heyitsarthur/COEN490/490_0/Parts/Symbols/Datasheets/TP4056-Mini-USB-1.png

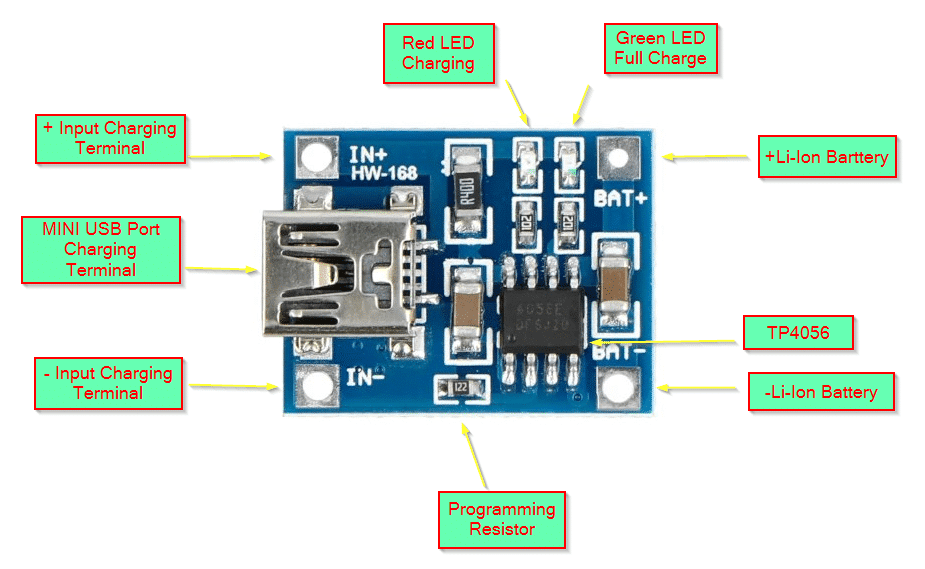
490_0/Parts/Symbols/Datasheets/TP4056-Mini-USB-1.png
