heyitsarthur/COEN490/PCB Footprint Errors.jpg

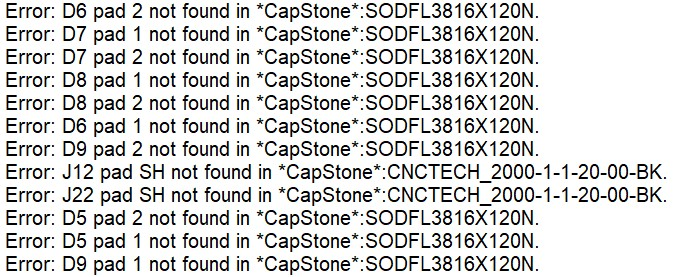
PCB Footprint Errors.jpg
