heyitsarthur/COEN490/PCB Overview Progress.jpg

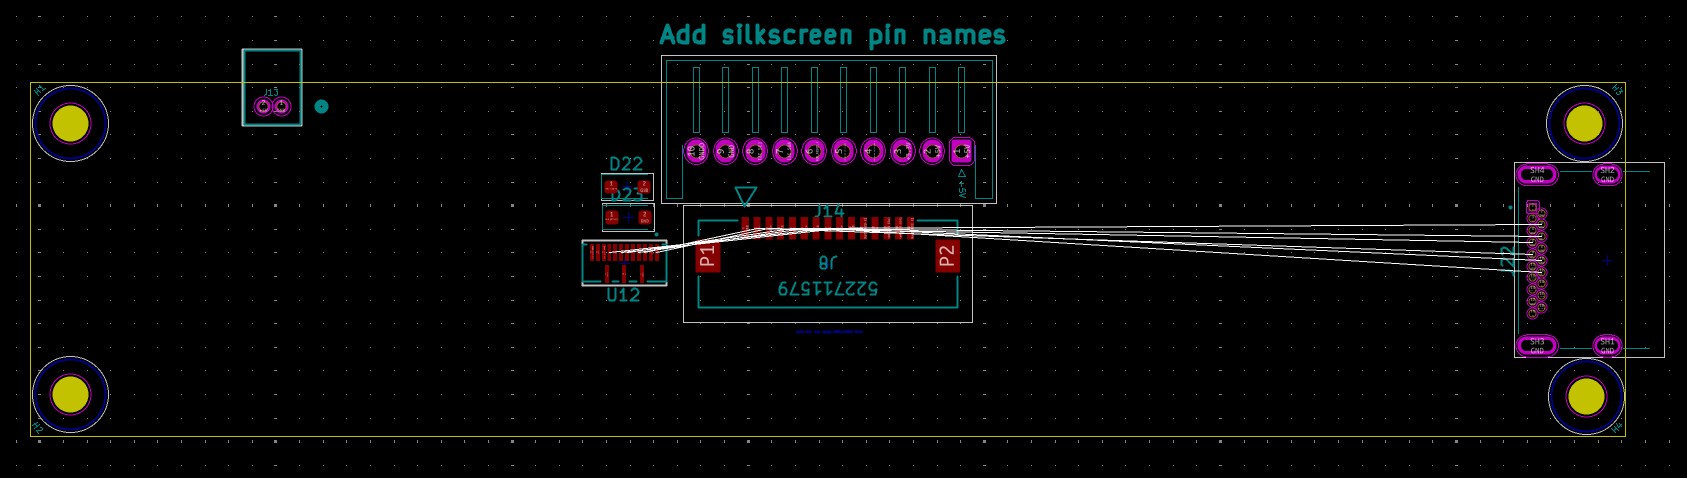
PCB Overview Progress.jpg
