heyitsarthur/COEN490/Schematic_BOM_BlockDiagram/490-24_Bill_of_Materials - External Components.xls

Company: | Concordia University, Department of Electrical and Computer Engineering
Project: | Object Recognition and Haptic Guidance Headband for Blind Users #24
Design ref.: | External Components
Prepared by: | Arthur Mosnier, Ferhaan Hawas, Frankies Vat, Anass Taoussi, Gabriel Lemieux, Ardalan Jamshidi
Rev.# | 3 | Date: | March 3, 2026
Approved by:
Item # | Design Refererence # | Description | Value | QTY | Unit | Manufacturer | Manufacturer Part# | Package | Type | Supplier | Supplier P/N | Price | Ext.price | Link
1 | LS1 | SPEAKER 8OHM 1W TOP PORT 90DB | SP-3605 | 1 | pcs | Soberton Inc. | SP-3605 | Tray |  | DigiKey | 433-1150-ND | 3.16 | 3.16 | https://www.digikey.ca/en/products/detail/soberton-inc/SP-3605/6562949
2 | MOD1 | RASPBERRY PI COMPUTE MOD 4; RAM:8GB; eMMC:16GB; WiFi enabled | CM4108016 | 1 | pcs | Raspberry Pi | SC0677 |  |  | DigiKey | 2648-SC0677-ND | 130 | 130 | https://www.digikey.ca/en/products/detail/raspberry-pi/SC0677/13530927
3 | BT1 | 7.4V 3000mAh 15C 2S JST-2P Plug Li-ion Battery with USB Charging Cable for RC Car, Truck, Ship & Drone | 7.4V 3000mAh 15C 2S | 1 | pcs | AMZZN | 732367471666 |  | 2S1P | Amazon | B0D4M26GF6 | 16.79 | 16.79 | https://www.amazon.ca/AMZZN-3000mAh-Battery-Charging-Engineering/dp/B0D4M26GF6?s=electronics
4 | IO1 | Raspberry Pi Compute Module 4 Carrier Board Interface Raspberry Pi Compute Module 4 Platform Evaluation Expansion Board | SC0326 | 1 | pcs | Raspberry Pi | SC0326 |  | IO BOARD | DigiKey | 2648-SC0326-ND | 35 | 35 | https://www.amazon.ca/AMZZN-3000mAh-Battery-Charging-Engineering/dp/B0D4M26GF6?s=electronics
5 | W1-3 | Black 22 AWG Jumper Lead Socket to Socket Tin 12.0" (304.8mm) | 12.0" (304.8mm) | 3 | pcs | JST Sales America Inc. | ASXHSXH22K305 | Bulk | JUMPER SXH-001T-P0.6 X2 12" | DigiKey | 455-3241-ND | 0.81 | 2.43 | https://www.digikey.ca/en/products/detail/jst-sales-america-inc/ASXHSXH22K305/6684932
6 | JP1, JP2 | CONN JUMPER SHORTING .100" GOLD | QPC02SXGN-RC | 2 | pcs | Sullins Connector Solutions | QPC02SXGN-RC | Bulk | 2 (1 x 2) Position Shunt Connector Black Open Top 0.100" (2.54mm) Gold | DigiKey | S9337-ND | 0.1 | 0.2 | https://www.digikey.ca/en/products/detail/sullins-connector-solutions/QPC02SXGN-RC/2618262
7 | J1,J2 | 3 Rectangular Connectors - Housings Receptacle Natural 0.098" (2.50mm) | XHP-3 | 2 | pcs | JST Sales America Inc. | XHP-3 | Bulk | CONN RCPT HSG 3POS 2.50MM | DigiKey | 455-2219-ND | 0.1 | 0.2 | https://www.digikey.ca/en/products/detail/jst-sales-america-inc/xhp-3/1651017
8
9
10
11
12
 |  |  |  |  |  |  |  |  |  |  |  | Total: | 187.7800
 |  |  |  |  | This is optional information. You don't have to include it.
 |  |  |  | Board summary
 |  |  |  | Total # of components to install |  | 0 |  | Total BOM items to install |  |  | 0
 |  |  |  |  | SMD | 0 |  |  |  | SMD | 0
 |  |  |  |  | thru-hole | 0 |  |  |  | Throu-hole | 0
