heyitsarthur/COEN490/Schematic_BOM_BlockDiagram/490-24_Bill_of_Materials - PCB1.xls

Company: | Concordia University, Department of Electrical and Computer Engineering
Project: | Object Recognition and Haptic Guidance Headband for Blind Users #24
Design ref.: | PCB 1 - CHEST
Prepared by: | Arthur Mosnier, Ferhaan Hawas, Frankies Vat, Anass Taoussi, Gabriel Lemieux, Ardalan Jamshidi
Rev.# | 5 | Date: | March 22, 2026
Approved by:
Item # | Design Refererence # | Description | Value | QTY | Unit | Manufacturer | Manufacturer Part# | Package | Type | Supplier | Supplier P/N | Price | Ext.price | Link
1 | U18 | TVS DIODE 5.5VWM 15SON | TPD8S009DSMR | 1 | pcs | Texas Instruments | TPD8S009DSMR | 15-SMD, No Lead | SMD | DigiKey | 296-23829-1-ND | 1.8200 | 1.8200 | https://www.digikey.ca/en/products/detail/texas-instruments/TPD8S009DSMR/1907466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
2 | D24 | TVS DIODE 3.3VWM 8.8VC SOD123FL | GSMF3.3A | 1 | pcs | Good-Ark Semiconductor | GSMF3.3A | SOD-123FL | SMD | DigiKey | 4786-GSMF3.3ACT-ND | 0.2200 | 0.2200 | https://www.digikey.ca/en/products/detail/good-ark-semiconductor/GSMF3-3A/24613089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
4 | J20 | TERM BLK 2POS SIDE ENT 3.5MM PCB | YO0201500000G | 1 | pcs | Amphenol Anytek | YO0201500000G | Bulk | Through Hole | DigiKey | 609-4725-ND | 0.6400 | 0.6400 | https://www.digikey.ca/en/products/detail/amphenol-anytek/YO0201500000G/4242160?gclsrc=aw.ds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
5 | SW2,SW3,SW4,SW5,SW6,SW7,SW8 | Tactile Switch SPST-NO Top Actuated Through Hole | TL1105LF160Q | 7 | pcs | E-Switch | TL1105LF160Q |  | Through Hole, Right Angle | DigiKey | EG2505-ND | 0.3300 | 2.3100 | https://www.digikey.ca/en/products/detail/e-switch/tl1105lf160q/378971
6 | SW1 | Switch, dual pole double throw, separate symbols | TL2230EEF140 | 1 | pcs | E-Switch | TL2230EEF140 | Bulk | Through Hole | DigiKey | EG6031-ND | 0.8500 | 0.8500 | https://www.digikey.ca/en/products/detail/e-switch/TL2230EEF140/4029358
7 | R27 | RES SMD 27.4K OHM 0.1% 1/4W 0805 | 27.4k | 1 | pcs | Panasonic Electronic Components | ERJ-PB6B2742V | 0805 | SMD | DigiKey | P20756CT-ND | 0.2100 | 0.2100 | https://www.digikey.ca/en/products/detail/panasonic-electronic-components/ERJ-PB6B2742V/6213539
8 | R29 | RES SMD 15K OHM 1% 1/8W 0805 | 15k | 1 | pcs | YAGEO | AC0805FR-0715KL | 0805 | SMD | DigiKey | YAG3695CT-ND | 0.1000 | 0.1000 | https://www.digikey.ca/en/products/detail/yageo/AC0805FR-0715KL/5896576
9 | R8 | RES 76.8K OHM 1% 1/8W 0805 | 76.8k | 1 | pcs | YAGEO | RC0805FR-0776K8L | 0805 | SMD | DigiKey | 311-76.8KCRCT-ND | 0.1000 | 0.1000 | https://www.digikey.ca/en/products/detail/yageo/RC0805FR-0776K8L/728137
10 | R37,R44 | RES 470 OHM 1% 1/8W 0805 | 470 | 2 | pcs | YAGEO | RC0805FR-07470RL | 0805 | SMD | DigiKey | RC0805FR-07470RL | 0.1000 | 0.2000 | https://www.digikey.ca/en/products/detail/yageo/RC0805FR-07470RL/727976
11 | R25 | RES 30K OHM 1% 1/8W 0805 | 30k | 1 | pcs | YAGEO | RC0805FR-1330KL | 0805 | SMD | DigiKey | 13-RC0805FR-1330KLCT-ND | 0.1000 | 0.1000 | https://www.digikey.ca/en/products/detail/yageo/RC0805FR-1330KL/17020068
12 | R24 | RES 30.1K OHM 1% 1/8W 0805 | 30.1k | 1 | pcs | YAGEO | RC0805FR-0730K1L | 0805 | SMD | DigiKey | 311-30.1KCRCT-ND | 0.1000 | 0.1000 | https://www.digikey.ca/en/products/detail/yageo/RC0805FR-0730K1L/727845
13 | R9 | RES 24.3K OHM 1% 1/8W 0805 | 24.3k | 1 | pcs | YAGEO | RC0805FR-0724K3L | 0805 | SMD | DigiKey | 311-24.3KCRCT-ND | 0.1000 | 0.1000 | https://www.digikey.ca/en/products/detail/yageo/RC0805FR-0724K3L/727758
14 | R22 | RES 220K OHM 1% 1/8W 0805 | 220k | 1 | pcs | YAGEO | RC0805FR-07220KL | 0805 | SMD | DigiKey | 311-220KCRCT-ND | 0.1000 | 0.1000 | https://www.digikey.ca/en/products/detail/yageo/RC0805FR-07220KL/727742
15 | R2,R36 | RES 215K OHM 1% 1/8W 0805 | 215k | 2 | pcs | YAGEO | RC0805FR-07215KL | 0805 | SMD | DigiKey | 311-215KCRCT-ND | 0.1000 | 0.2000 | https://www.digikey.ca/en/products/detail/yageo/RC0805FR-07215KL/727734
16 | R35 | RES 120K OHM 1% 1/8W 0805 | 120k | 1 | pcs | YAGEO | RC0805FR-07120KL | 0805 | SMD | DigiKey | 311-120KCRCT-ND | 0.1000 | 0.1000 | https://www.digikey.ca/en/products/detail/yageo/RC0805FR-07120KL/727576
17 | R10,R26,R32 | RES 10K OHM 1% 1/8W 0805 | 10k | 3 | pcs | YAGEO | RC0805FR-0710KL | 0805 | SMD | DigiKey | 311-10.0KCRCT-ND | 0.1400 | 0.4200 | https://www.digikey.ca/en/products/detail/yageo/RC0805FR-0710KL/727535
18 | R1,R23 | RES 100K OHM 1% 1/8W 0805 | 100k | 2 | pcs | YAGEO | RC0805FR-07100KL | 0805 | SMD | DigiKey | 311-100KCRCT-ND | 0.1000 | 0.2000 | https://www.digikey.ca/en/products/detail/yageo/RC0805FR-07100KL/727544
19 | R28,R30,R31,R33,R34 | RES 1.5K OHM 1% 1/8W 0805 | 1.5k | 5 | pcs | YAGEO | RC0805FR-071K5L | 0805 | SMD | DigiKey | 311-1.50KCRCT-ND | 0.1000 | 0.5000 | https://www.digikey.ca/en/products/detail/yageo/RC0805FR-071K5L/727496
20 | Q6 | P-Channel 50 V 130mA (Ta) 225mW (Ta) Surface Mount SOT-23-3 (TO-236) | BSS84 | 1 | pcs | onsemi | BSS84 | SOT-23-3 (TO-236) | SMD | DigiKey | BSS84CT-ND | 0.3400 | 0.3400 | https://www.digikey.ca/en/products/detail/onsemi/bss84/244213
23 | D15 | LED YELLOW CLEAR SMD | LTST-C170YKT | 1 | pcs | Lite-On Inc. | LTST-C170YKT | SMD | 0805 (2012 Metric) | DigiKey | 160-1175-1-ND | 0.1500 | 0.1500 | https://www.digikey.ca/en/products/detail/lite-on-inc/LTST-C170YKT/269222
24 | D17 | LED RED CLEAR SMD | LTST-C170KRKT | 1 | pcs | Lite-On Inc. | LTST-C170KRKT | SMD | 0805 (2012 Metric) | DigiKey | 160-1415-1-ND | 0.1600 | 0.1600 | https://www.digikey.ca/en/products/detail/liteon/LTST-C170KRKT/386779
25 | D11,D12,D13,D14,D16 | LED GREEN CLEAR SMD | LTST-C170GKT | 5 | pcs | Lite-On Inc. | LTST-C170GKT | SMD | 0805 (2012 Metric) | DigiKey | 160-1179-1-ND | 0.1000 | 0.5000 | https://www.digikey.ca/en/products/detail/liteon/LTST-C170GKT/269226
26 | U5 | IC USB SWITCH DUAL 1X2 10UQFN | TS3USB221AQRSERQ1 | 1 | pcs | Texas Instruments | TS3USB221AQRSERQ1 | 10-UFQFN | SMD | DigiKey | 296-27719-1-ND | 0.9000 | 0.9000 | https://www.digikey.ca/en/products/detail/texas-instruments/TS3USB221AQRSERQ1/2356129
27 | U7 | IC REG BUCK ADJ 6A SOT563 | TPS566247DRLR | 1 | pcs | Texas Instruments | TPS566247DRLR | SOT-563 | SMD | DigiKey | 296-TPS566247DRLRCT-ND | 0.7700 | 0.7700 | https://www.digikey.ca/en/products/detail/texas-instruments/TPS566247DRLR/16553859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
28 | U8 | IC BATT CHG LI-ION 2CELL 26QFN | MP2639AGR-Z | 1 | pcs | Monolithic Power Systems Inc. | MP2639AGR-Z | 26-PowerVFQFN | SMD | DigiKey | 1589-1618-1-ND | 3.4900 | 3.4900 | https://www.digikey.ca/en/products/detail/monolithic-power-systems-inc/MP2639AGR-Z/7690044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
29 | J12,J14 | HDMI Receptacle Connector 19 Position Through Hole, Right Angle | 2000-1-1-20-00-BK | 2 | pcs | CNC Tech | 2000-1-1-20-00-BK | Tray | Through Hole, Right Angle | DigiKey | 1175-1700-ND | 1.9900 | 3.9800 | https://www.digikey.ca/en/products/detail/cnc-tech/2000-1-1-20-00-BK/4867009
30 | L1,L2 | FIXED IND 2.2UH 9A 15.5 MOHM SMD | 2.2u | 2 | pcs | Bourns Inc. | SRP6540-2R2M | Nonstandard | SMD | DigiKey | SRP6540-2R2MCT-ND | 1.1100 | 2.2200 | https://www.digikey.ca/en/products/detail/bourns-inc/srp6540-2r2m/3986093
31 | D10 | DIODE SCHOTTKY 30V 3A SMB | B330B-13-F | 1 | pcs | Diodes Incorporated | B330B-13-F | DO-214AA, SMB | SMD | DigiKey | B330B-FDICT-ND | 0.4400 | 0.4400 | https://www.digikey.ca/en/products/detail/diodes-incorporated/b330b-13-f/724947
32 | J7 | CONN RCPT USB2.0 MICRO B SMD R/A | 629105150521 | 1 | pcs | WÃ¼rth Elektronik | 629105150521 |  | Surface Mount, Right Angle; Through Hole | DigiKey | 732-5960-1-ND | 2.2100 | 2.2100 | https://www.digikey.ca/en/products/detail/w%C3%BCrth-elektronik/629105150521/5047751
33 | J16,J17 | CONN RCPT 100POS SMD GOLD | DF40HC(3.0)-100DS-0.4V(58) | 2 | pcs | Hirose Electric Co Ltd | DF40HC(3.0)-100DS-0.4V(58) |  | SMD | DigiKey | H124602CT-ND | 2.7200 | 5.4400 | https://www.digikey.ca/en/products/detail/hirose-electric-co-ltd/DF40HC-3-0-100DS-0-4V-58/4282912
34 | J18 | CONN HEADER VERT 3POS 2.54MM | TS-103-G-A | 1 | pcs | Samtec Inc. | TS-103-G-A |  | Through Hole | DigiKey | SAM1111-03-ND | 1.2700 | 1.2700 | https://www.digikey.ca/en/products/detail/samtec-inc/TS-103-G-A/1105459
35 | J21 | CONN HEADER VERT 2POS 2.54MM | TS-102-G-A | 1 | pcs | Samtec Inc. | TS-102-G-A |  | Through Hole | DigiKey | SAM1111-02-ND | 0.9500 | 0.9500 | https://www.digikey.ca/en/products/detail/samtec-inc/ts-102-g-a/1105460
36 | J11,J15 | CONN HEADER R/A 3POS 2.5MM | S3B-XH-A | 2 | pcs | JST Sales America Inc. | S3B-XH-A | Bulk | Through Hole, Right Angle | DigiKey | 455-S3B-XH-A-ND | 0.1500 | 0.3000 | https://www.digikey.ca/en/products/detail/jst-sales-america-inc/S3B-XH-A/1651048
38 | U9,U10 | CMC 100MA 4LN SMD ESD | EMI8142MUTAG | 2 | pcs | onsemi | EMI8142MUTAG | 10-XFDFN | SMD | DigiKey | EMI8142MUTAGOSCT-ND | 0.9700 | 1.9400 | https://www.digikey.ca/en/products/detail/onsemi/EMI8142MUTAG/5257557
39 | C45,C47,C50 | CAP CER 4.7UF 10V X7R 0603 | 4.7u | 3 | pcs | Murata Electronics | GRM188Z71A475KE15D | 0603 (1608 Metric) | SMD, MLCC | DigiKey | 490-GRM188Z71A475KE15DCT-ND | 0.2200 | 0.6600 | https://www.digikey.ca/en/products/detail/murata-electronics/GRM188Z71A475KE15D/13904882
40 | C36 | CAP CER 33PF 50V C0G/NP0 0603 | 33pF | 1 | pcs | KEMET | 399-C0603C330J5GACTUCT-ND | 0603 | SMD, MLCC | DigiKey | 399-C0603C330J5GACTUCT-ND | 0.1200 | 0.1200 | https://www.digikey.ca/en/products/detail/kemet/c0603c330j5gactu/411057
41 | C44 | CAP CER 22UF 25V X7R 1210 | 22u | 1 | pcs | Taiyo Yuden | TMK325B7226KM-PR | 1210 (3225 Metric) | SMD, MLCC | DigiKey | 587-5480-1-ND | 0.5800 | 0.5800 | https://www.digikey.ca/en/products/detail/taiyo-yuden/TMK325B7226KM-PR/7067065
42 | C37,C38,C39,C40,C46 | CAP CER 22UF 16V X7R 1210 | 22u | 5 | pcs | Samsung Electro-Mechanics | CL32B226MOJNNNE | 1210 (3225 Metric) | SMD, MLCC | DigiKey | 1276-3395-1-ND | 0.4100 | 2.0500 | https://www.digikey.ca/en/products/detail/samsung-electro-mechanics/CL32B226MOJNNNE/3889053
43 | C48 | CAP CER 1UF 50V X7R 0603 | 1u | 1 | pcs | Taiyo Yuden | UMK107AB7105KA-T | 0603 | SMD, MLCC | DigiKey | 587-3247-1-ND | 0.0800 | 0.0800 | https://www.digikey.ca/en/products/detail/taiyo-yuden/UMK107AB7105KA-T/3660085
44 | C43 | CAP CER 1UF 25V X7R 1206 | 1u | 1 | pcs | Samsung Electro-Mechanics | CL31B105KAHNNNE | 1206 (3216 Metric) | SMD, MLCC | DigiKey | 1276-1097-1-ND | 0.1300 | 0.1300 | https://www.digikey.ca/en/products/detail/samsung-electro-mechanics/CL31B105KAHNNNE/3886755
45 | C32,C33,C34 | CAP CER 10UF 25V X7R 1206 | 10u | 3 | pcs | Samsung Electro-Mechanics | CL31B106KAHNNNE | 1206 (3216 Metric) | SMD, MLCC | DigiKey | 1276-1804-1-ND | 0.0800 | 0.2400 | https://www.digikey.ca/en/products/detail/samsung-electro-mechanics/CL31B106KAHNNNE/3887462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
46 | C2,C6 | CAP CER 10UF 16V X7R 0805 | 10u | 2 | pcs | Samsung Electro-Mechanics | CL21B106KOQNNNE | 0805 | SMD, MLCC | DigiKey | 1276-2872-1-ND | 0.2200 | 0.4400 | https://www.digikey.ca/en/products/detail/samsung-electro-mechanics/CL21B106KOQNNNE/3888530
47 | C5,C7,C25,C26,C27,C28,C29,C30,C35,C41,C42,C49,C55 | CAP CER 0.1UF 50V X7R 0603 | 100n | 13 | pcs | YAGEO | CC0603KRX7R9BB104 | 0603 (1608 Metric) | SMD, MLCC | DigiKey | 311-1344-1-ND | 0.0800 | 1.0400 | https://www.digikey.ca/en/products/detail/yageo/CC0603KRX7R9BB104/2103082
48 | U1 | Amplifier IC 1-Channel (Mono) Class D 16-TQFN (3x3) | MAX98357A | 1 | pcs | Analog Devices Inc./Maxim Integrated | MAX98357AETE+T | 16-WFQFN Exposed Pad | SMD | DigiKey | MAX98357AETE+TCT-ND | 3.1900 | 3.1900 | https://www.digikey.ca/en/products/detail/analog-devices-inc-maxim-integrated/MAX98357AETE-T/4936122
49 | U11,U13,U14,U19 | 15V Clamp 2.5A (8/20Âµs) Ipp Tvs Diode Surface Mount SOT-553 | SP3003-02XTG | 4 | pcs | Littelfuse Inc. | SP3003-02XTG | SOT-553 | SMD | DigiKey | F3302CT-ND | 0.7000 | 2.8000 | https://www.digikey.ca/en/products/detail/littelfuse-inc/SP3003-02XTG/2060912
 |  |  |  |  |  |  |  |  |  |  |  |  | 0.0000
 |  |  |  |  |  |  |  |  |  |  |  |  | 0.0000
 |  |  |  |  |  |  |  |  |  |  |  |  | 0.0000
 |  |  |  |  |  |  |  |  |  |  |  |  | 0.0000
 |  |  |  |  |  |  |  |  |  |  |  |  | 0.0000
 |  |  |  |  |  |  |  |  |  |  |  | Total: | 44.6600
 |  |  |  |  | This is optional information. You don't have to include it.
 |  |  |  | Board summary
 |  |  |  | Total # of components to install |  | 0 |  | Total BOM items to install |  |  | 0
 |  |  |  |  | SMD | 0 |  |  |  | SMD | 0
 |  |  |  |  | thru-hole | 0 |  |  |  | Throu-hole | 0
