heyitsarthur/COEN490/Schematic_BOM_BlockDiagram/490-24_Bill_of_Materials - PCB2.xls

Company: | Concordia University, Department of Electrical and Computer Engineering
Project: | Object Recognition and Haptic Guidance Headband for Blind Users #24
Design ref.: | PCB 2 - GLASSES
Prepared by: | Arthur Mosnier, Ferhaan Hawas, Frankies Vat, Anass Taoussi, Gabriel Lemieux, Ardalan Jamshidi
Rev.# | 5 | Date: | March 22, 2026
Approved by:
Item # | Design Refererence # | Description | Value | QTY | Unit | Manufacturer | Manufacturer Part# | Package | Type | Supplier | Supplier P/N | Price | Ext.price | Link
1 | U12 | TVS DIODE 5.5VWM 15SON | TPD8S009DSMR | 1 | pcs | Texas Instruments | TPD8S009DSMR | 15-SMD, No Lead | SMD | DigiKey | 296-23829-1-ND | 1.8200 | 1.8200 | https://www.digikey.ca/en/products/detail/texas-instruments/TPD8S009DSMR/1907466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
2 | D22,D23 | TVS DIODE 3.3VWM 8.8VC SOD123FL | GSMF3.3A | 2 | pcs | Good-Ark Semiconductor | GSMF3.3A | SOD-123FL | SMD | DigiKey | 4786-GSMF3.3ACT-ND | 0.2200 | 0.4400 | https://www.digikey.ca/en/products/detail/good-ark-semiconductor/GSMF3-3A/24613089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
4 | R11 | RES 330 OHM 1% 1/8W 0805 | 330 | 1 | pcs | YAGEO | RC0805FR-13330RL | 0805 | SMD | DigiKey | 13-RC0805FR-13330RLCT-ND | 0.1000 | 0.1000 | https://www.digikey.ca/en/products/detail/yageo/RC0805FR-13330RL/14286486
5 | R12,R13,R14,R18,R19 | RES 220 OHM 1% 1/8W 0805 | 220 | 5 | pcs | TE Connectivity Passive Product | CRGCQ0805F220R | 0805 | SMD | DigiKey | A129741CT-ND | 0.1000 | 0.5000 | https://www.digikey.ca/en/products/detail/te-connectivity-passive-product/CRGCQ0805F220R/8576343
6 | R4,R6 | RES 20K OHM 1% 1/4W 0805 | 20k | 2 | pcs | YAGEO | RC0805FR-7W20KL | 0805 | SMD | DigiKey | 13-RC0805FR-7W20KLCT-ND | 0.1100 | 0.2200 | https://www.digikey.ca/en/products/detail/yageo/RC0805FR-7W20KL/17021842
7 | R3,R5 | RES 1K OHM 1% 1/8W 0805 | 1k | 2 | pcs | YAGEO | RC0805FR-071KL | 0805 | SMD | DigiKey | 311-1.00KCRCT-ND | 0.1000 | 0.2000 | https://www.digikey.ca/en/products/detail/yageo/RC0805FR-071KL/727444
8 | R7 | RES 12K OHM 1% 1/8W 0805 | 12k | 1 | pcs | YAGEO | RC0805FR-0712KL | 0805 | SMD | DigiKey | 311-12.0KCRCT-ND | 0.1000 | 0.1000 | https://www.digikey.ca/en/products/detail/yageo/RC0805FR-0712KL/727568
9 | R42,R43,R45,R46 | RES 10K OHM 1% 1/8W 0805 | 10k | 4 | pcs | YAGEO | RC0805FR-0710KL | 0805 | SMD | DigiKey | 311-10.0KCRCT-ND | 0.1400 | 0.5600 | https://www.digikey.ca/en/products/detail/yageo/RC0805FR-0710KL/727535
10 | R15,R16,R17,R20,R21,R39,R40 | RES 100K OHM 1% 1/8W 0805 | 100k | 7 | pcs | YAGEO | RC0805FR-07100KL | 0805 | SMD | DigiKey | 311-100KCRCT-ND | 0.1000 | 0.7000 | https://www.digikey.ca/en/products/detail/yageo/RC0805FR-07100KL/727544
11 | R41 | RES 1.5K OHM 1% 1/8W 0805 | 1.5k | 1 | pcs | YAGEO | RC0805FR-071K5L | 0805 | SMD | DigiKey | 311-1.50KCRCT-ND | 0.1000 | 0.1000 | https://www.digikey.ca/en/products/detail/yageo/RC0805FR-071K5L/727496
12 | Q1,Q2,Q3,Q4,Q5 | MOSFET N-CH 30V 5.7A SOT23-3L | AO3400A | 5 | pcs | Alpha & Omega Semiconductor Inc. | AO3400A | SOT-23-3 | SMD | DigiKey | 785-1000-1-ND | 0.4600 | 2.3000 | https://www.digikey.ca/en/products/detail/alpha-omega-semiconductor-inc/ao3400a/1855772
13 | D18 | LED GREEN CLEAR SMD | LTST-C170GKT | 1 | pcs | Lite-On Inc. | LTST-C170GKT | SMD | 0805 (2012 Metric) | DigiKey | 160-1179-1-ND | 0.1000 | 0.1000 | https://www.digikey.ca/en/products/detail/liteon/LTST-C170GKT/269226
14 | D1,D2 | LED BLUE CLEAR SMD | LTST-C170TBKT | 2 | pcs | Lite-On Inc. | LTST-C170TBKT | SMD | 0805 (2012 Metric) | DigiKey | 160-1579-1-ND | 0.2200 | 0.4400 | https://www.digikey.ca/en/products/detail/lite-on-inc/ltst-c170tbkt/388527?_gl=1*13wf1ri*_up*MQ..*_gs*MQ..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
15 | U2,U3 | IC PWR SWITCH N-CHAN 1:1 SOT23-6 | TPS2553DBVR | 2 | pcs | Texas Instruments | TPS2553DBVR | SOT-23-6 | SMD | DigiKey | 296-32464-1-ND | 0.9700 | 1.9400 | https://www.digikey.ca/en/products/detail/texas-instruments/TPS2553DBVR/2047900
16 | U6 | IC LED DRVR LIN PWM 25MA 28TSSOP | PCA9685 | 1 | pcs | NXP USA Inc. | PCA9685PW,118 | 28-TSSOP (0.173", 4.40mm Width) | SMD | DigiKey | 568-11925-1-ND | 3.0400 | 3.0400 | https://www.digikey.ca/en/products/detail/nxp-usa-inc/PCA9685PW-118/2034325
17 | U4 | IC HUB CTLR 2PORT USB 2.0 HS 36S | USB2512B-I/M2 | 1 | pcs | Microchip Technology | USB2512B-I/M2 | 36-VFQFN Exposed Pad | SMD | DigiKey | USB2512B-I/M2-ND | 2.3800 | 2.3800 | https://www.digikey.ca/en/products/detail/microchip-technology/USB2512B-I-M2/5639464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
18 | J22 | HDMI Receptacle Connector 19 Position Through Hole, Right Angle | 2000-1-1-20-00-BK | 1 | pcs | CNC Tech | 2000-1-1-20-00-BK | Tray | Through Hole, Right Angle | DigiKey | 1175-1700-ND | 1.9900 | 1.9900 | https://www.digikey.ca/en/products/detail/cnc-tech/2000-1-1-20-00-BK/4867009
19 | D5,D6,D7,D8,D9 | DIODE STANDARD 75V 150MA SOD123F | 1N4148W | 5 | pcs | Diotec Semiconductor | 1N4148W | SOD-123F | SMD | DigiKey | 4878-1N4148WCT-ND | 0.1000 | 0.5000 | https://www.digikey.ca/en/products/detail/diotec-semiconductor/1n4148w/18833653
20 | Y1 | CRYSTAL 24MHZ 20PF SMD 3.2X2.5MM | 24M20P2/XT324-10/10 | 1 | pcs | YIC | 24M20P2/XT324-10/10 | 4-SMD, No Lead | SMD | DigiKey | 3155-24M20P2/XT324-10/10CT-ND | 0.1200 | 0.1200 | https://www.digikey.ca/en/products/detail/yic/24M20P2-XT324-10-10/13980850
22 | J23 | CONN HEADER R/A 3POS 2.5MM | S3B-XH-A | 1 | pcs | JST Sales America Inc. | S3B-XH-A | Bulk | Through Hole, Right Angle | DigiKey | 455-S3B-XH-A-ND | 0.1500 | 0.1500 | https://www.digikey.ca/en/products/detail/jst-sales-america-inc/S3B-XH-A/1651048
23 | J4,J5,J6,J9,J10 | CONN HEADER R/A 2POS 2.5MM | PAD | 5 | pcs | JST Sales America Inc. | S2B-XH-A | Bulk | Through Hole, Right Angle | DigiKey | 455-S2B-XH-A-ND | 0.1200 | 0.6000 | https://www.digikey.ca/en/products/detail/jst-sales-america-inc/S2B-XH-A/1651055
24 | J13 | CONN HEADER R/A 2POS 1.5MM | S2B-ZR | 1 | pcs | JST Sales America Inc. | S2B-ZR | Bulk | Through Hole, Right Angle | DigiKey | 455-1669-ND | 0.1100 | 0.1100 | https://www.digikey.ca/en/products/detail/jst-sales-america-inc/s2b-zr/926576
25 | J19 | CONN FFC FPC VERT 15POS 1MM SMD | SFW15S-2STE1LF | 1 | pcs | Amphenol ICC (FCI) | SFW15S-2STE1LF |  | SMD | DigiKey | 609-1148-1-ND | 0.5000 | 0.5000 | https://www.digikey.ca/en/products/detail/amphenol-cs-fci/SFW15S-2STE1LF/1001462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
26 | C8,C16 | CAP TANT 120UF 10% 20V 2824 | 120u | 2 | pcs | Vishay Sprague | 594D127X9020R2T | 2824 (7260 Metric) | SMD | DigiKey | 718-594D127X9020R2TCT-ND | 6.9700 | 13.9400 | https://www.digikey.ca/en/products/detail/vishay-sprague/594D127X9020R2T/1577743
27 | C17,C18 | CAP CER 33PF 50V C0G/NP0 0603 | 33pF | 2 | pcs | KEMET | 399-C0603C330J5GACTUCT-ND | 0603 | SMD, MLCC | DigiKey | 399-C0603C330J5GACTUCT-ND | 0.1200 | 0.2400 | https://www.digikey.ca/en/products/detail/kemet/c0603c330j5gactu/411057
28 | C62 | CAP CER 1UF 50V X7R 0603 | 1u | 1 | pcs | Taiyo Yuden | UMK107AB7105KA-T | 0603 | SMD, MLCC | DigiKey | 587-3247-1-ND | 0.0800 | 0.0800 | https://www.digikey.ca/en/products/detail/taiyo-yuden/UMK107AB7105KA-T/3660085
29 | C1,C4,C12,C13,C15,C20,C22,C24 | CAP CER 10UF 16V X7R 0805 | 10u | 8 | pcs | Samsung Electro-Mechanics | CL21B106KOQNNNE | 0805 | SMD, MLCC | DigiKey | 1276-2872-1-ND | 0.2200 | 1.7600 | https://www.digikey.ca/en/products/detail/samsung-electro-mechanics/CL21B106KOQNNNE/3888530
30 | C3,C9,C10,C11,C14,C19,C21,C23,C31,C53,C54,C56,C57,C58,C59,C60,C61,C63,C64 | CAP CER 0.1UF 50V X7R 0603 | 100n | 19 | pcs | YAGEO | CC0603KRX7R9BB104 | 0603 (1608 Metric) | SMD, MLCC | DigiKey | 311-1344-1-ND | 0.0800 | 1.5200 | https://www.digikey.ca/en/products/detail/yageo/CC0603KRX7R9BB104/2103082
31 | D3,D4 | 21.7A 9.2V 6.4V 5V SOD-123FL | SMF5.0A | 2 | pcs | Shenzhen Slkormicro Semicon Co., Ltd. | SMF5.0A | SOD-123FL | SMD | DigiKey | 5399-SMF5.0ACT-ND | 0.1200 | 0.2400 | https://www.digikey.ca/en/products/detail/shenzhen-slkormicro-semicon-co-ltd/SMF5-0A/26601083
32 | U15,U16,U17 | 15V Clamp 2.5A (8/20Âµs) Ipp Tvs Diode Surface Mount SOT-553 | SP3003-02XTG | 3 | pcs | Littelfuse Inc. | SP3003-02XTG | SOT-553 | SMD | DigiKey | F3302CT-ND | 0.7000 | 2.1000 | https://www.digikey.ca/en/products/detail/littelfuse-inc/SP3003-02XTG/2060912
 |  |  |  |  |  |  |  |  |  |  |  |  | 0.0000
 |  |  |  |  |  |  |  |  |  |  |  |  | 0.0000
 |  |  |  |  |  |  |  |  |  |  |  |  | 0.0000
 |  |  |  |  |  |  |  |  |  |  |  |  | 0.0000
 |  |  |  |  |  |  |  |  |  |  |  |  | 0.0000
 |  |  |  |  |  |  |  |  |  |  |  |  | 0.0000
 |  |  |  |  |  |  |  |  |  |  |  |  | 0.0000
 |  |  |  |  |  |  |  |  |  |  |  |  | 0.0000
 |  |  |  |  |  |  |  |  |  |  |  |  | 0.0000
 |  |  |  |  |  |  |  |  |  |  |  |  | 0.0000
 |  |  |  |  |  |  |  |  |  |  |  |  | 0.0000
 |  |  |  |  |  |  |  |  |  |  |  |  | 0.0000
 |  |  |  |  |  |  |  |  |  |  |  |  | 0.0000
 |  |  |  |  |  |  |  |  |  |  |  | Total: | 38.7900
 |  |  |  |  | This is optional information. You don't have to include it.
 |  |  |  | Board summary
 |  |  |  | Total # of components to install |  | 0 |  | Total BOM items to install |  |  | 0
 |  |  |  |  | SMD | 0 |  |  |  | SMD | 0
 |  |  |  |  | thru-hole | 0 |  |  |  | Throu-hole | 0
