heyitsarthur/COEN490/490_0/Parts/Symbols/Datasheets/USB Micro B - for power and programming.jpg

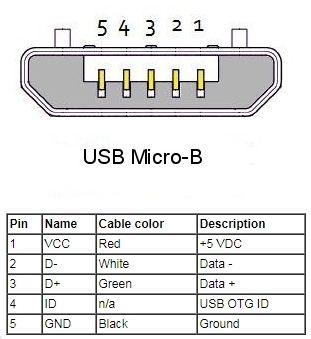
490_0/Parts/Symbols/Datasheets/USB Micro B - for power and programming.jpg
