heyitsarthur/COEN490/Schematic_BOM_BlockDiagram/Glasses PCB layout.jpg

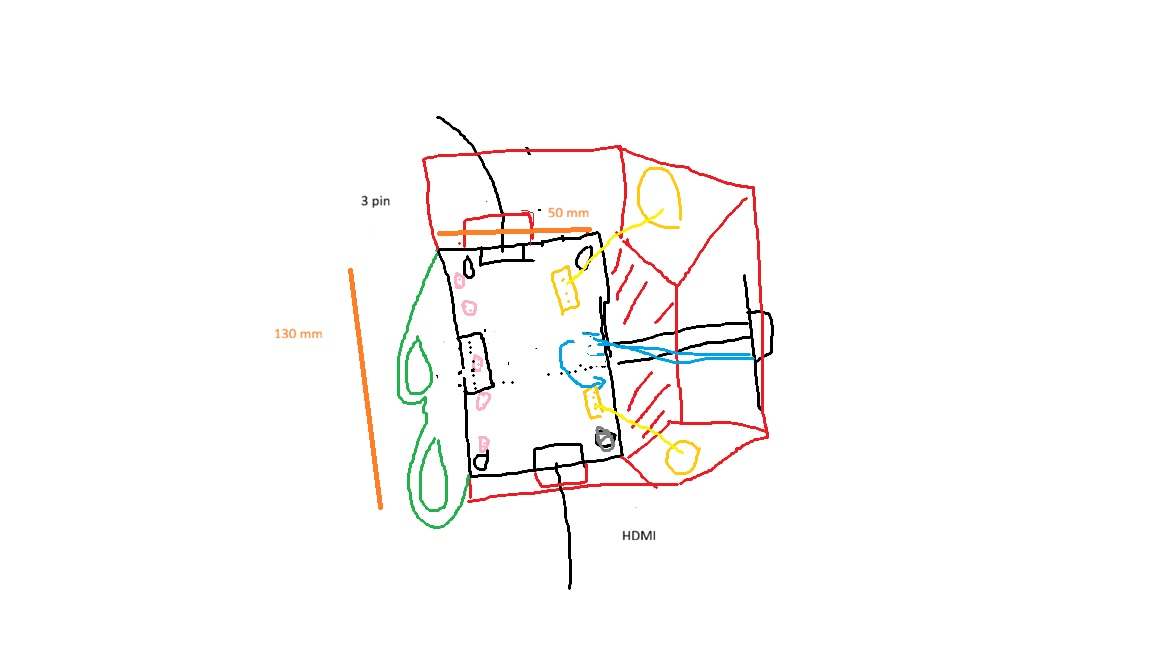
Schematic_BOM_BlockDiagram/Glasses PCB layout.jpg
