heyitsarthur/COEN490/Schematic_BOM_BlockDiagram/V6 System Block Diagram COEN 490 - Revised.drawio.png

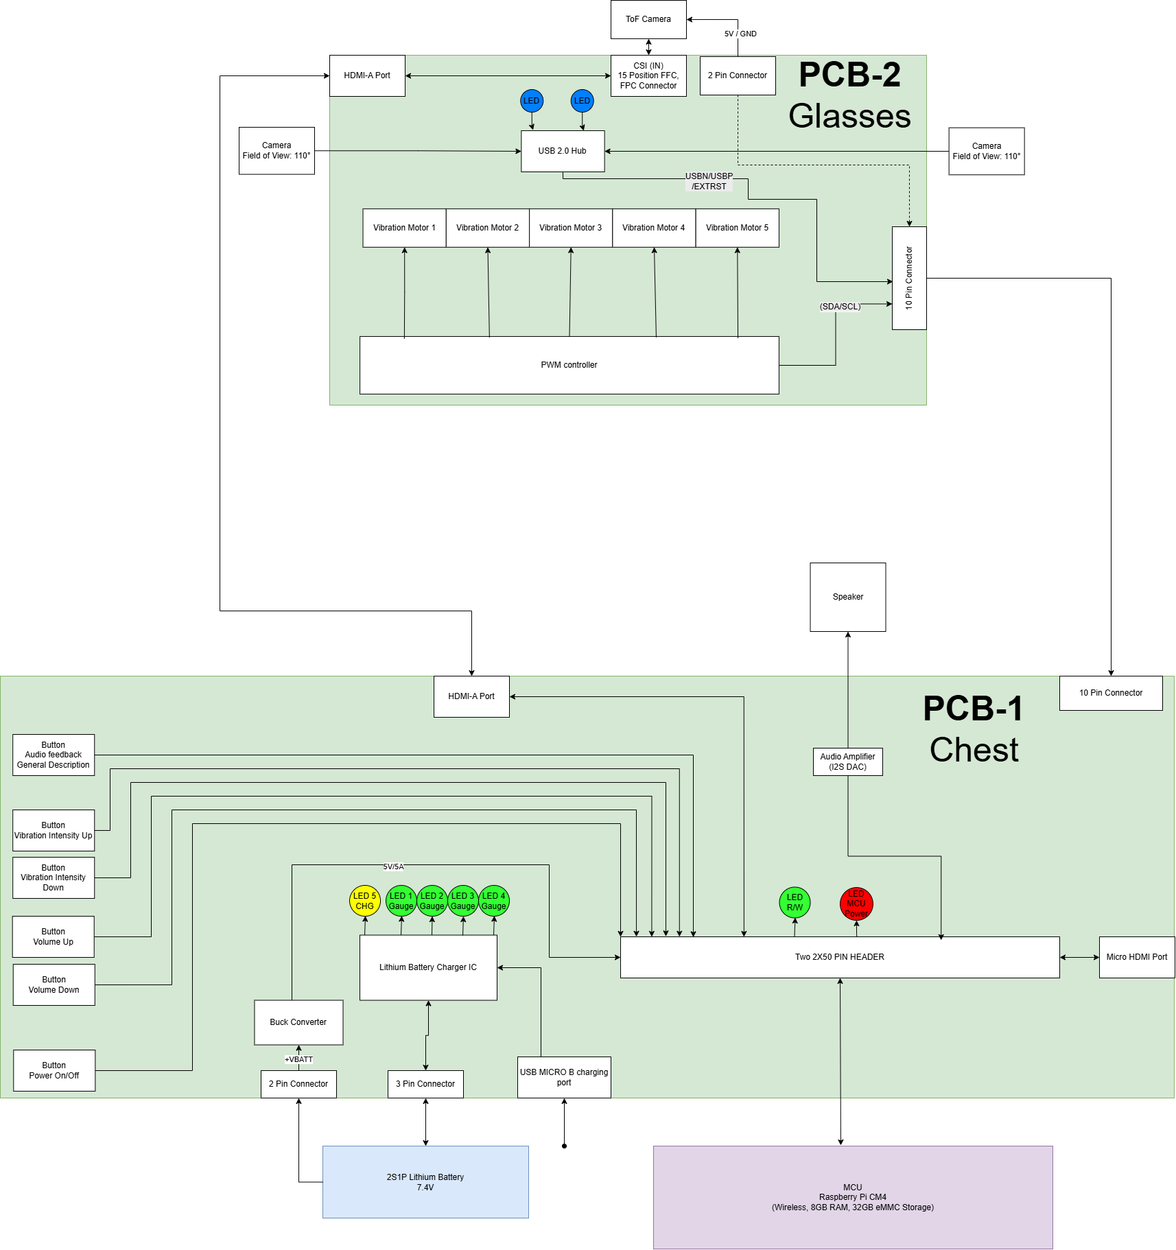
Schematic_BOM_BlockDiagram/V6 System Block Diagram COEN 490 - Revised.drawio.png
