heyitsarthur/COEN490/490_0/Parts/3D Models/2000-1-1-20-00-BK.igs

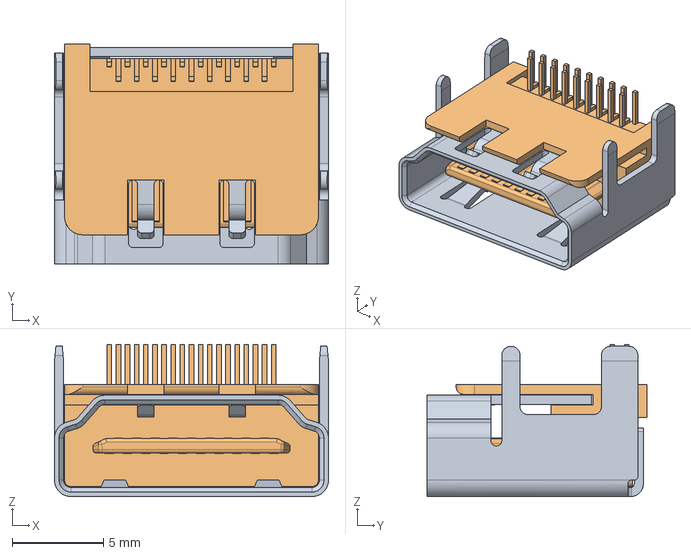
[picture p7: CAD file, 2026-03-20]
490_0/Parts/3D Models/2000-1-1-20-00-BK.igs
15.0 x 12.1 x 8.33 mm
