heyitsarthur/COEN490/Schematic_BOM_BlockDiagram/490-24_Schematic V9.pdf

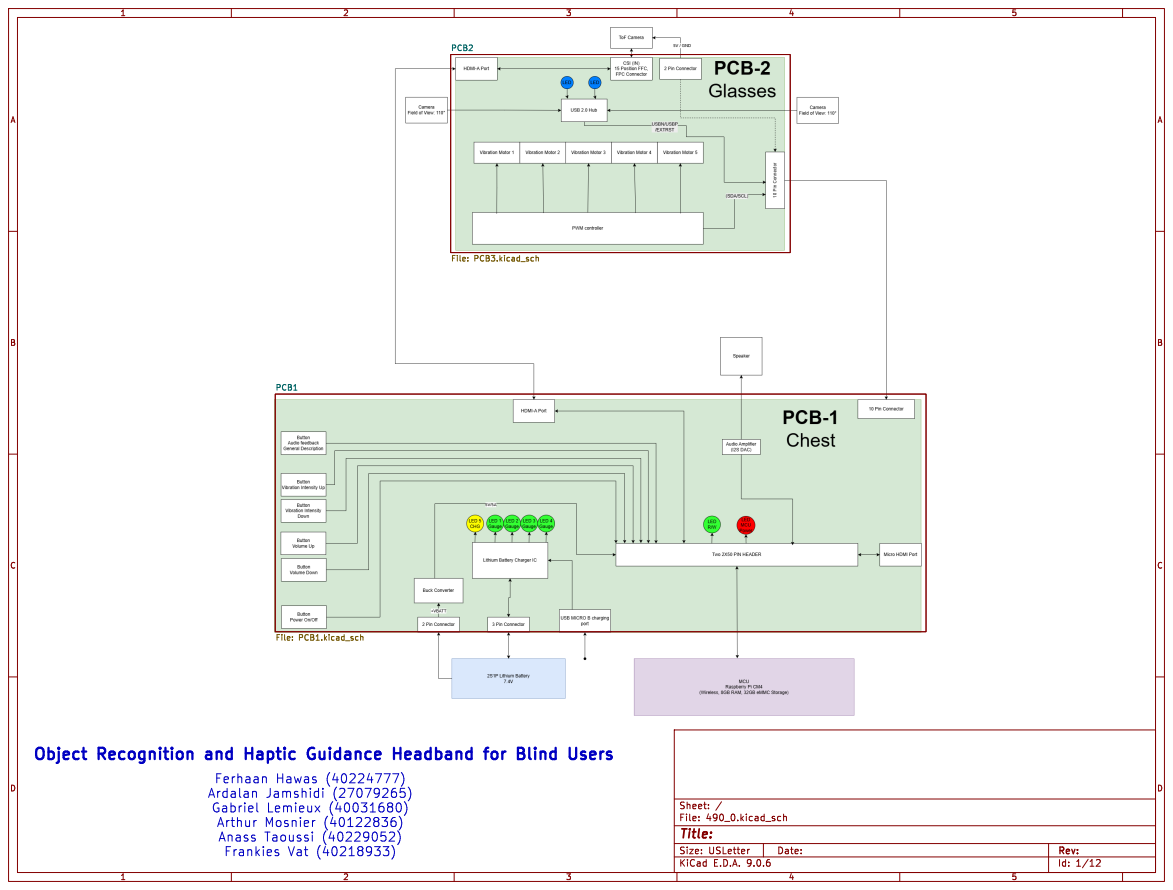
[picture p20: page 1]

Id: 1/12 Title: File: 490_0.kicad_sch Sheet: /


CLK+ CLK- D0+ D0- D1+ D1- SCL SDA

Id: 13/12 Title: File: PCB1.kicad_sch Sheet: /PCB1/

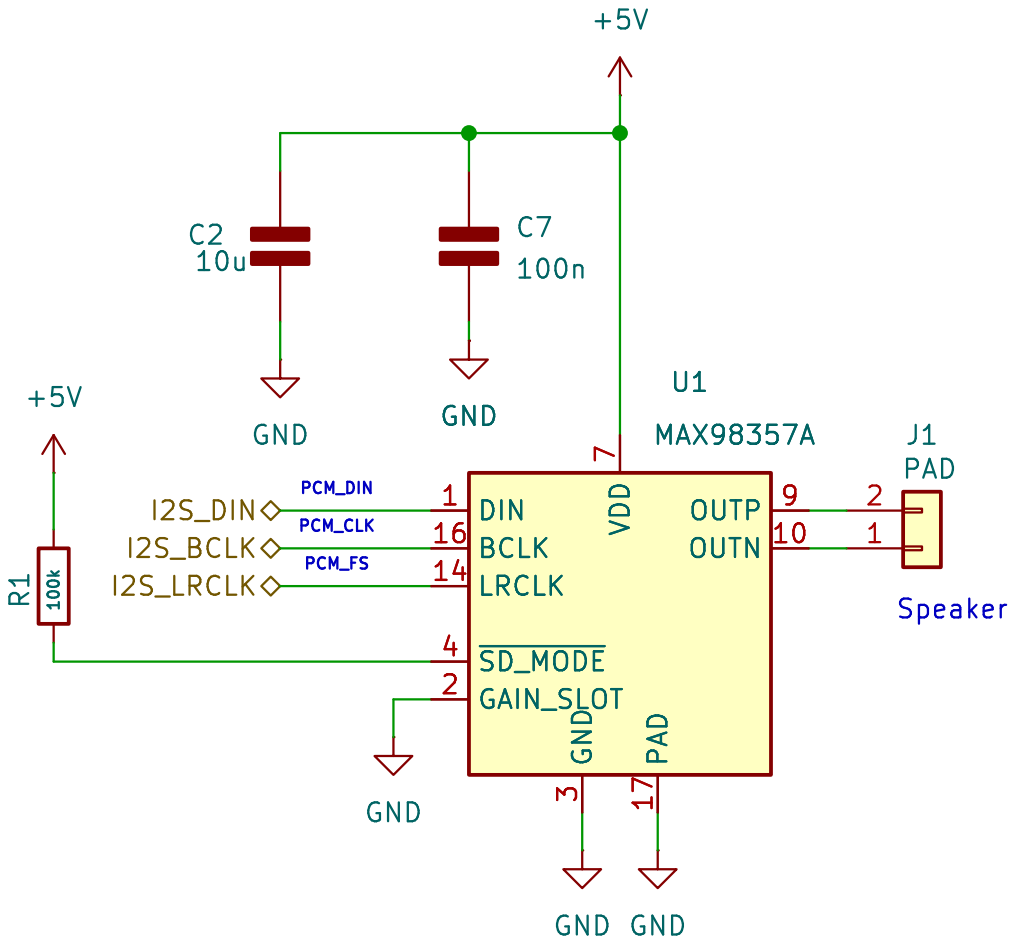
[picture p21: page 3]

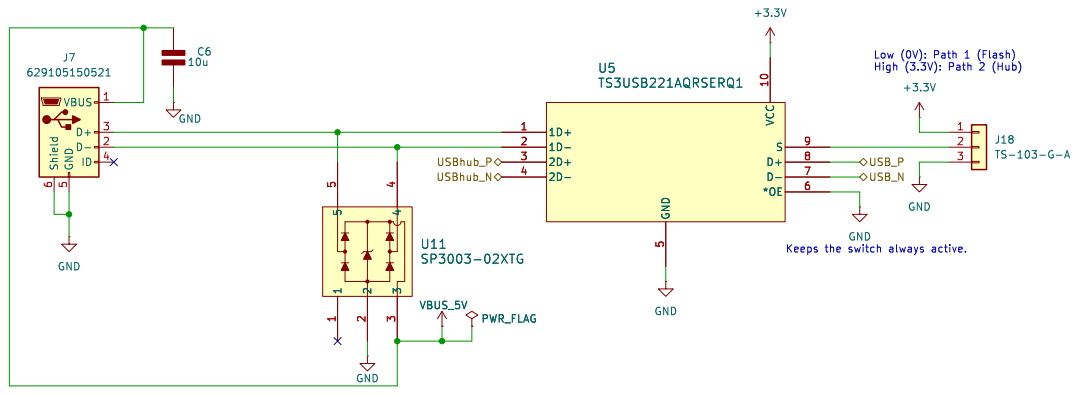
[picture p22: page 4]

Keeps the switch always active. Low (0V): Path 1 (Flash)


SDA CLK+ SCL CLK- D0+ D1- D1+

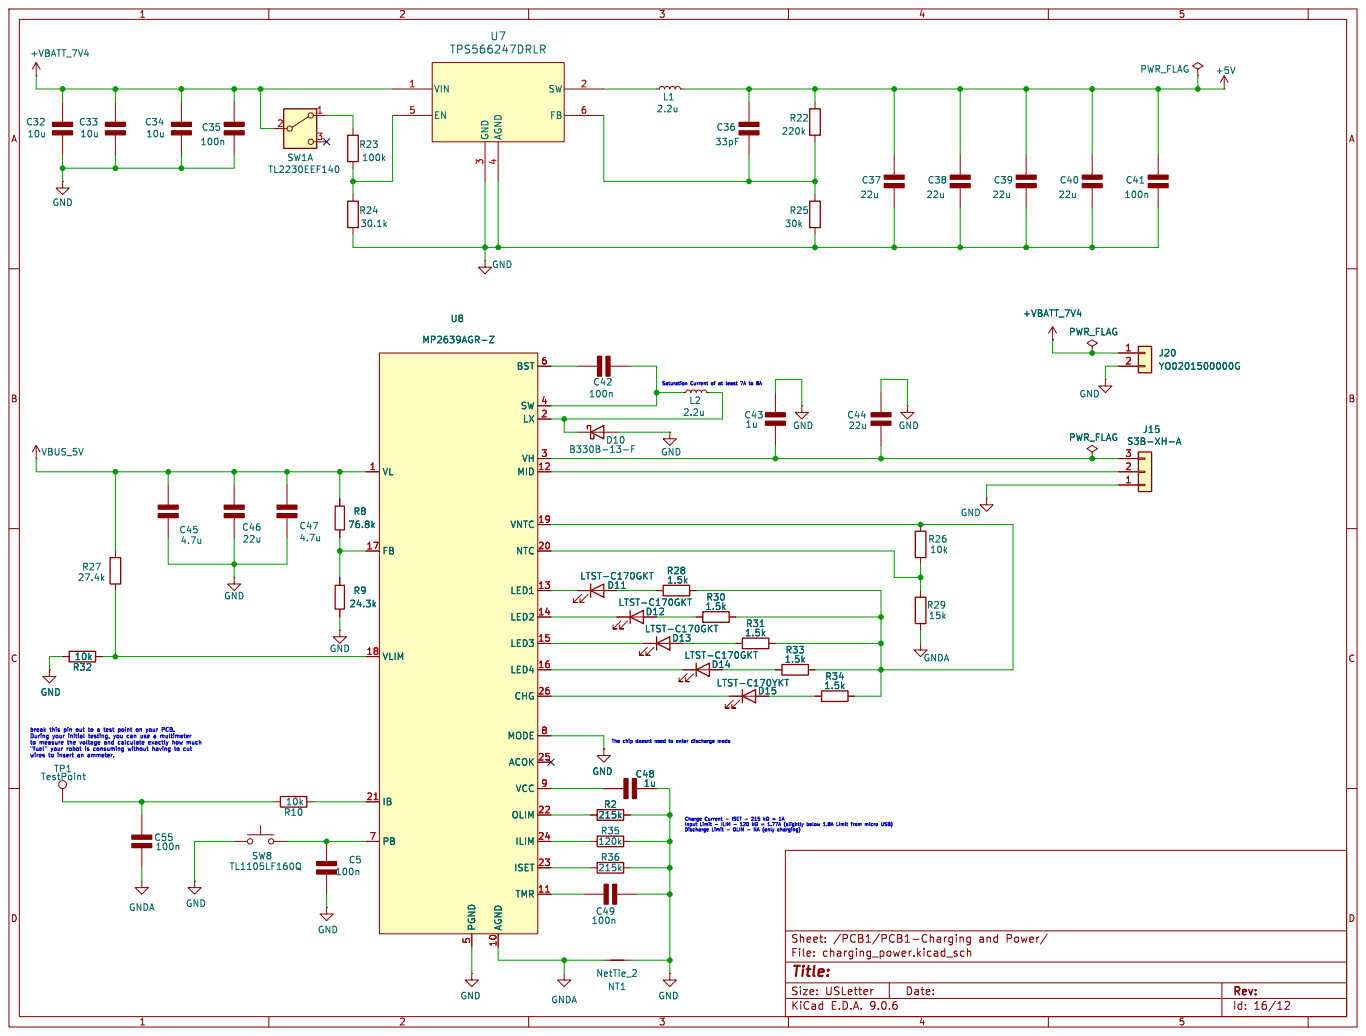
[picture p23: page 6]

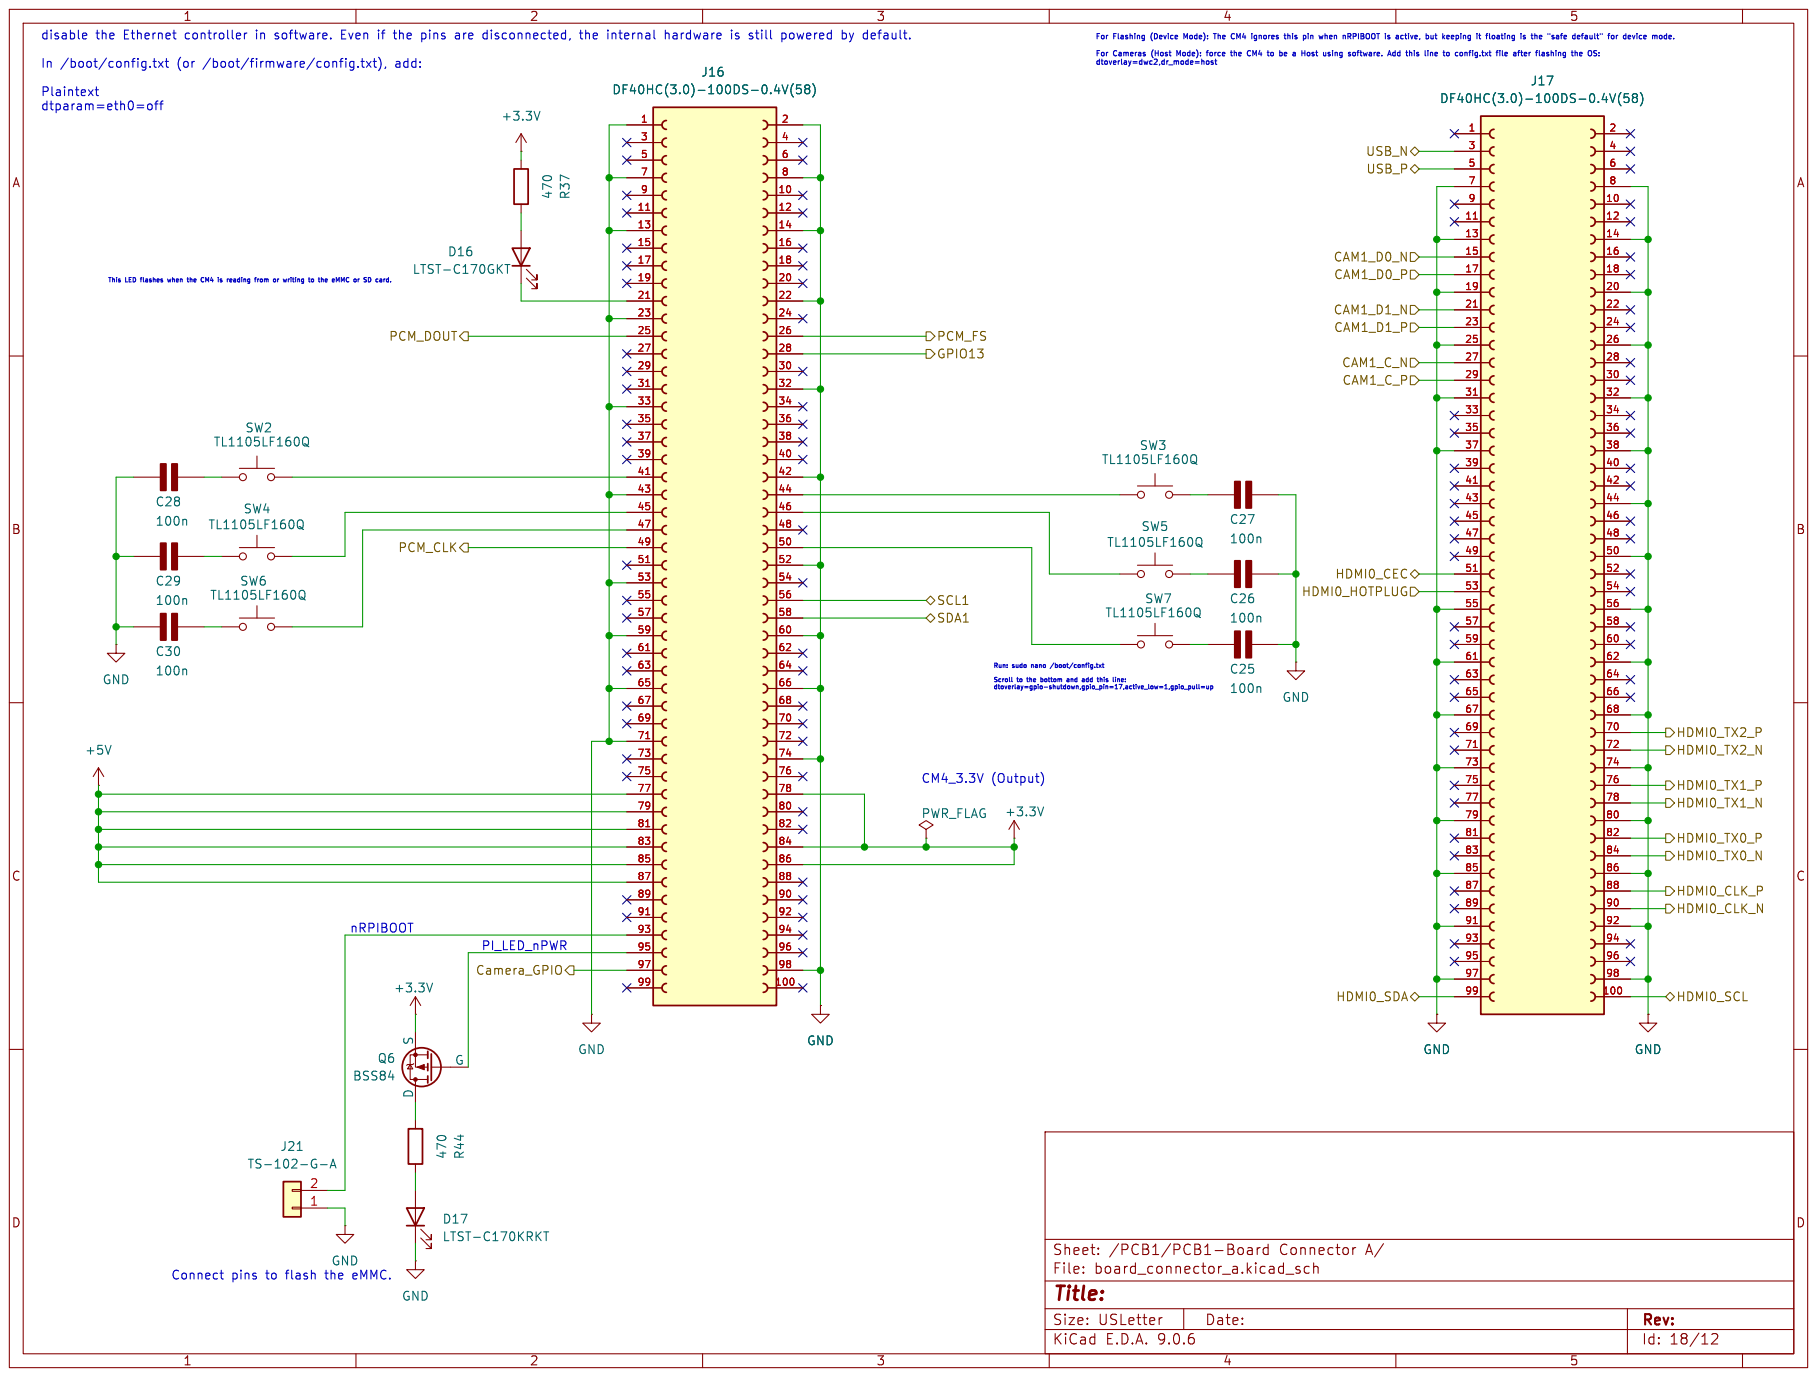
[picture p24: page 7]

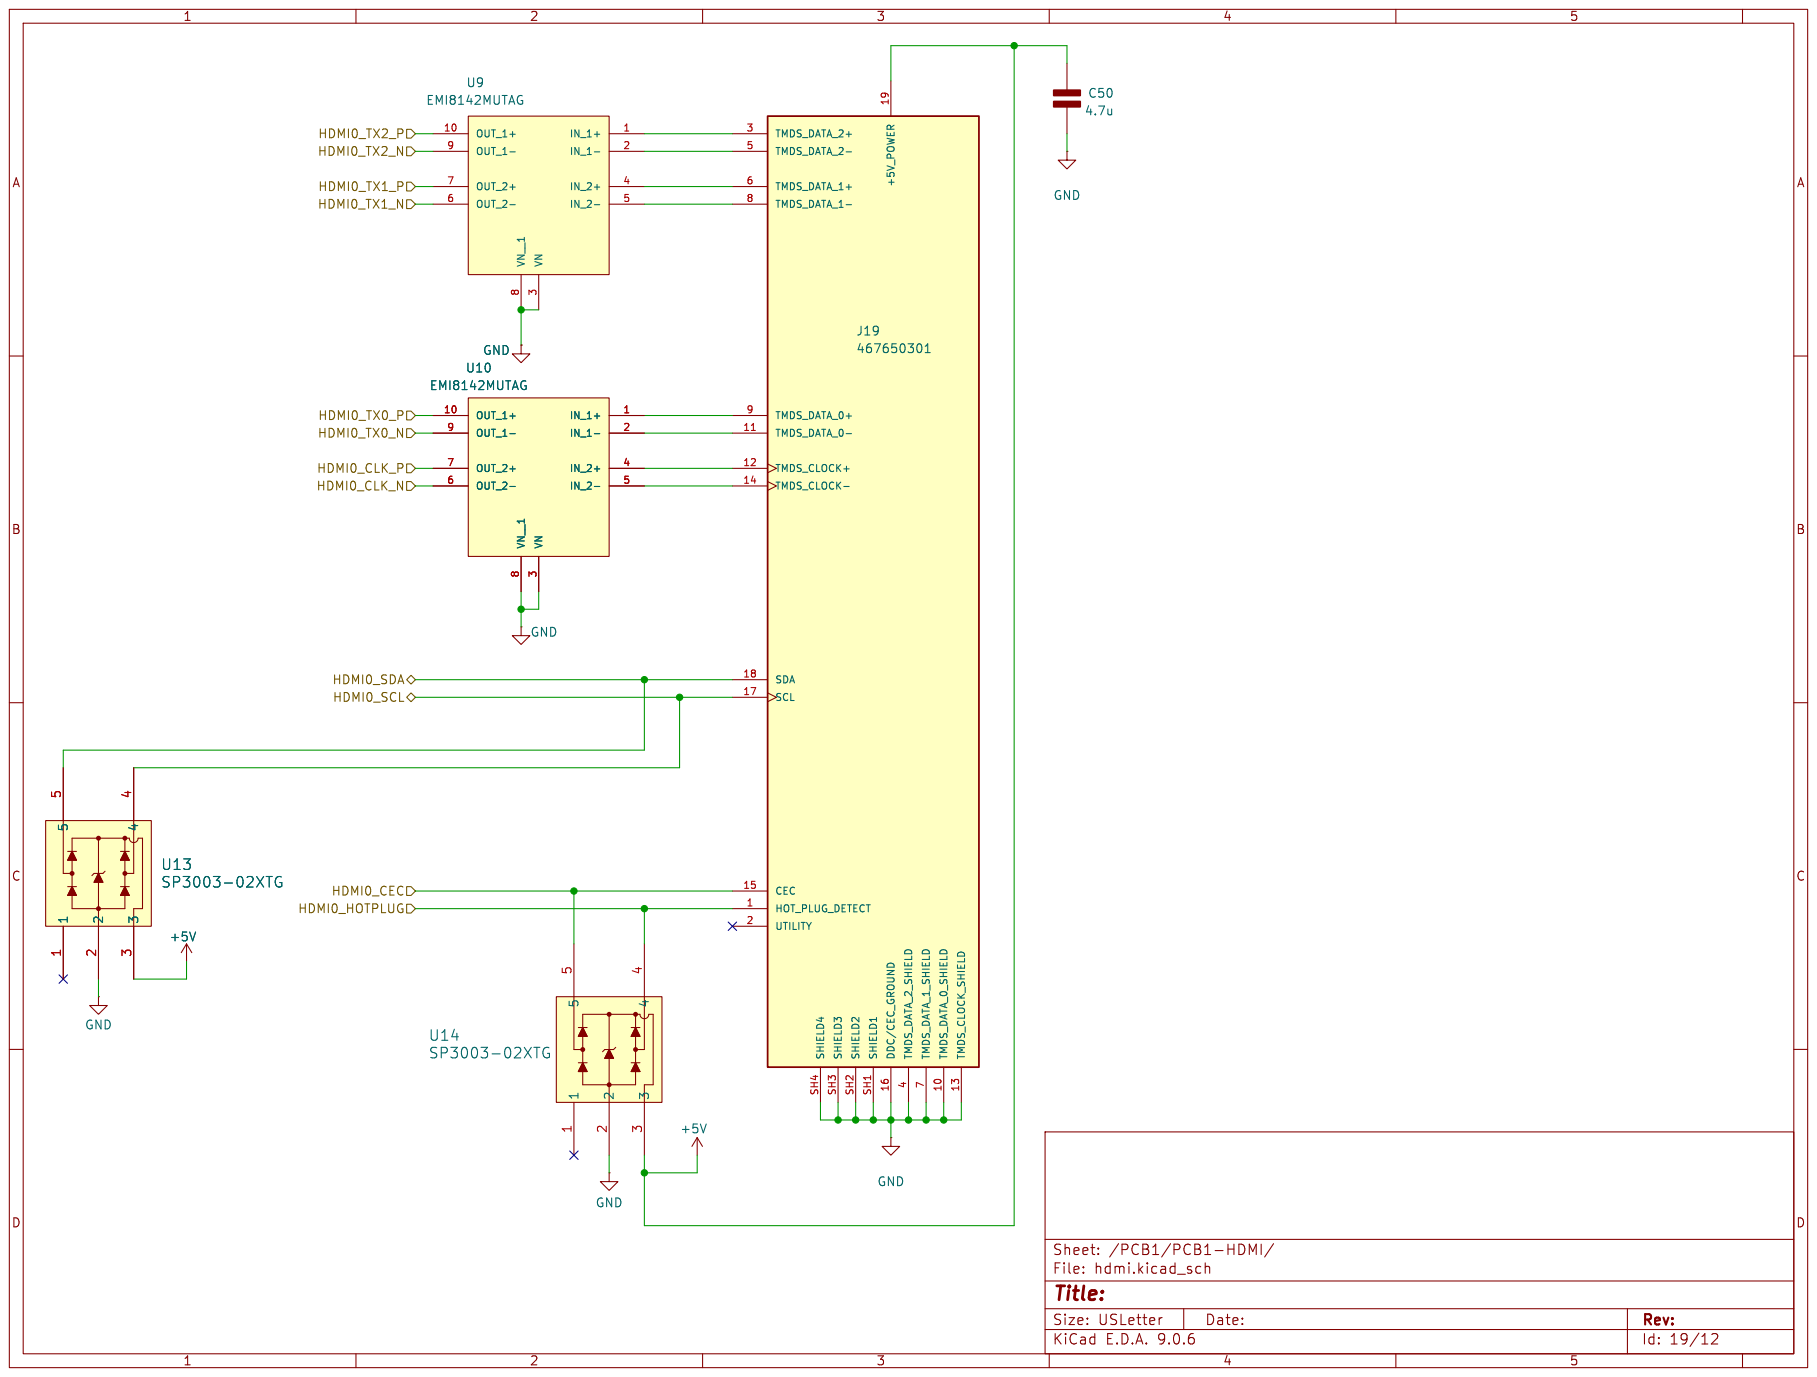
[picture p25: page 8]

Id: 19/12 Title: File: hdmi.kicad_sch Sheet: /PCB1/PCB1-HDMI/

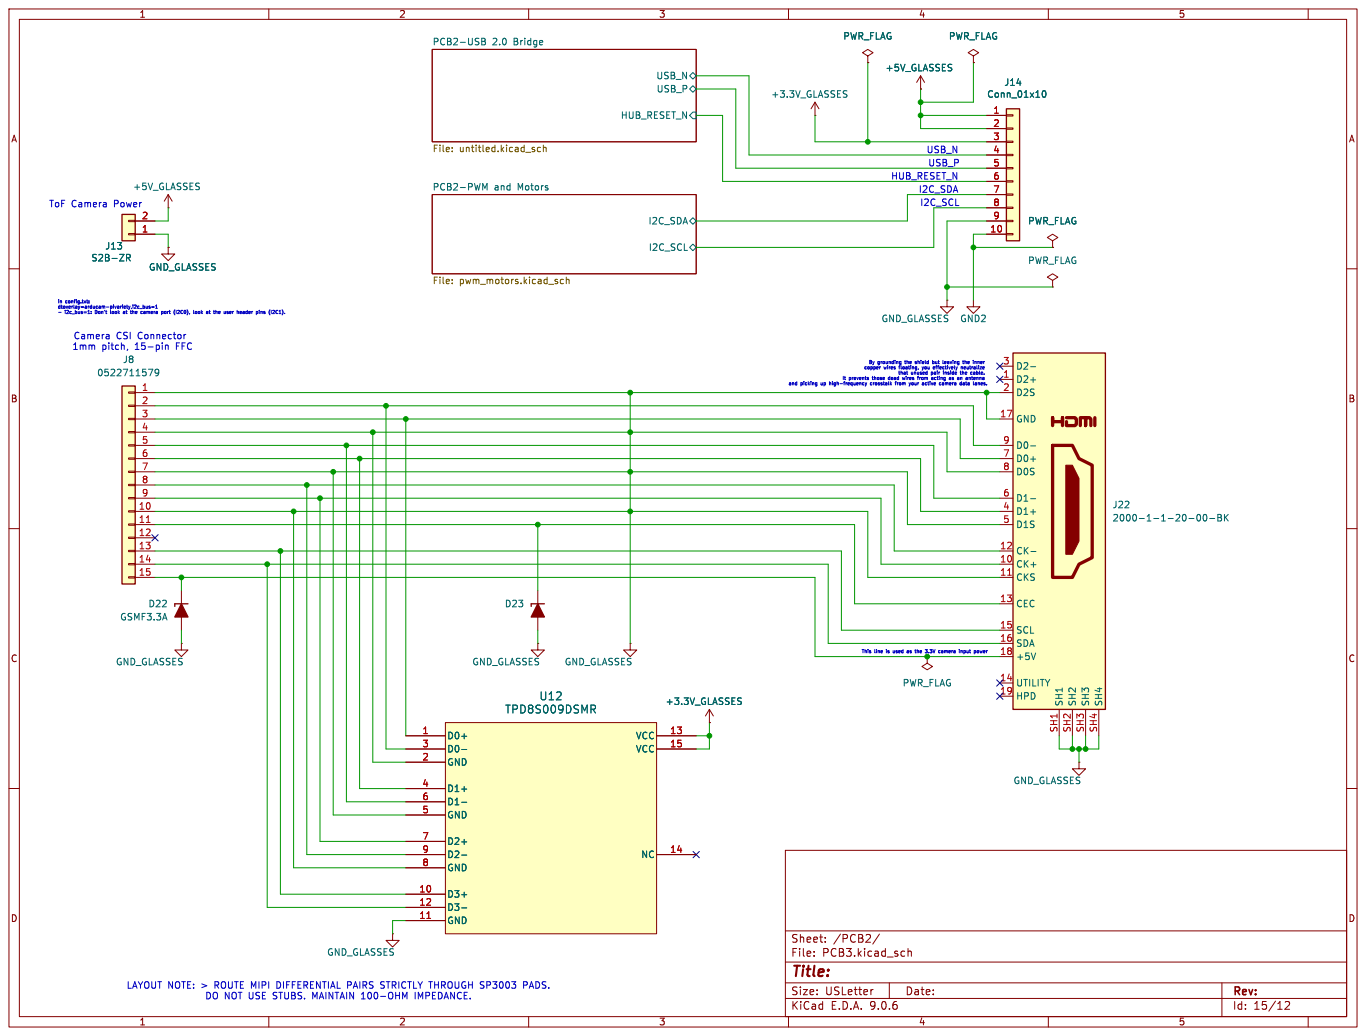
[picture p26: page 9]

ToF Camera Power J13 S2B-ZR

in config.txt: dtoverlay=arducam-pivariety,i2c_bus=1

Id: 15/12 Title: File: PCB3.kicad_sch Sheet: /PCB2/

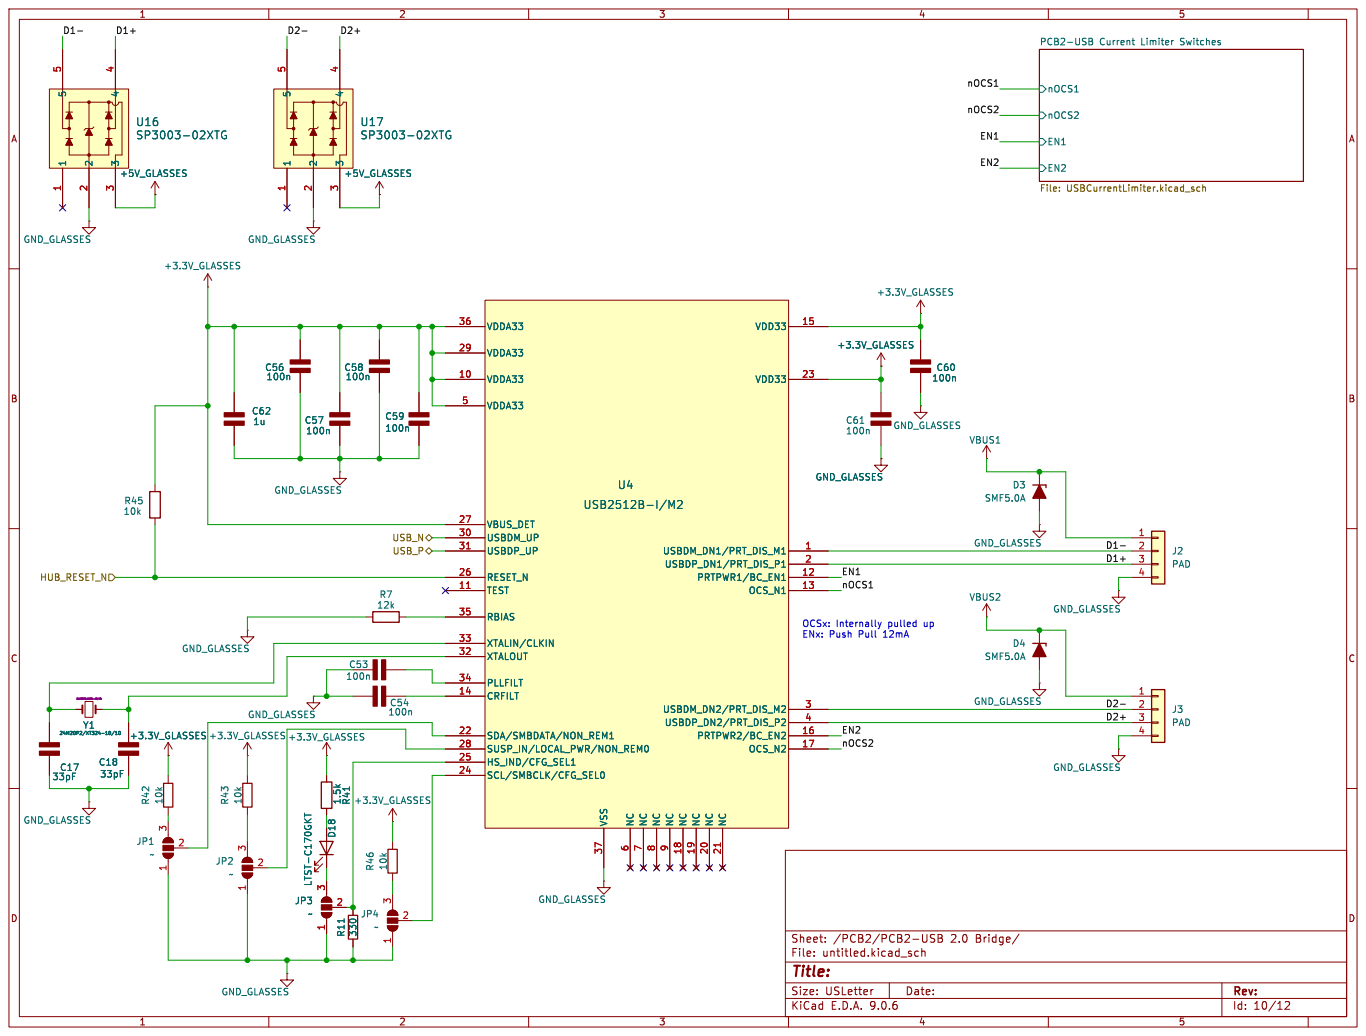
[picture p27: page 10]

9 NC 18 NC 19 NC 20 NC 21 VDD33 15 VDD33 23 USBDM_DN1/PRT_DIS_M1 1 USBDP_DN1/PRT_DIS_P1 2 PRTPWR1/BC_EN1 12 OCS_N1 13 USBDM_DN2/PRT_DIS_M2 3 USBDP_DN2/PRT_DIS_P2 4 PRTPWR2/BC_EN2 16 OCS_N2 17 U4 USB2512B-I/M2 GND_GLASSES GND_GLASSES

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

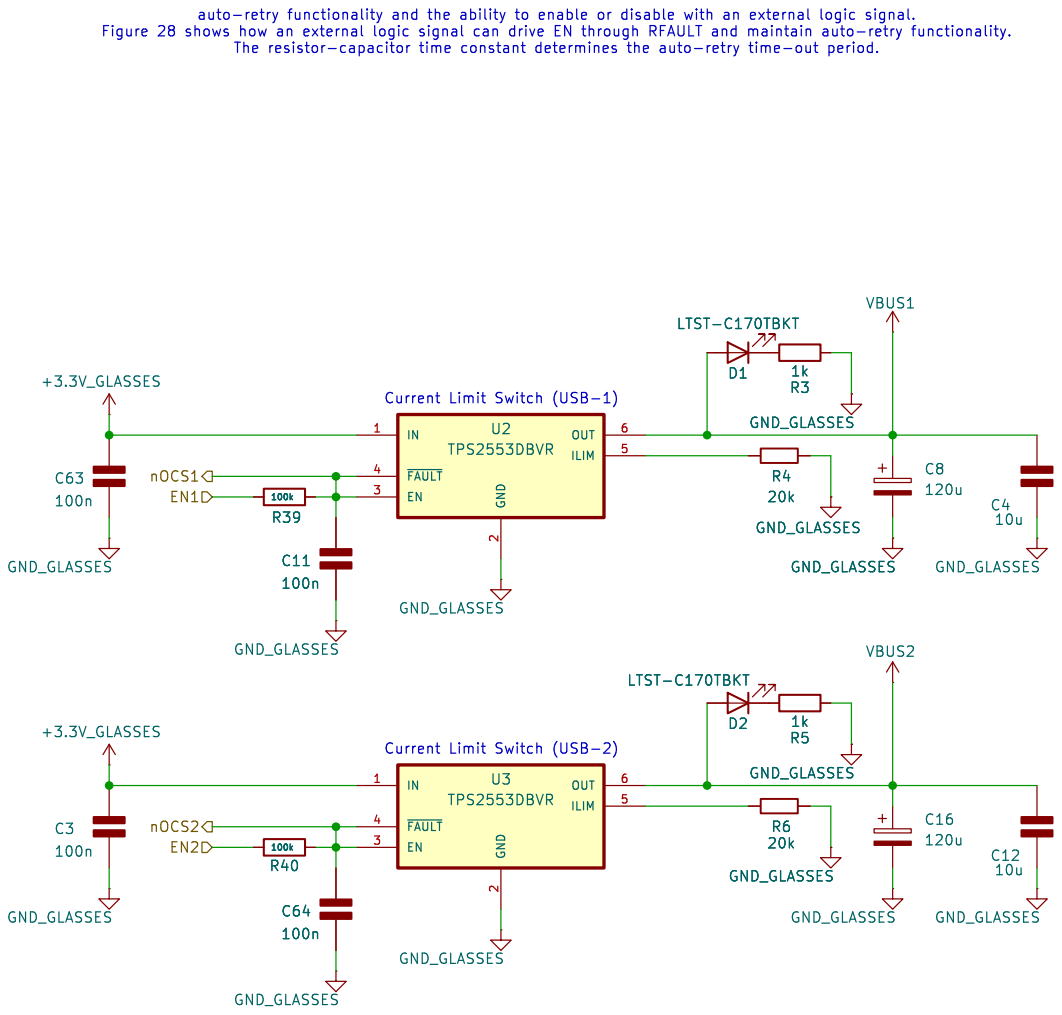
[picture p28: page 11]

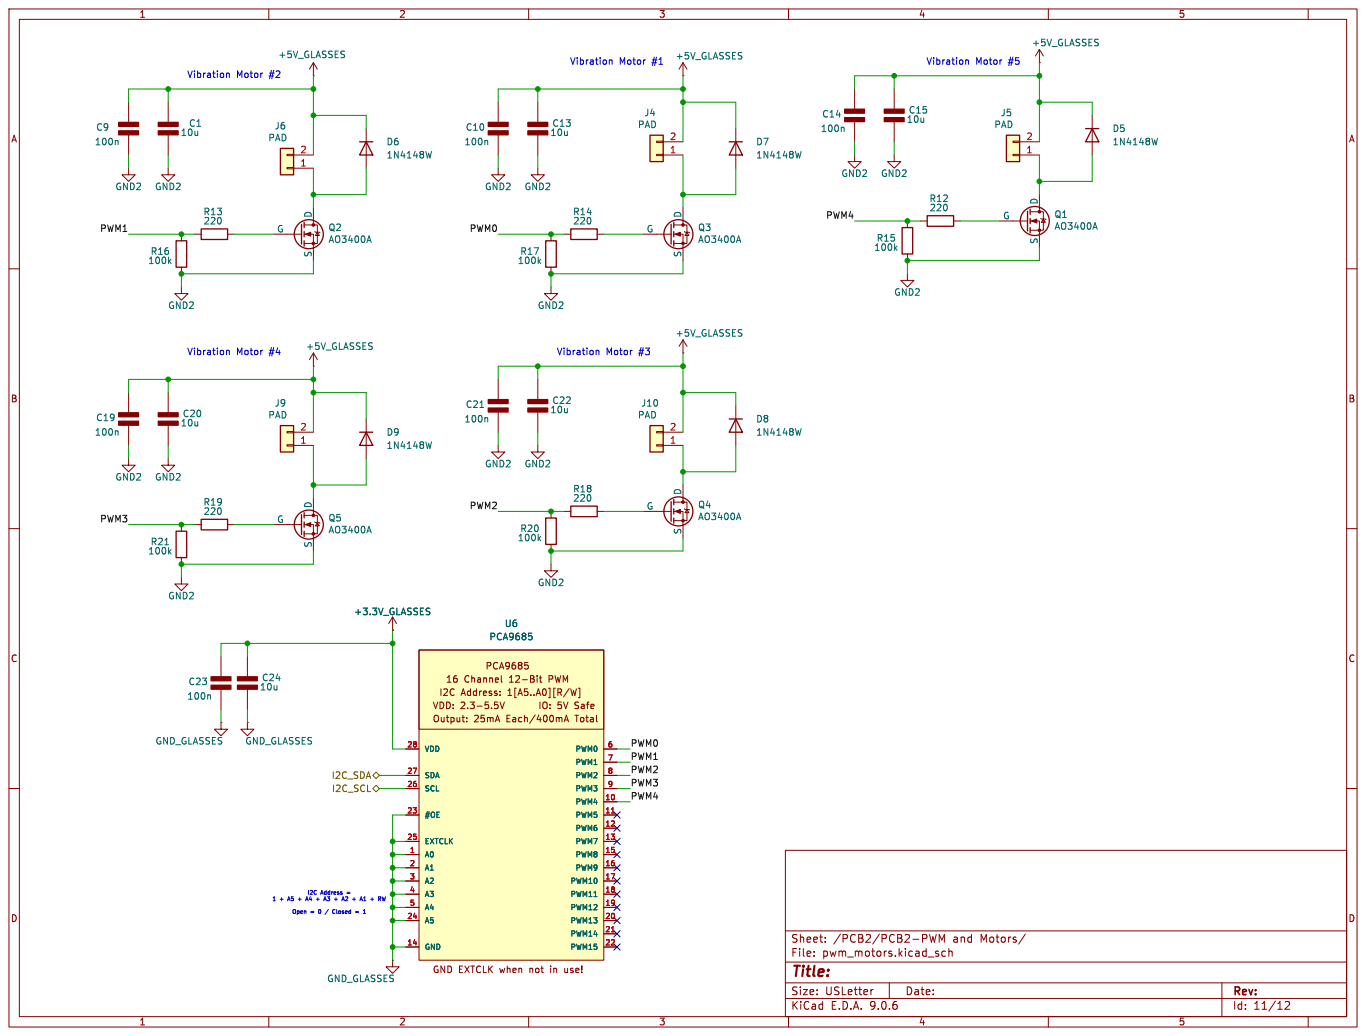
[picture p29: page 12]
