heyitsarthur/COEN490/490_0/490_0.pdf

Id: 1/12 Title: File: 490_0.kicad_sch Sheet: /

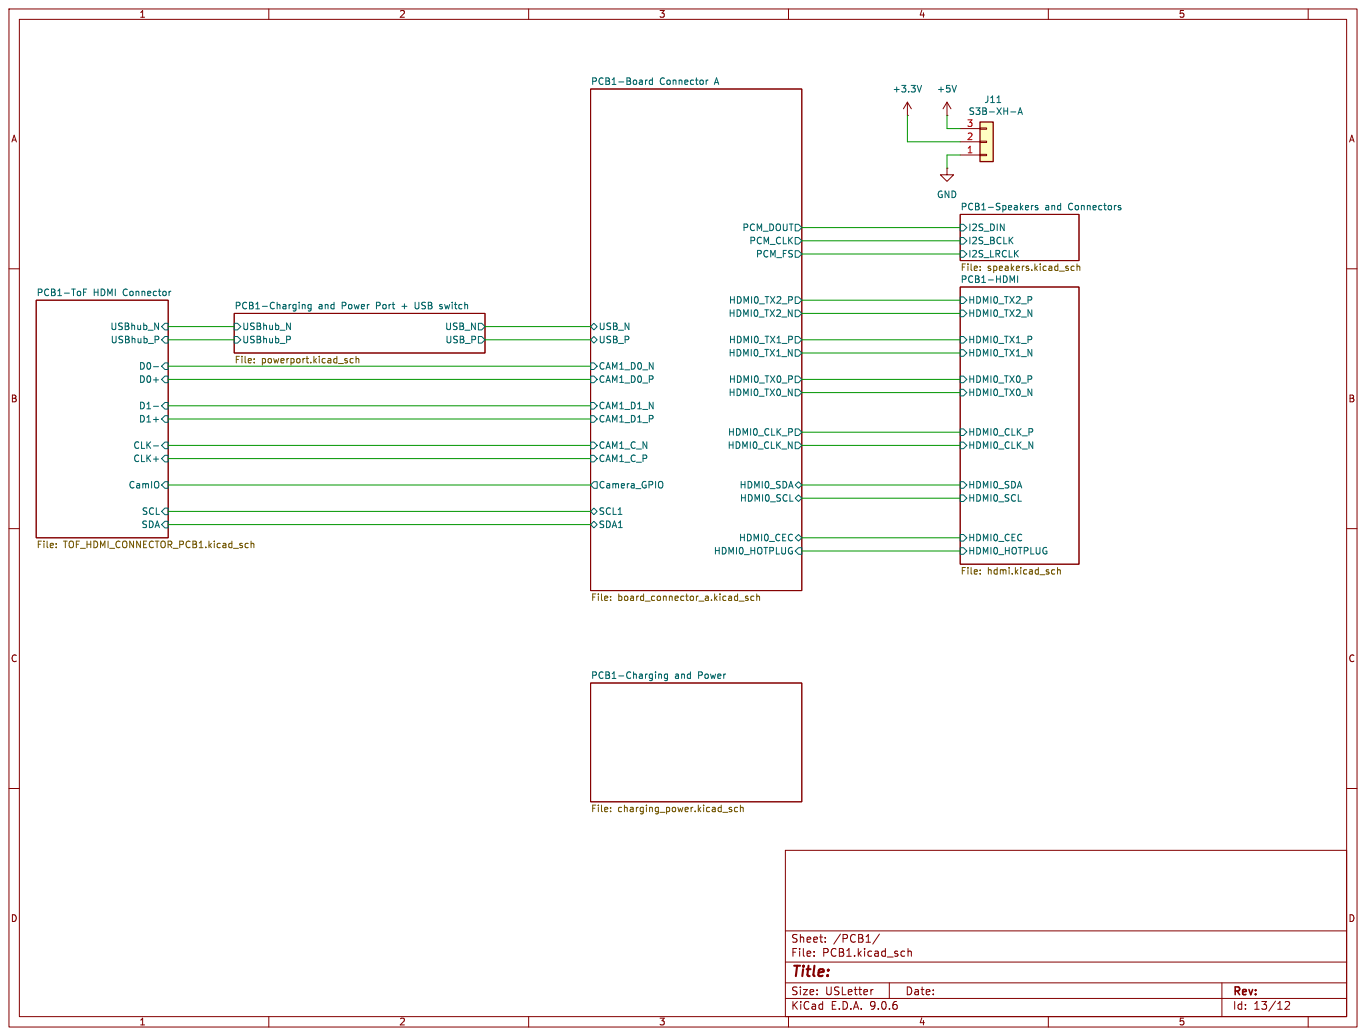
[picture p30: page 2]

CLK+ CLK- D0+ D0- D1+ D1- SCL SDA USBhub_N
USBhub_P

Id: 13/12 Title: File: PCB1.kicad_sch Sheet: /PCB1/


7 PAD 17 OUTP 9 OUTN 10 U1 MAX98357A GND


Keeps the switch always active. VBUS_5V U11 SP3003-02XTG

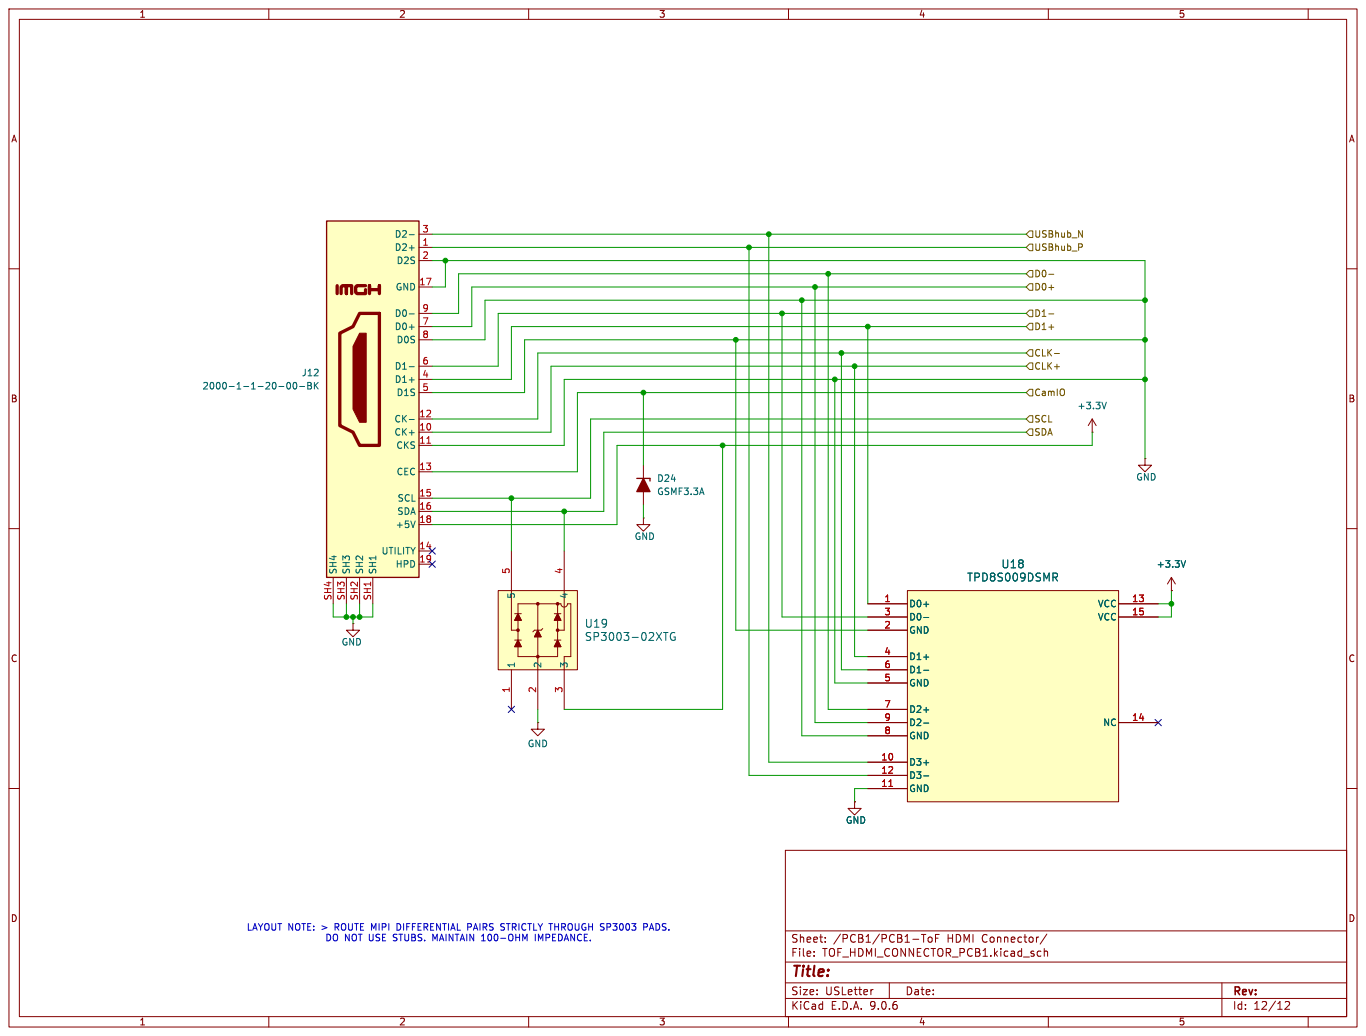
[picture p31: page 5]

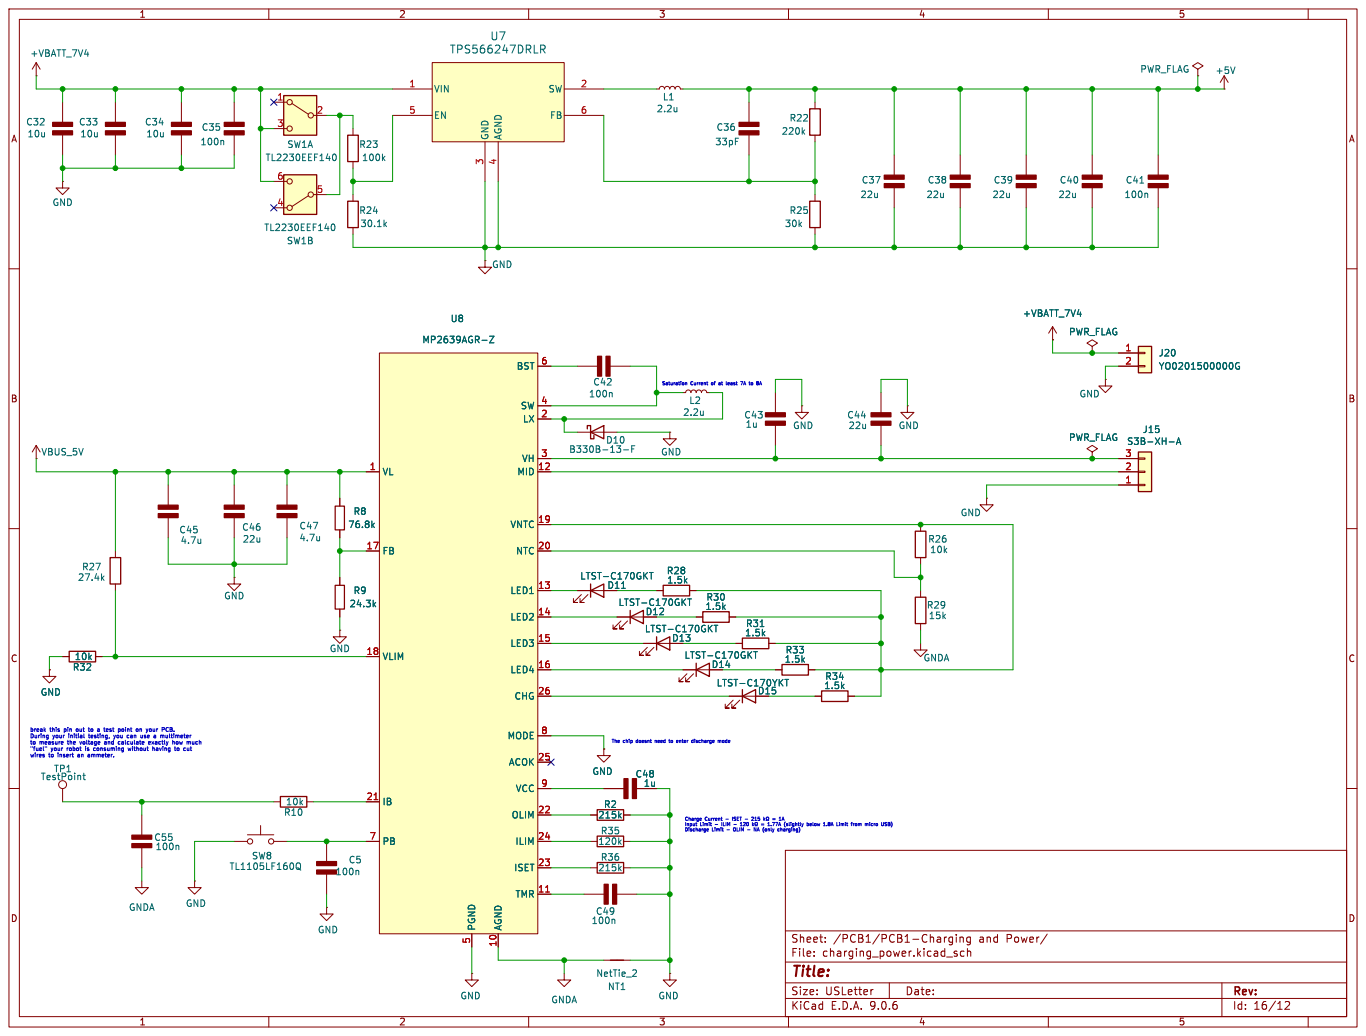
[picture p32: page 6]

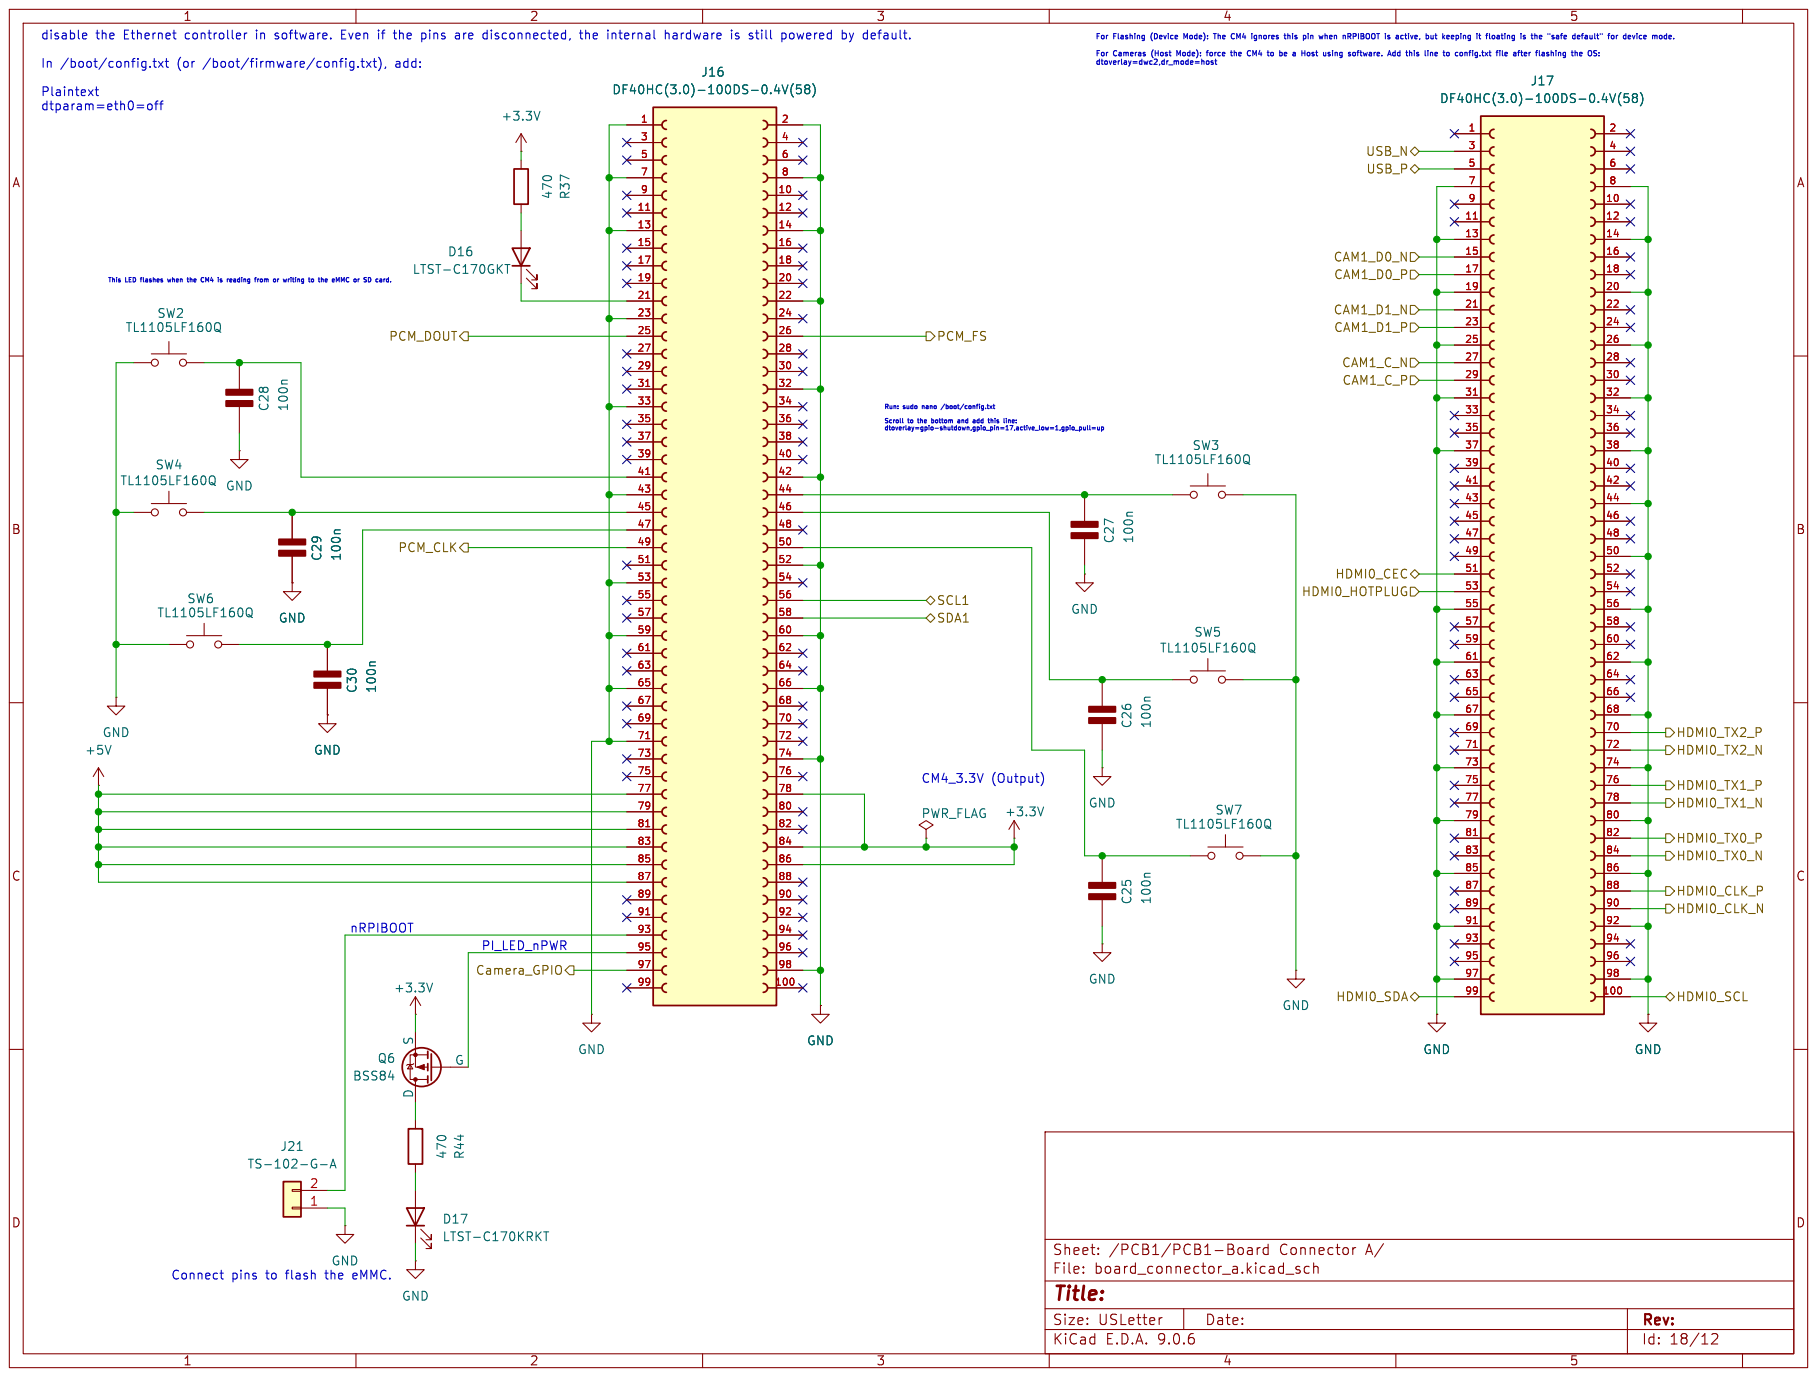
[picture p33: page 7]

Connect pins to flash the eMMC.

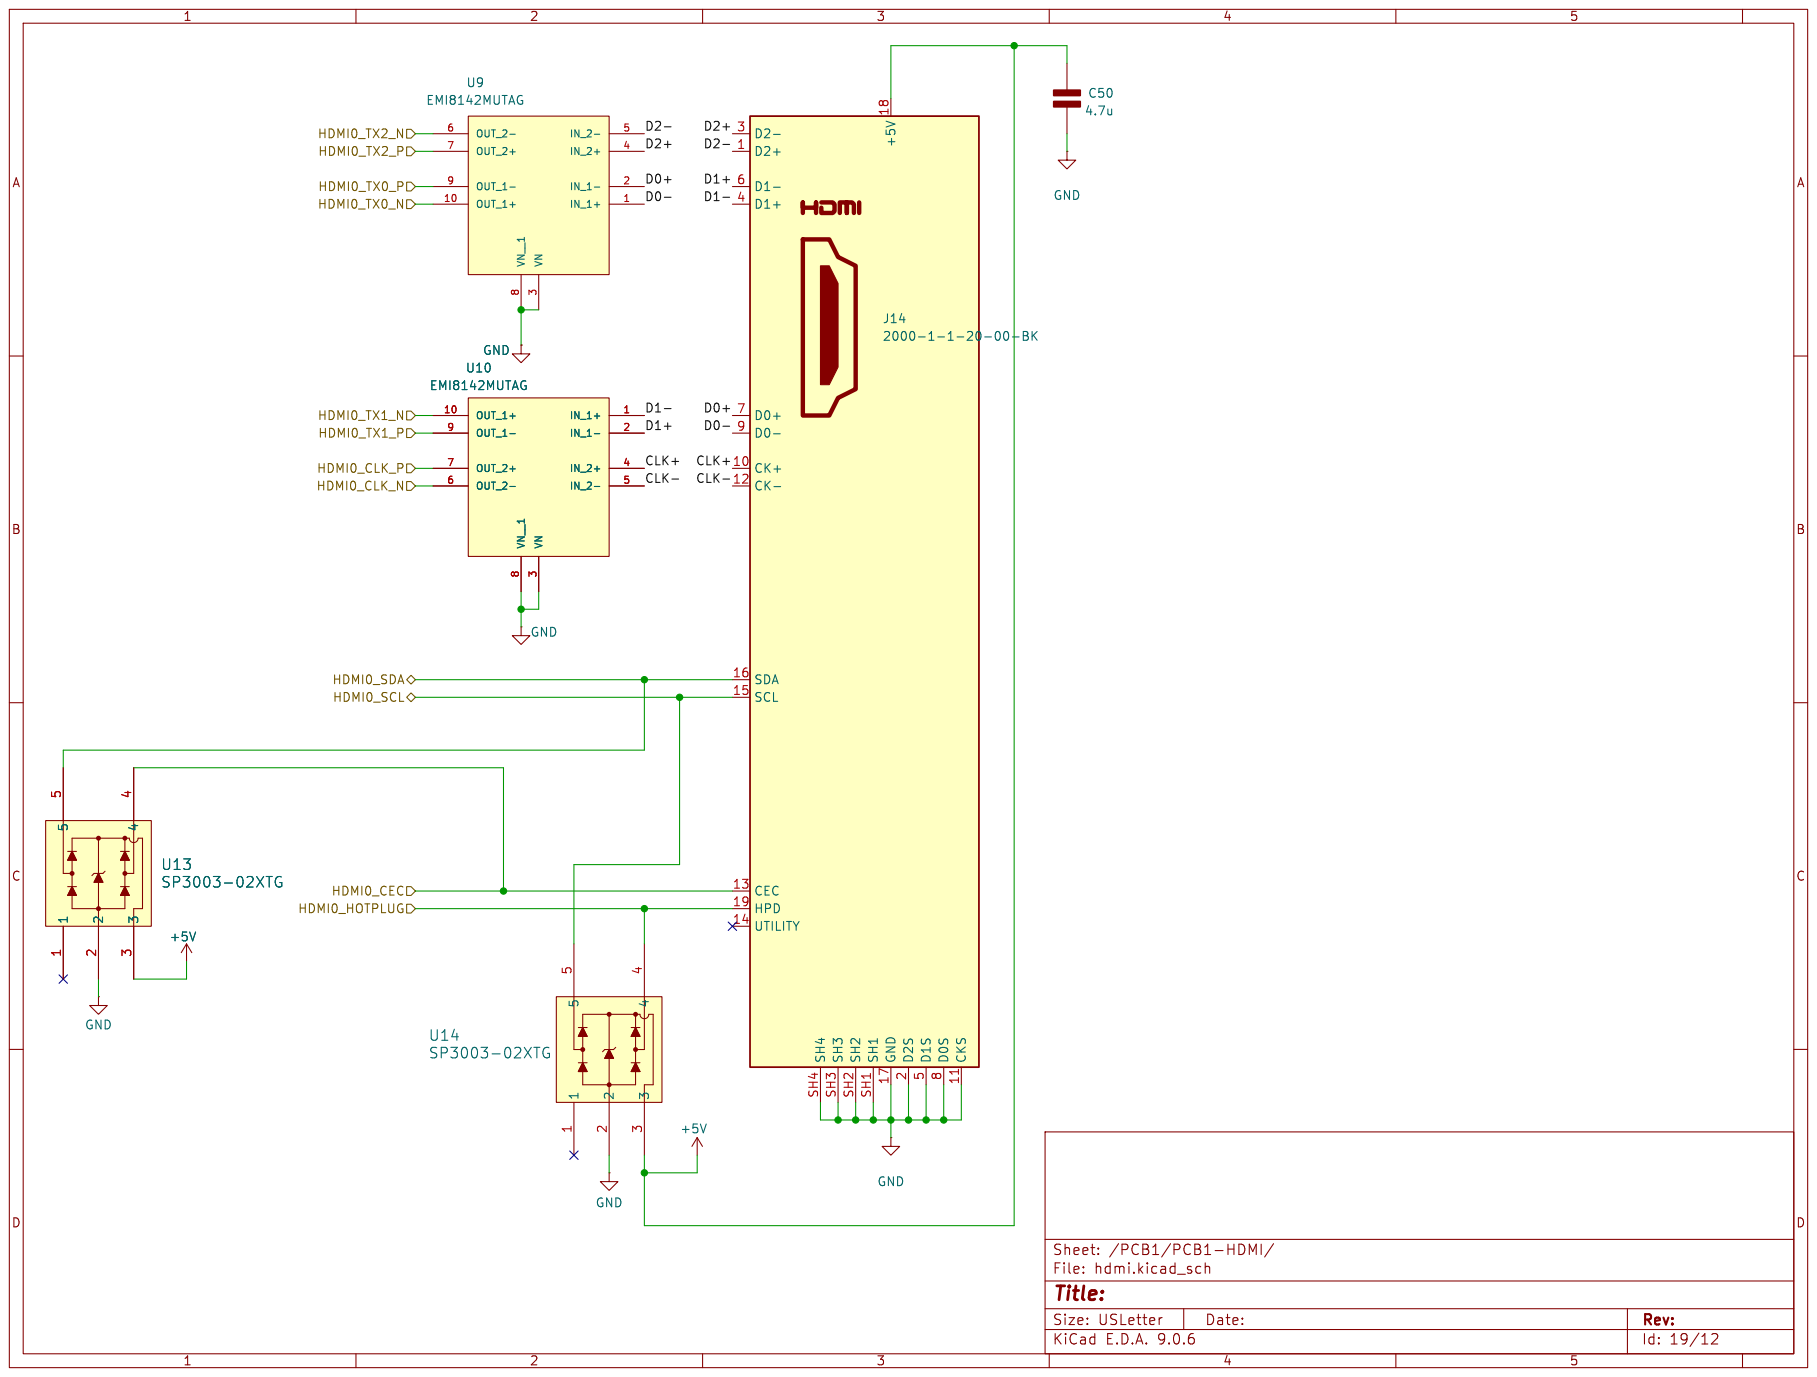
[picture p34: page 8]

Id: 19/12 Title: File: hdmi.kicad_sch Sheet: /PCB1/PCB1-HDMI/ GND

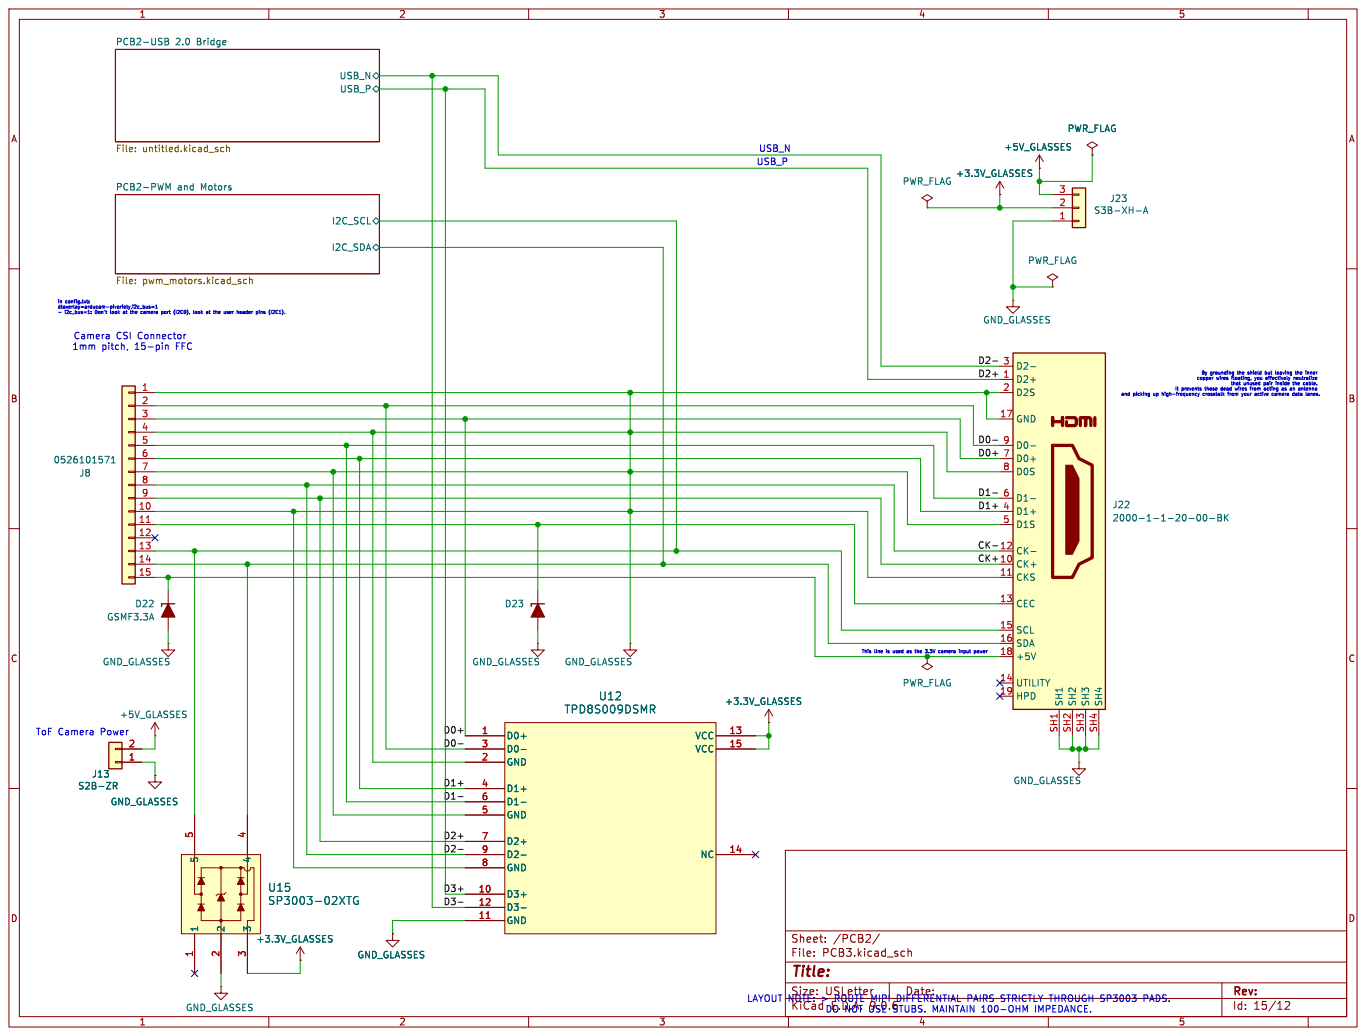
[picture p35: page 9]

in config.txt: dtoverlay=arducam-pivariety,i2c_bus=1

Id: 15/12 Title: File: PCB3.kicad_sch Sheet: /PCB2/

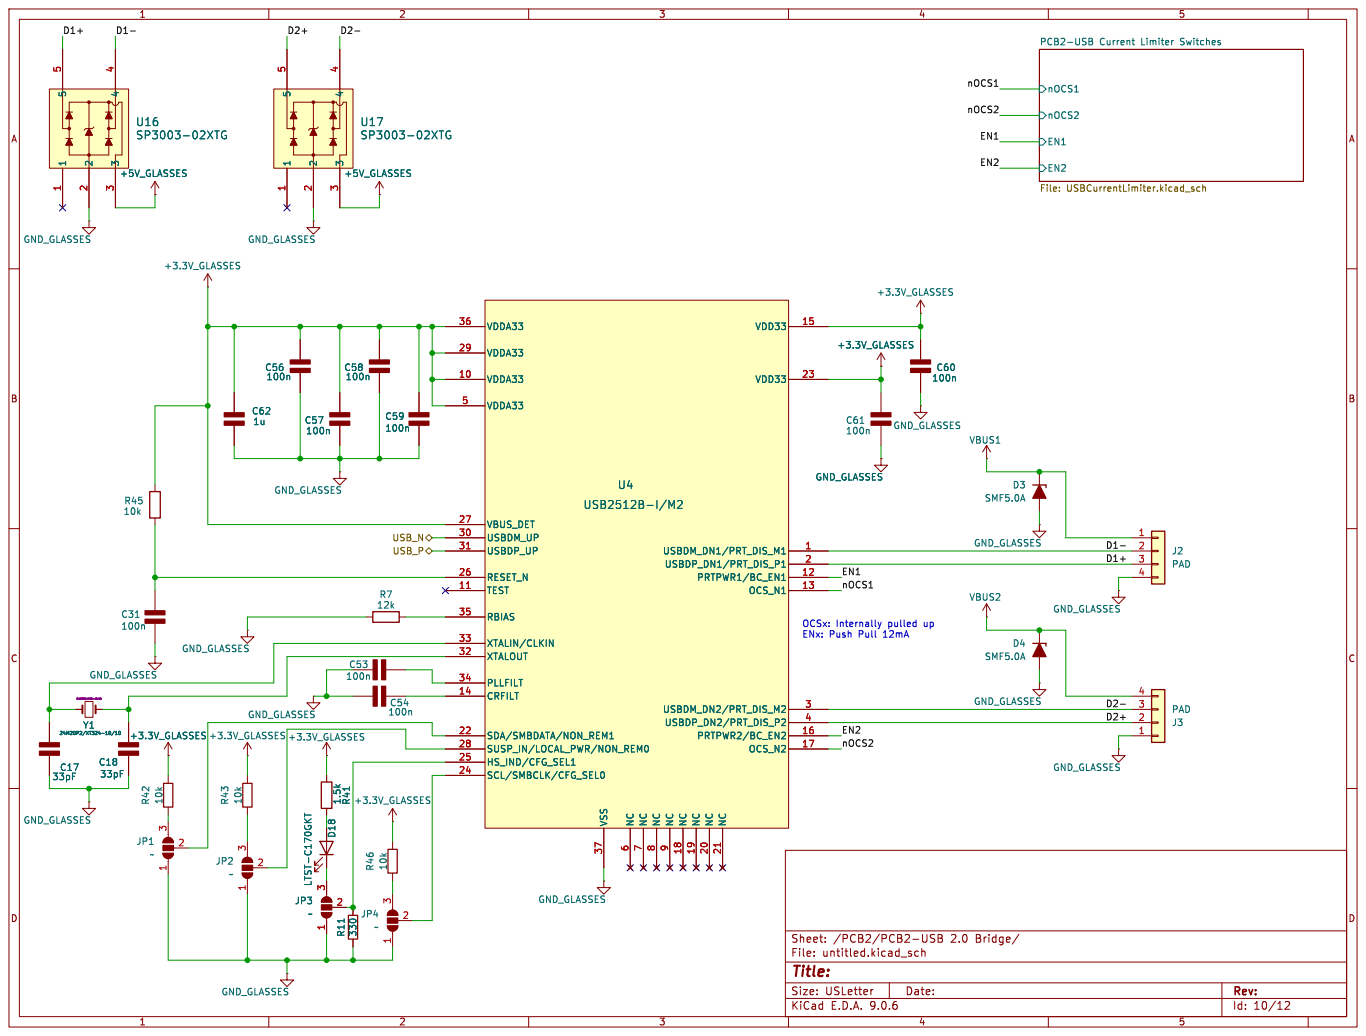
[picture p36: page 10]

9 NC 18 NC 19 NC 20 NC 21 VDD33 15 VDD33 23 USBDM_DN1/PRT_DIS_M1 1 USBDP_DN1/PRT_DIS_P1 2 PRTPWR1/BC_EN1 12 OCS_N1 13 USBDM_DN2/PRT_DIS_M2 3 USBDP_DN2/PRT_DIS_P2 4 PRTPWR2/BC_EN2 16 OCS_N2 17 C59

9 NC 18 NC 19 NC 20 NC 21 VDD33 15 VDD33 23 USBDM_DN1/PRT_DIS_M1 1 USBDP_DN1/PRT_DIS_P1 2 PRTPWR1/BC_EN1 12 OCS_N1 13 USBDM_DN2/PRT_DIS_M2 3 USBDP_DN2/PRT_DIS_P2 4 PRTPWR2/BC_EN2 16 OCS_N2 17 U4 USB2512B-I/M2 GND_GLASSES

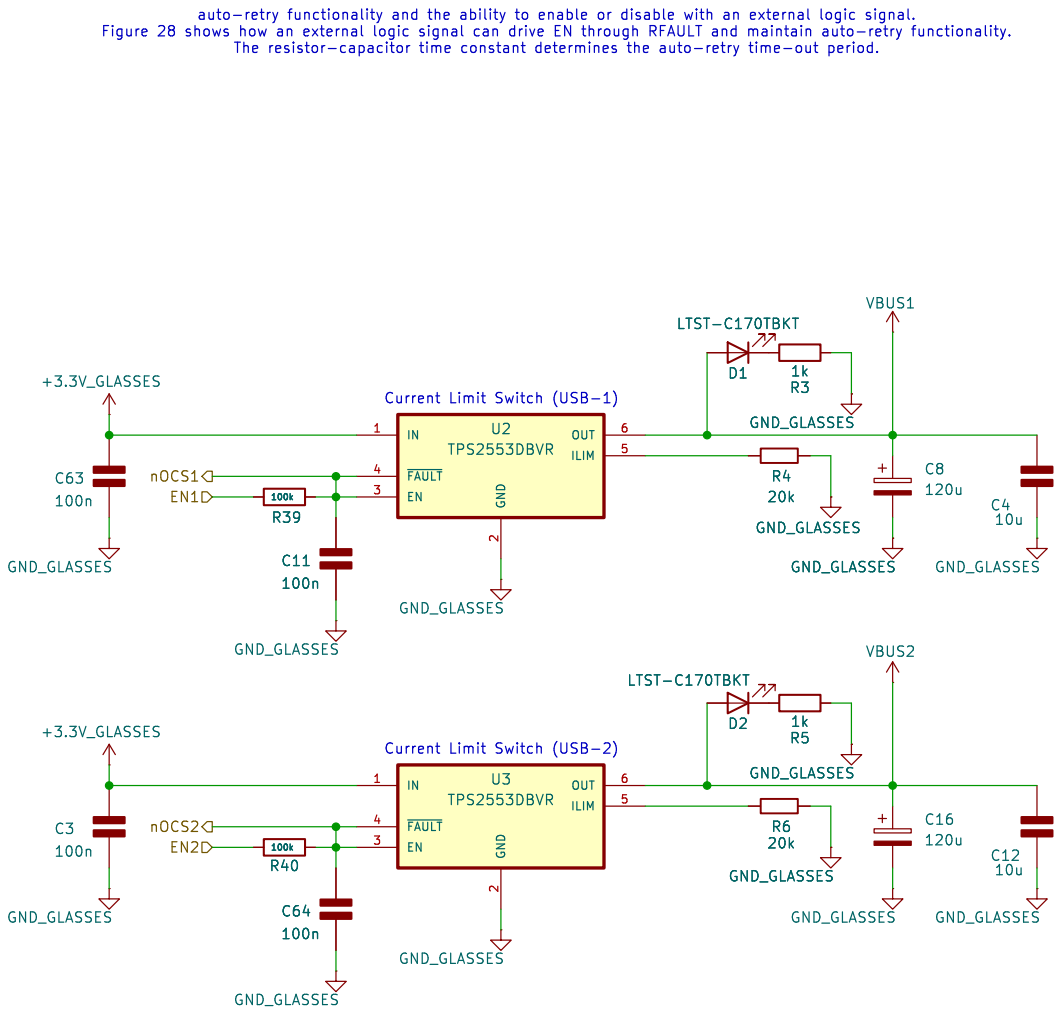
[picture p37: page 11]

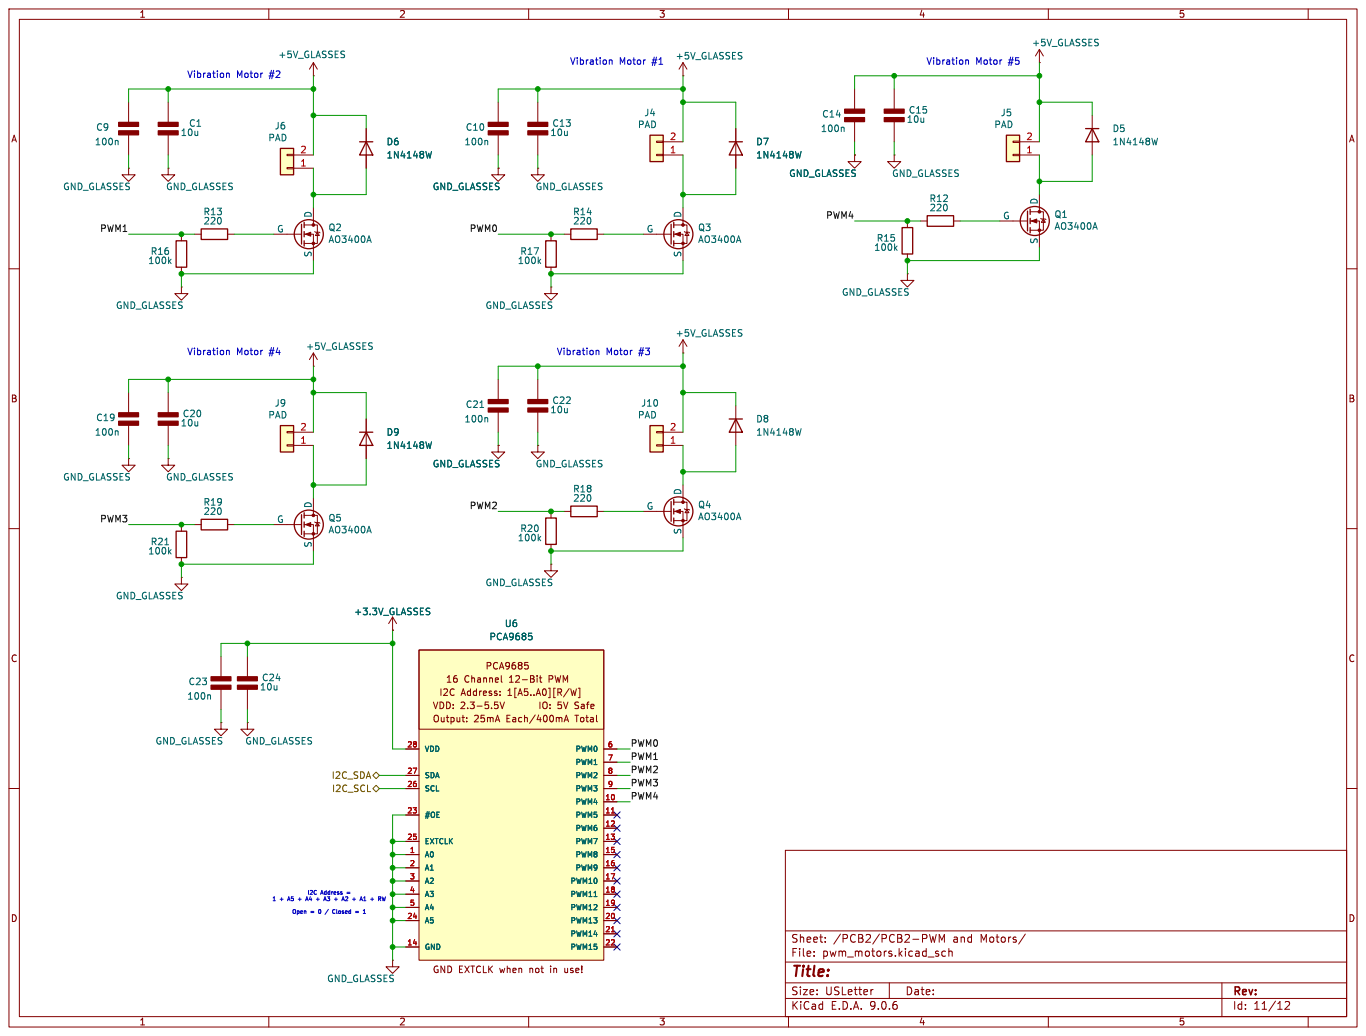
[picture p38: page 12]
