heyitsarthur/COEN490/490_0/490-24_Schematic V2.pdf

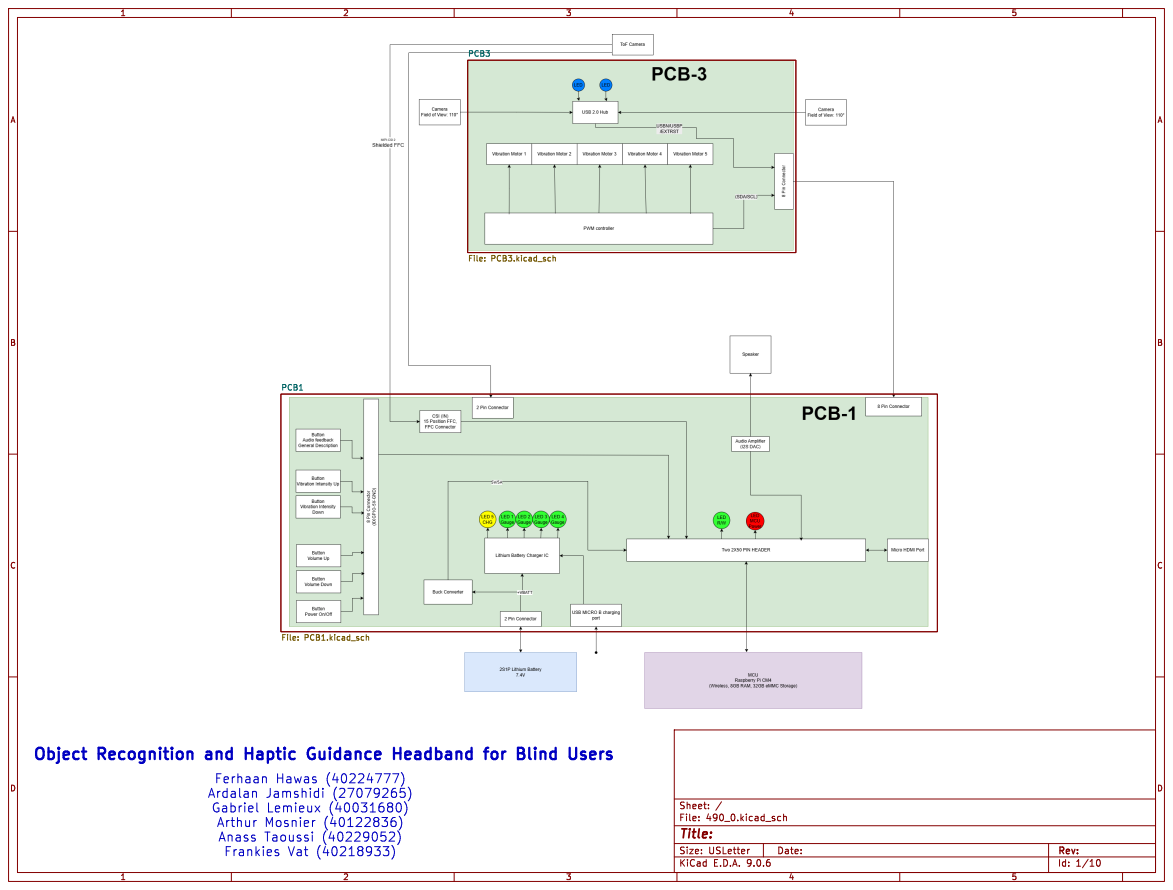
[picture p65: page 1]

Id: 1/10 Title: File: 490_0.kicad_sch Sheet: /

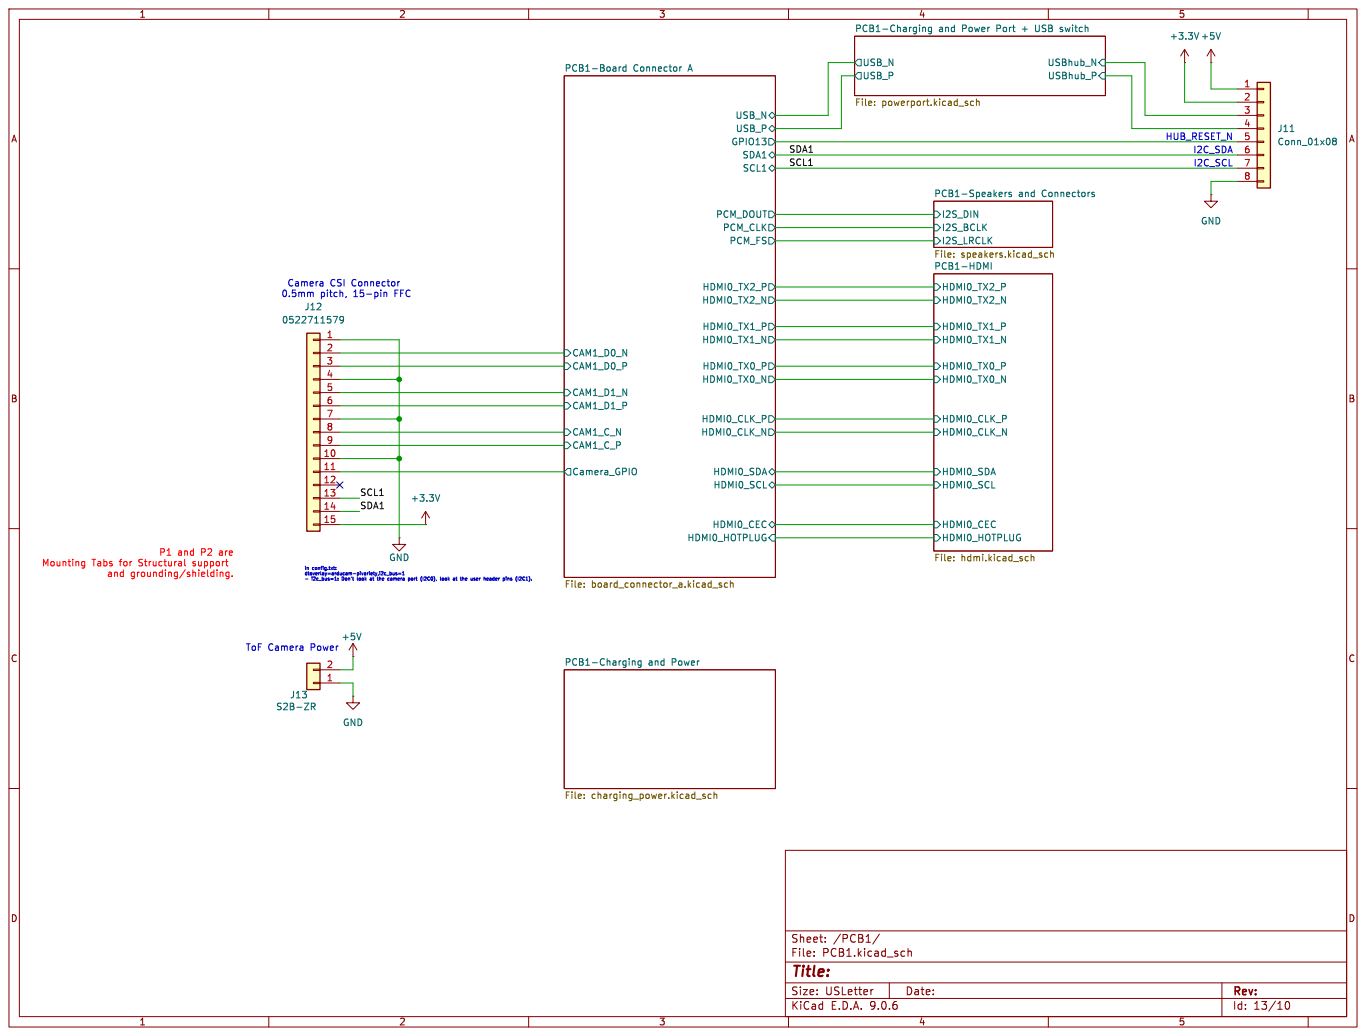
[picture p66: page 2]

in config.txt: dtoverlay=arducam-pivariety,i2c_bus=1

Id: 13/10 Title: File: PCB1.kicad_sch Sheet: /PCB1/

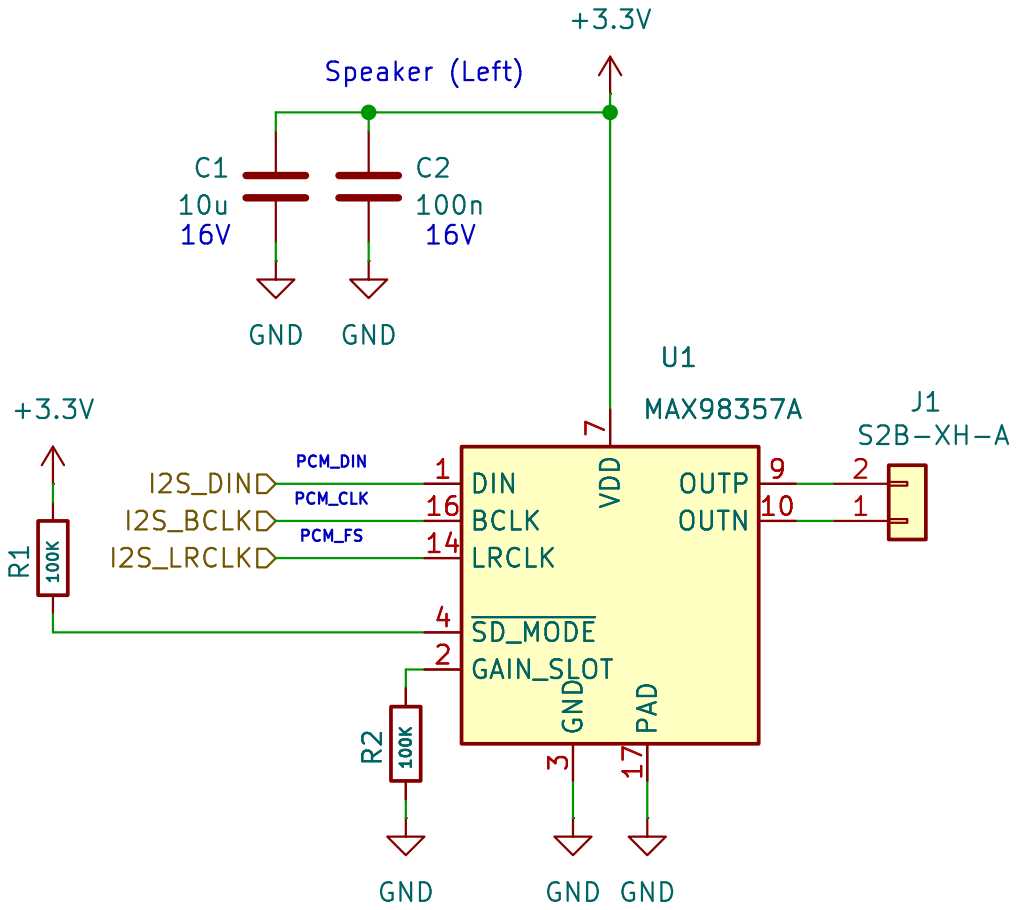
[picture p67: page 3]

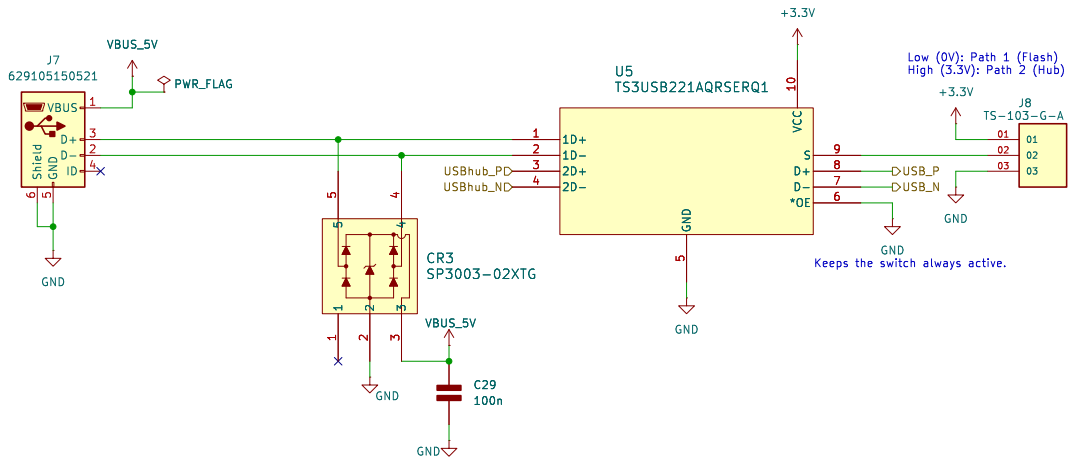
[picture p68: page 4]

Keeps the switch always active. Low (0V): Path 1 (Flash)

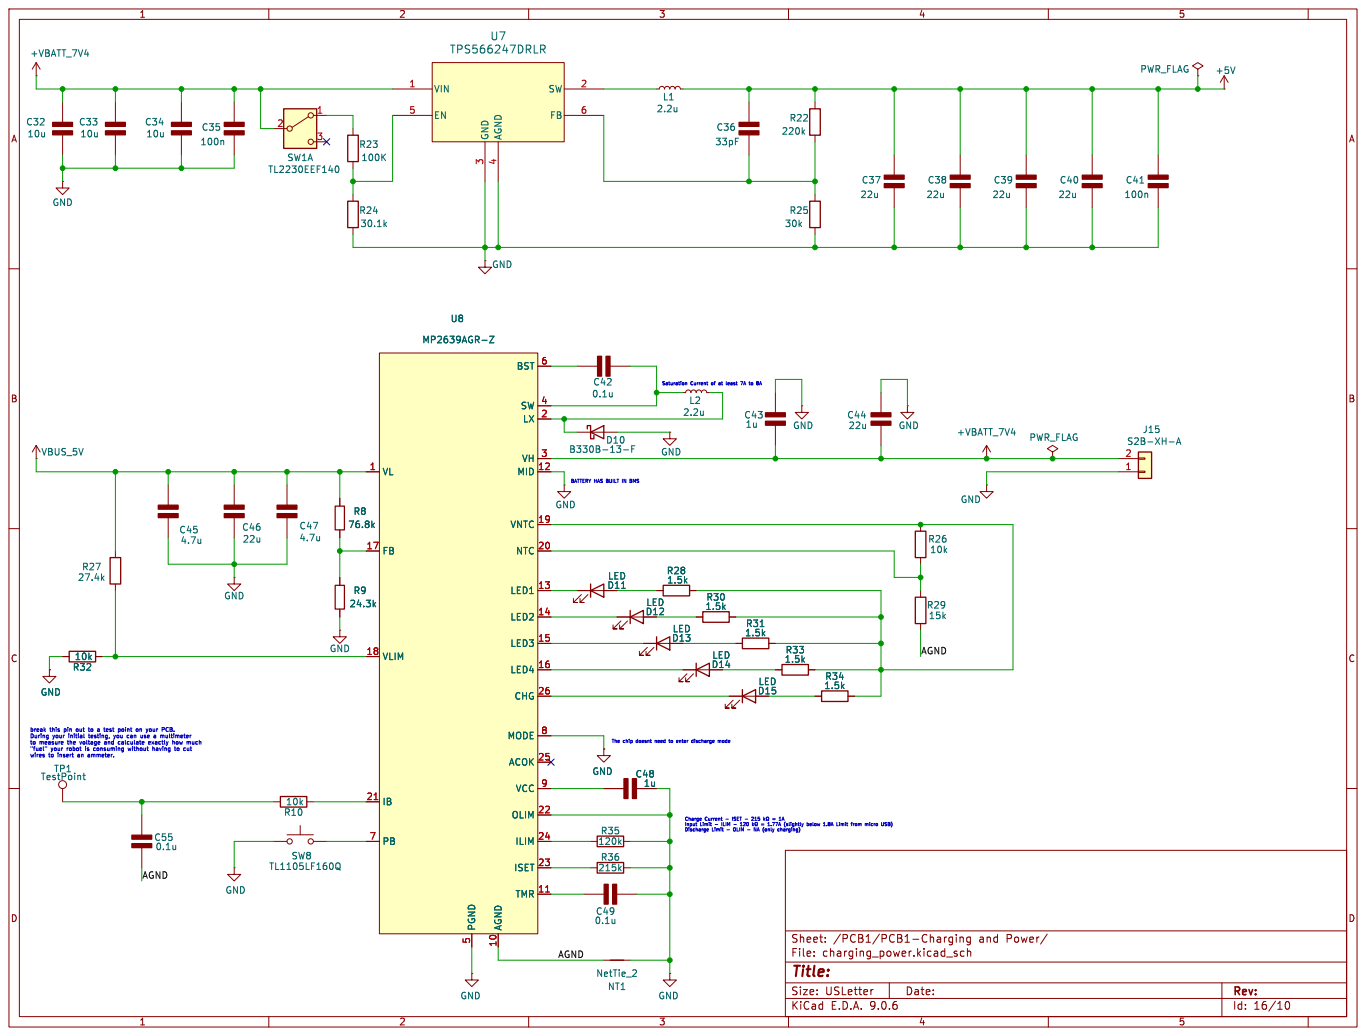
[picture p69: page 5]

BATTERY HAS BUILT IN BMS

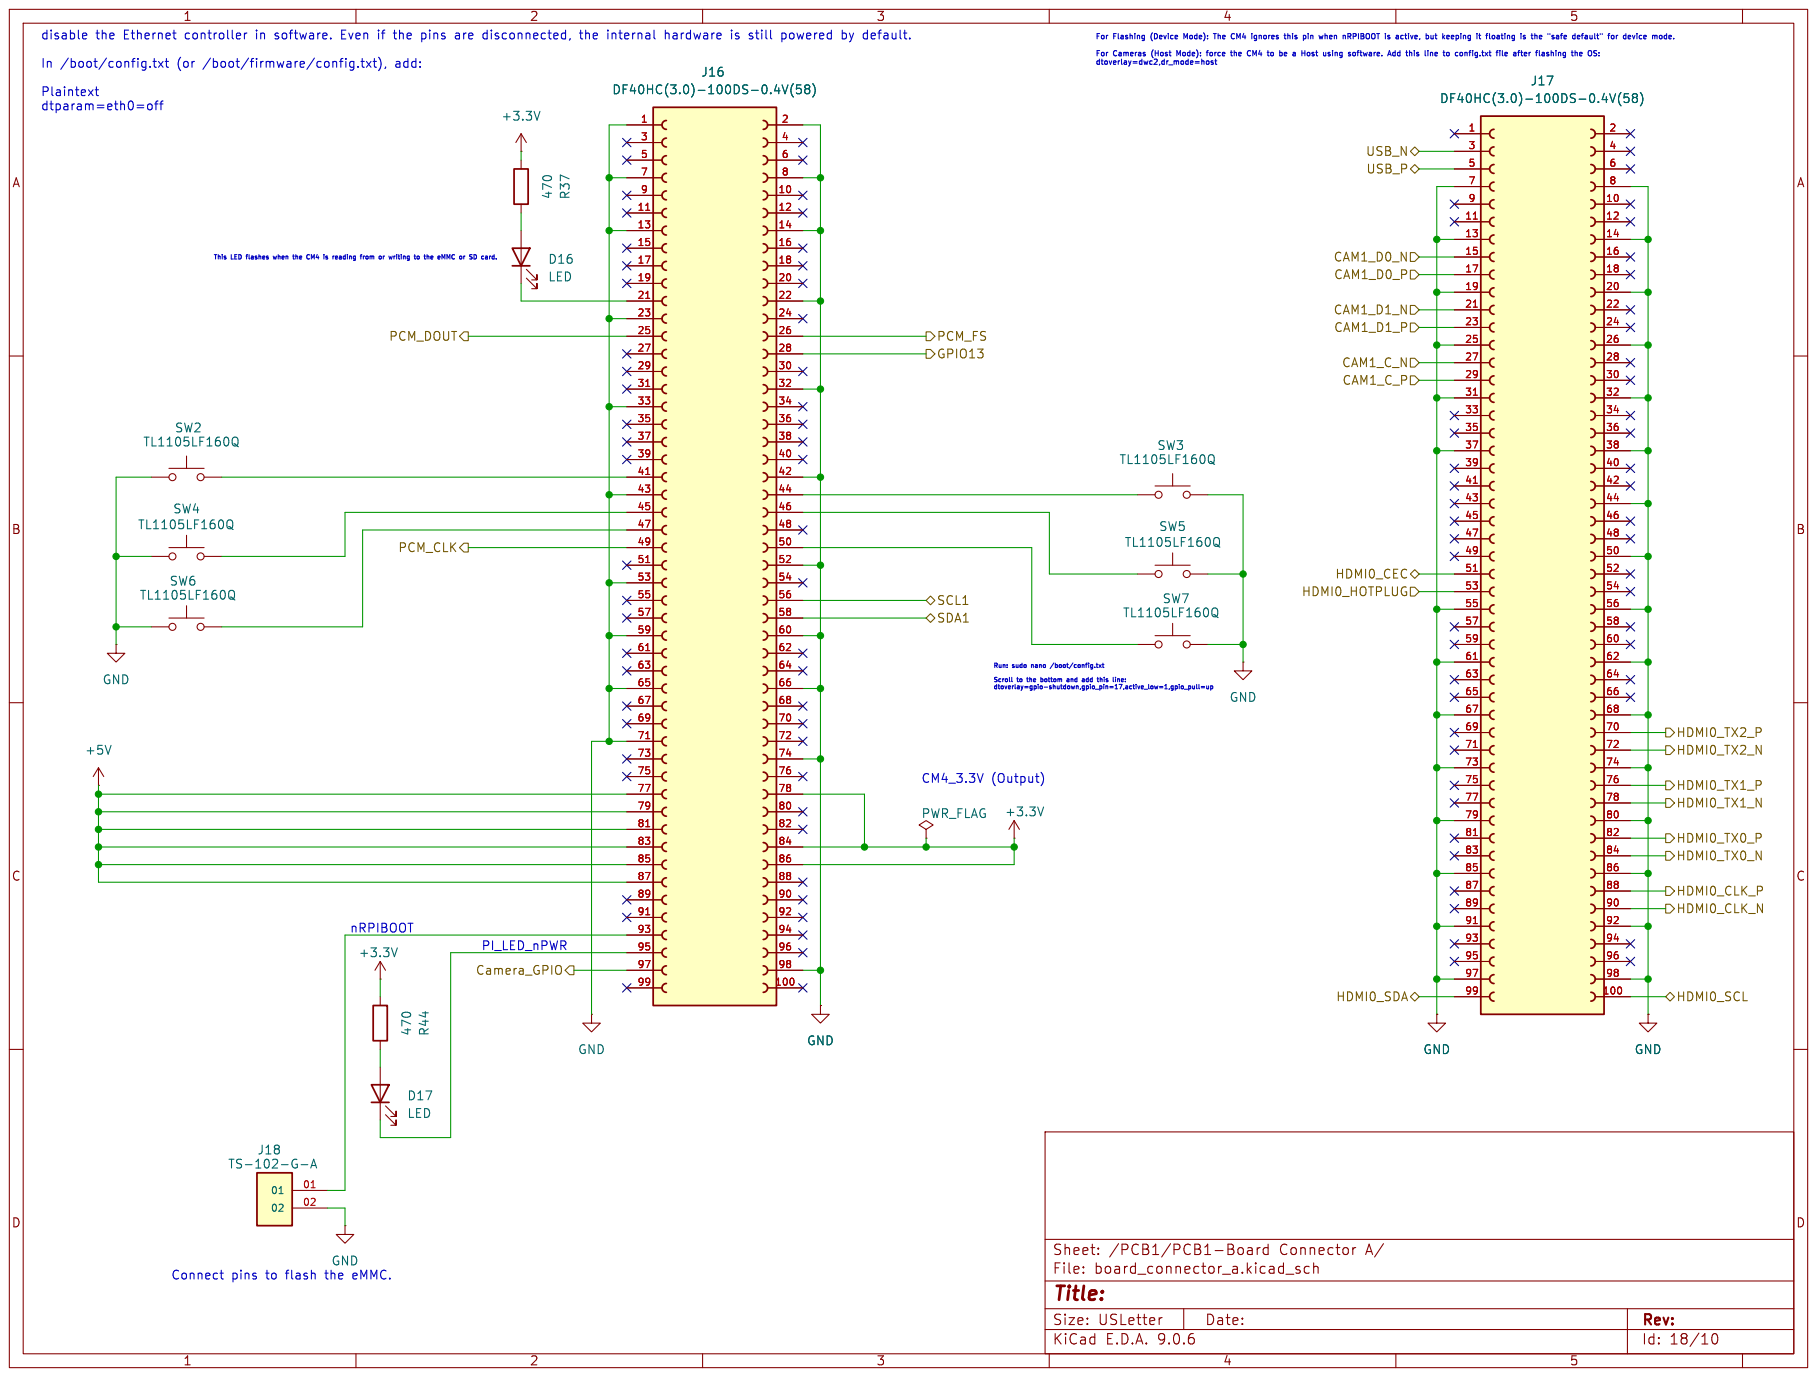
[picture p70: page 6]

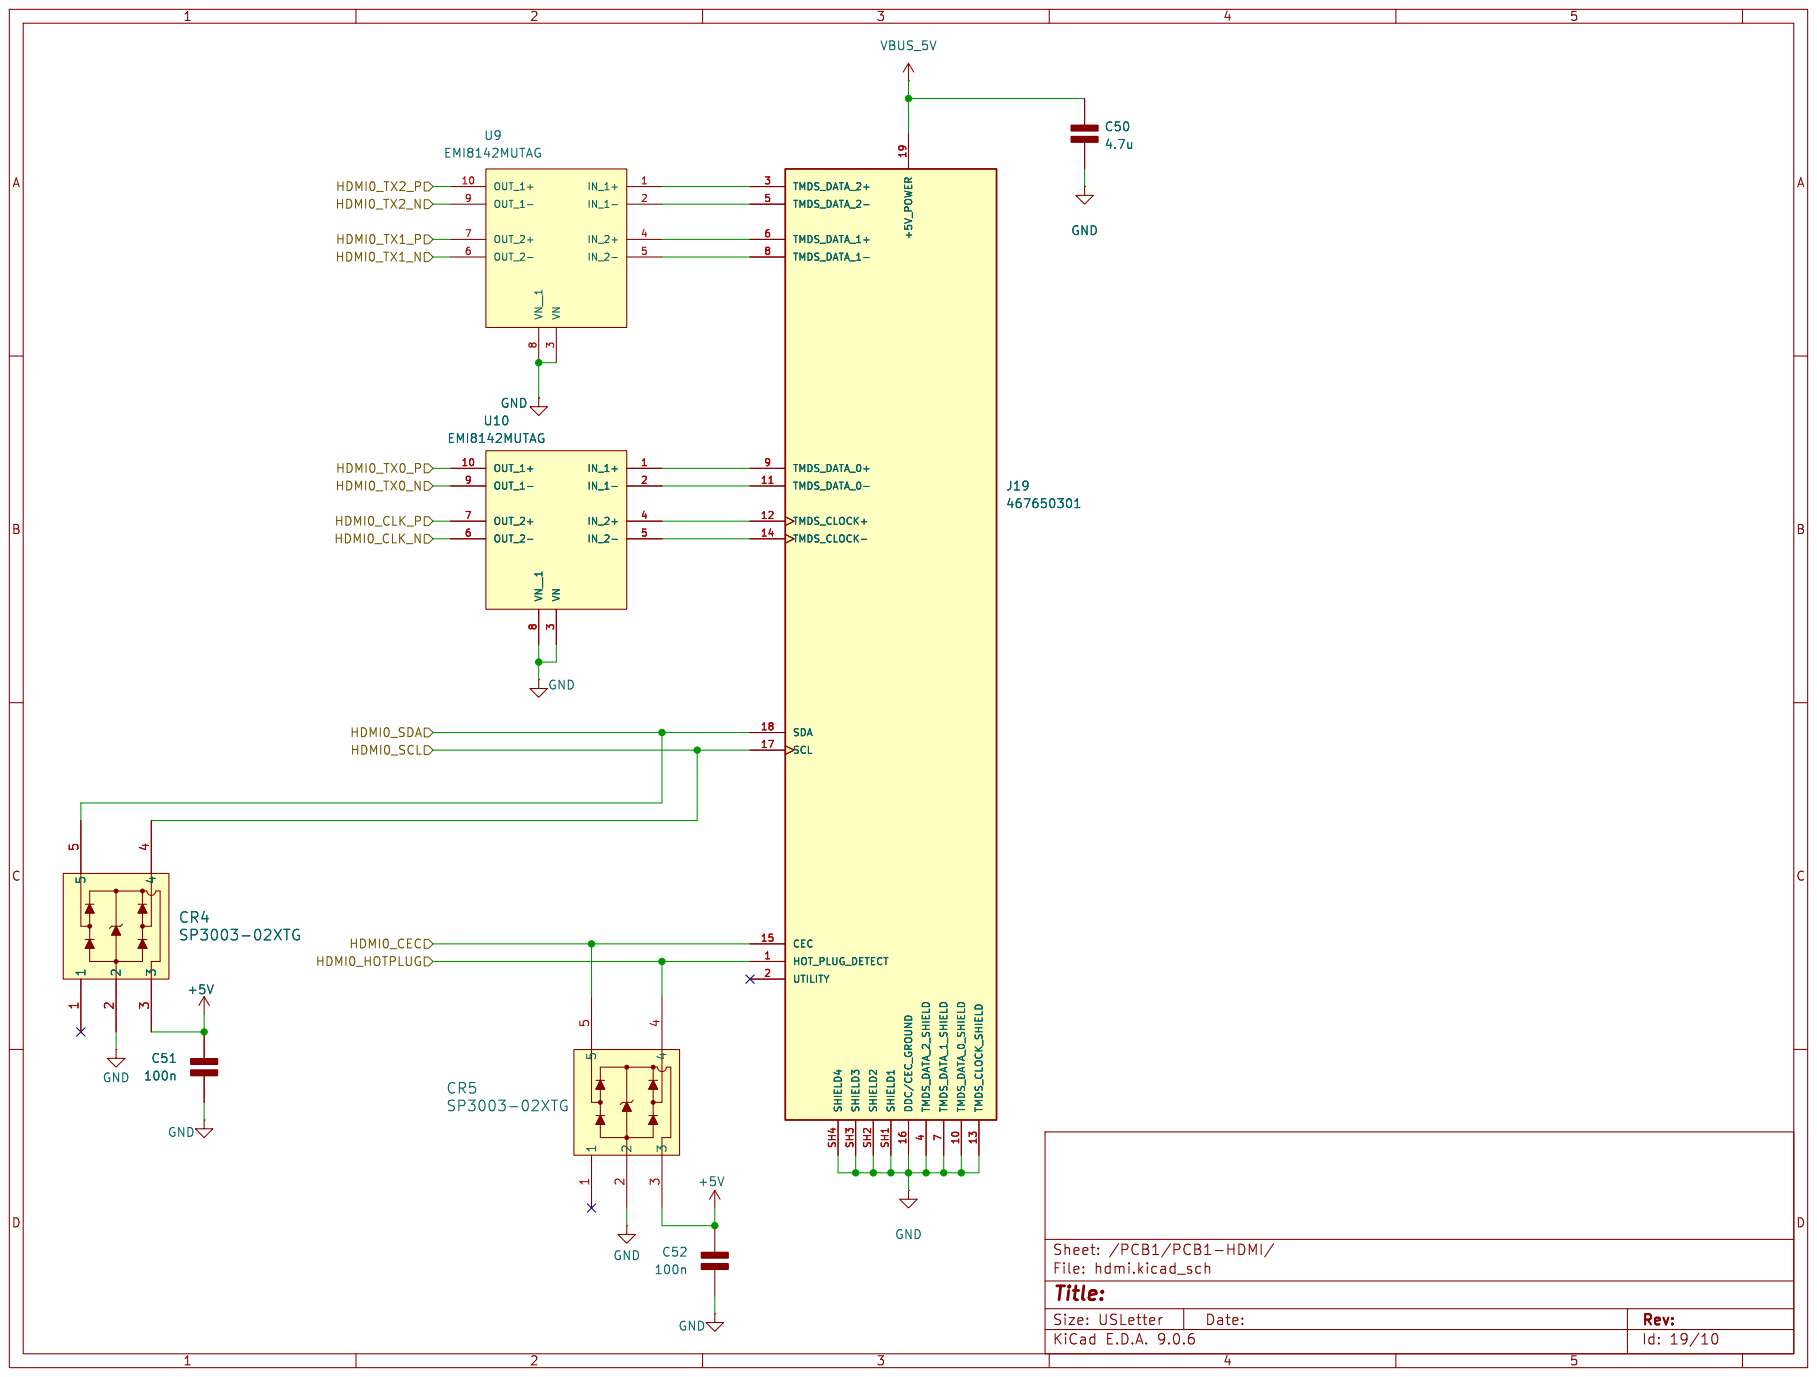
[picture p71: page 7]

Id: 19/10 Title: File: hdmi.kicad_sch Sheet: /PCB1/PCB1-HDMI/

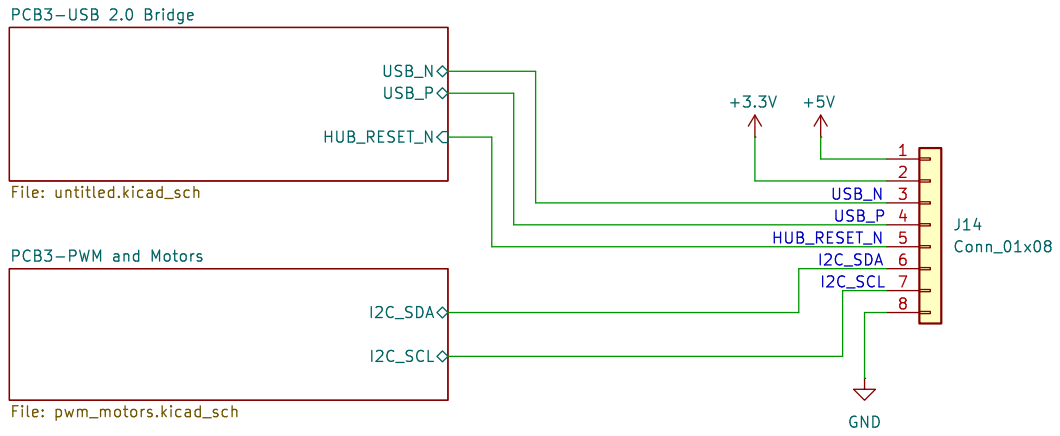
[picture p72: page 8]

Id: 15/10 Title: File: PCB3.kicad_sch Sheet: /PCB3/

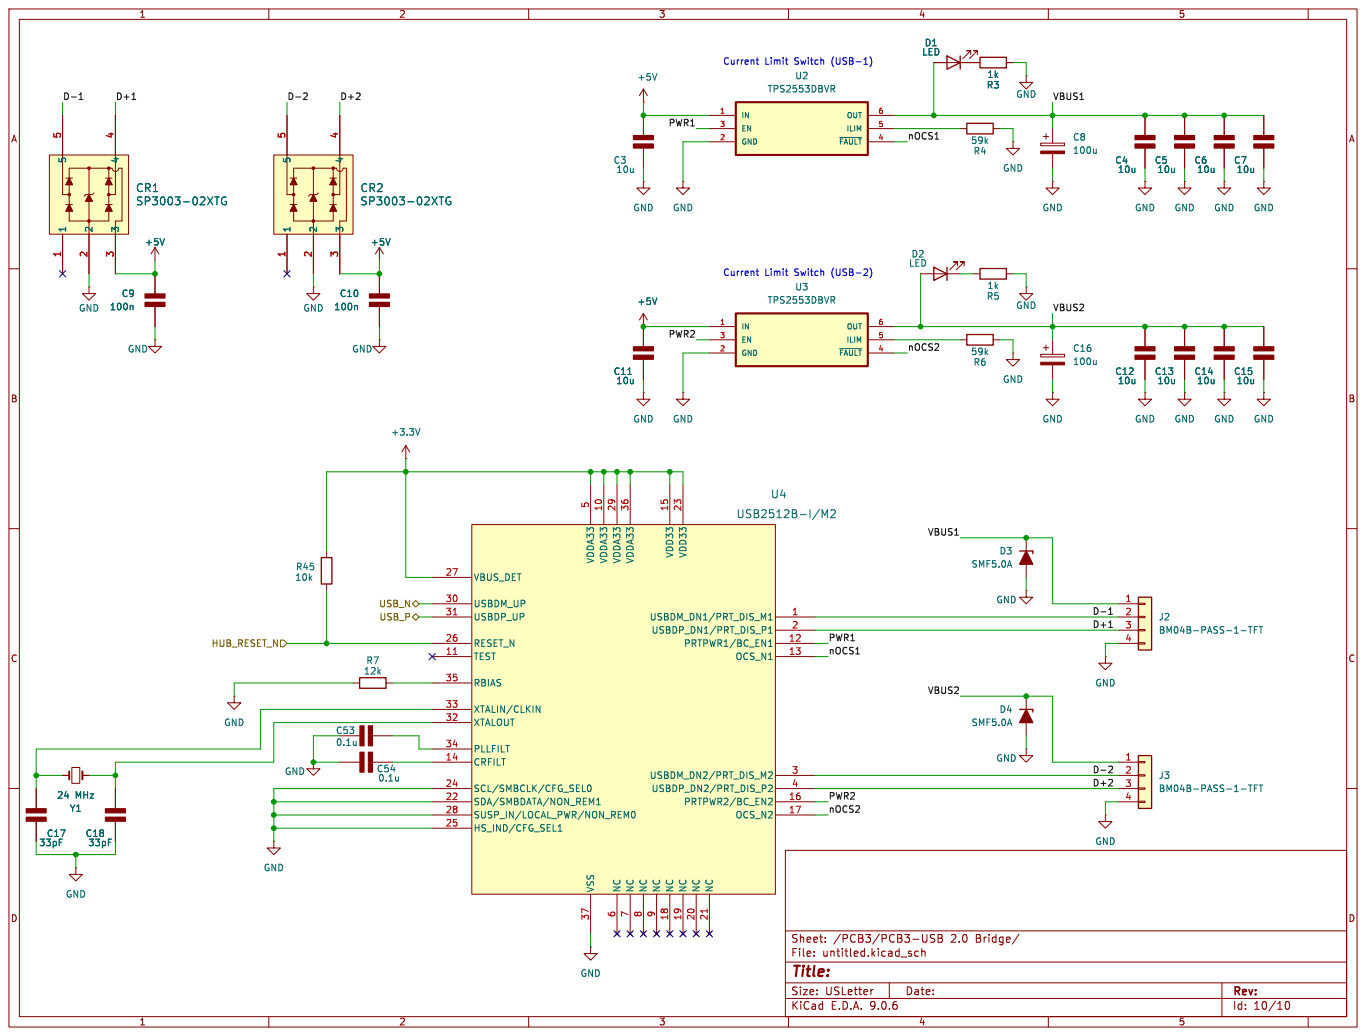
[picture p73: page 9]

Current Limit Switch (USB-1)

9 VDD33 15 NC 18 VDD33 23 NC 19 NC 20 NC 21 USBDM_DN1/PRT_DIS_M1 1 USBDP_DN1/PRT_DIS_P1 2 PRTPWR1/BC_EN1 12 OCS_N1 13 USBDM_DN2/PRT_DIS_M2 3 USBDP_DN2/PRT_DIS_P2 4 PRTPWR2/BC_EN2 16 OCS_N2 17 U4 USB2512B-I/M2

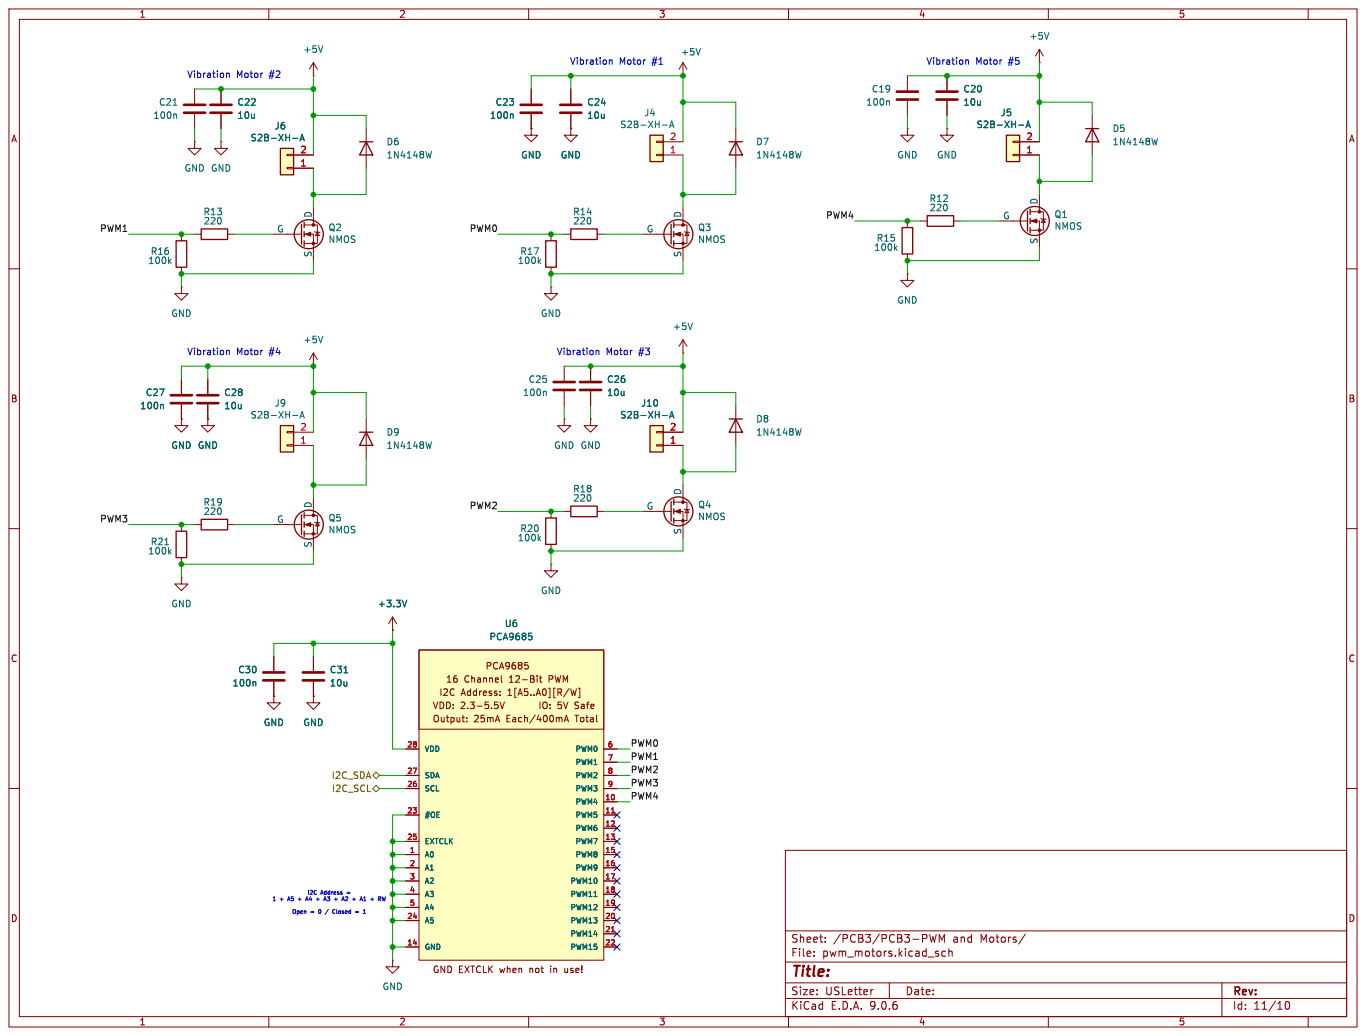
[picture p74: page 10]
