heyitsarthur/COEN490/490_0/490-24_Schematic V3.pdf

Id: 1/10 Title: File: 490_0.kicad_sch Sheet: /


in config.txt: dtoverlay=arducam-pivariety,i2c_bus=1

Id: 13/10 Title: File: PCB1.kicad_sch Sheet: /PCB1/


7 PAD 17 OUTP 9 OUTN 10 U1 MAX98357A GND

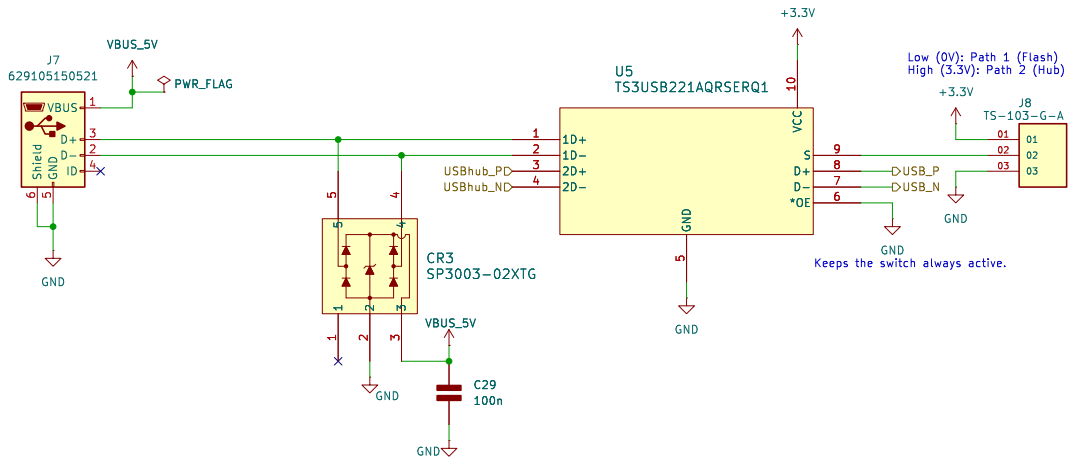
[picture p75: page 4]

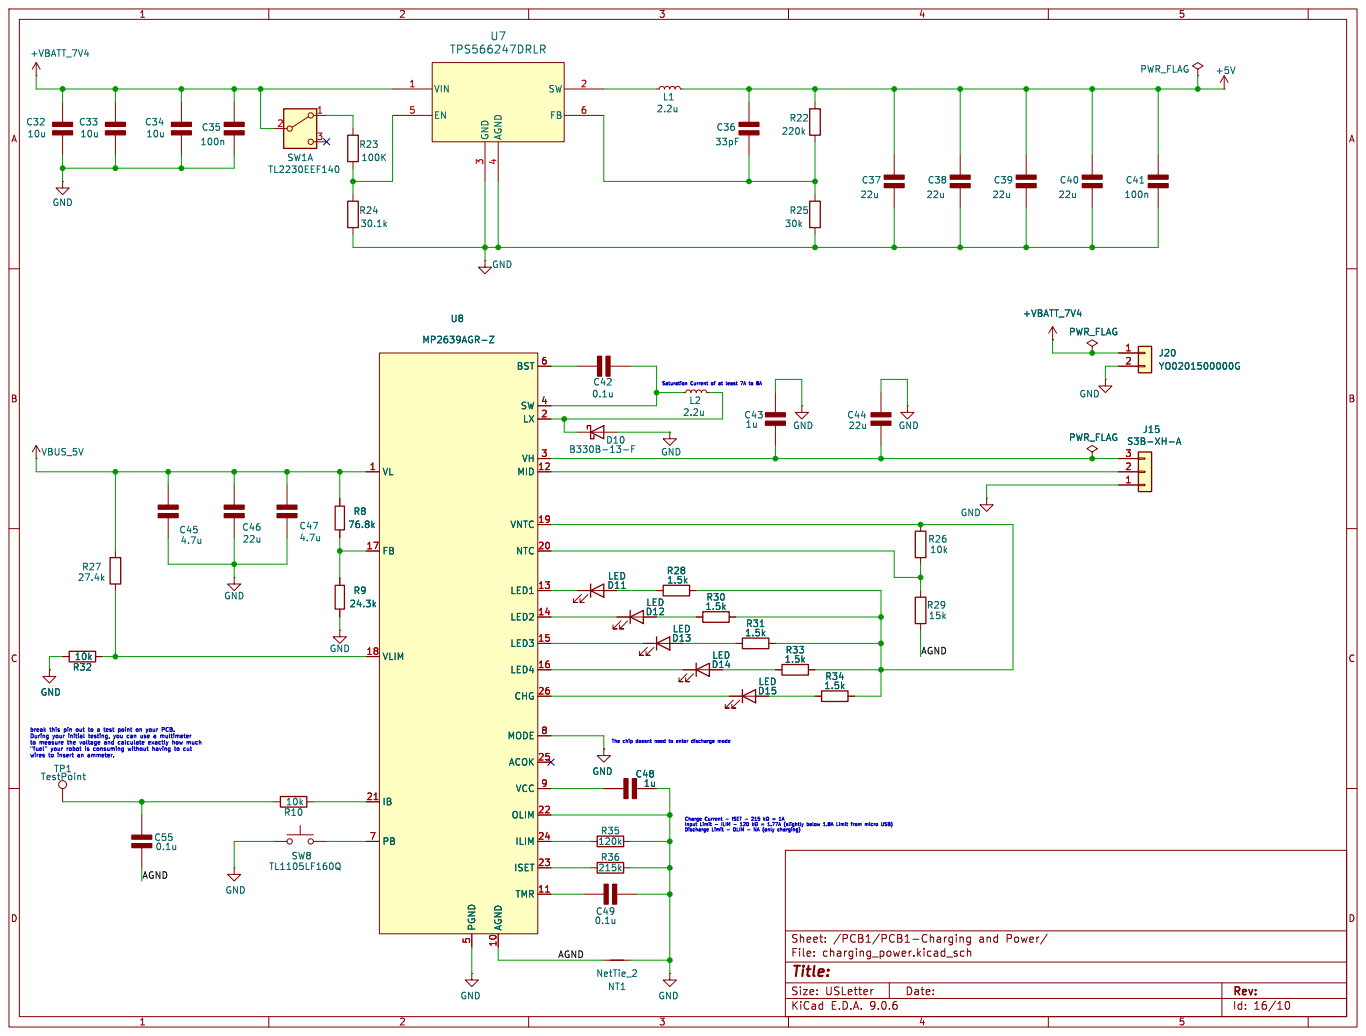
[picture p76: page 5]




Id: 15/10 Title: File: PCB3.kicad_sch Sheet: /PCB3/


9 VDD33 15 NC 18 VDD33 23 NC 19 NC 20 NC 21 USBDM_DN1/PRT_DIS_M1 1 USBDP_DN1/PRT_DIS_P1 2 PRTPWR1/BC_EN1 12 OCS_N1 13 USBDM_DN2/PRT_DIS_M2 3 USBDP_DN2/PRT_DIS_P2 4 PRTPWR2/BC_EN2 16 OCS_N2 17 U4 USB2512B-I/M2 GND

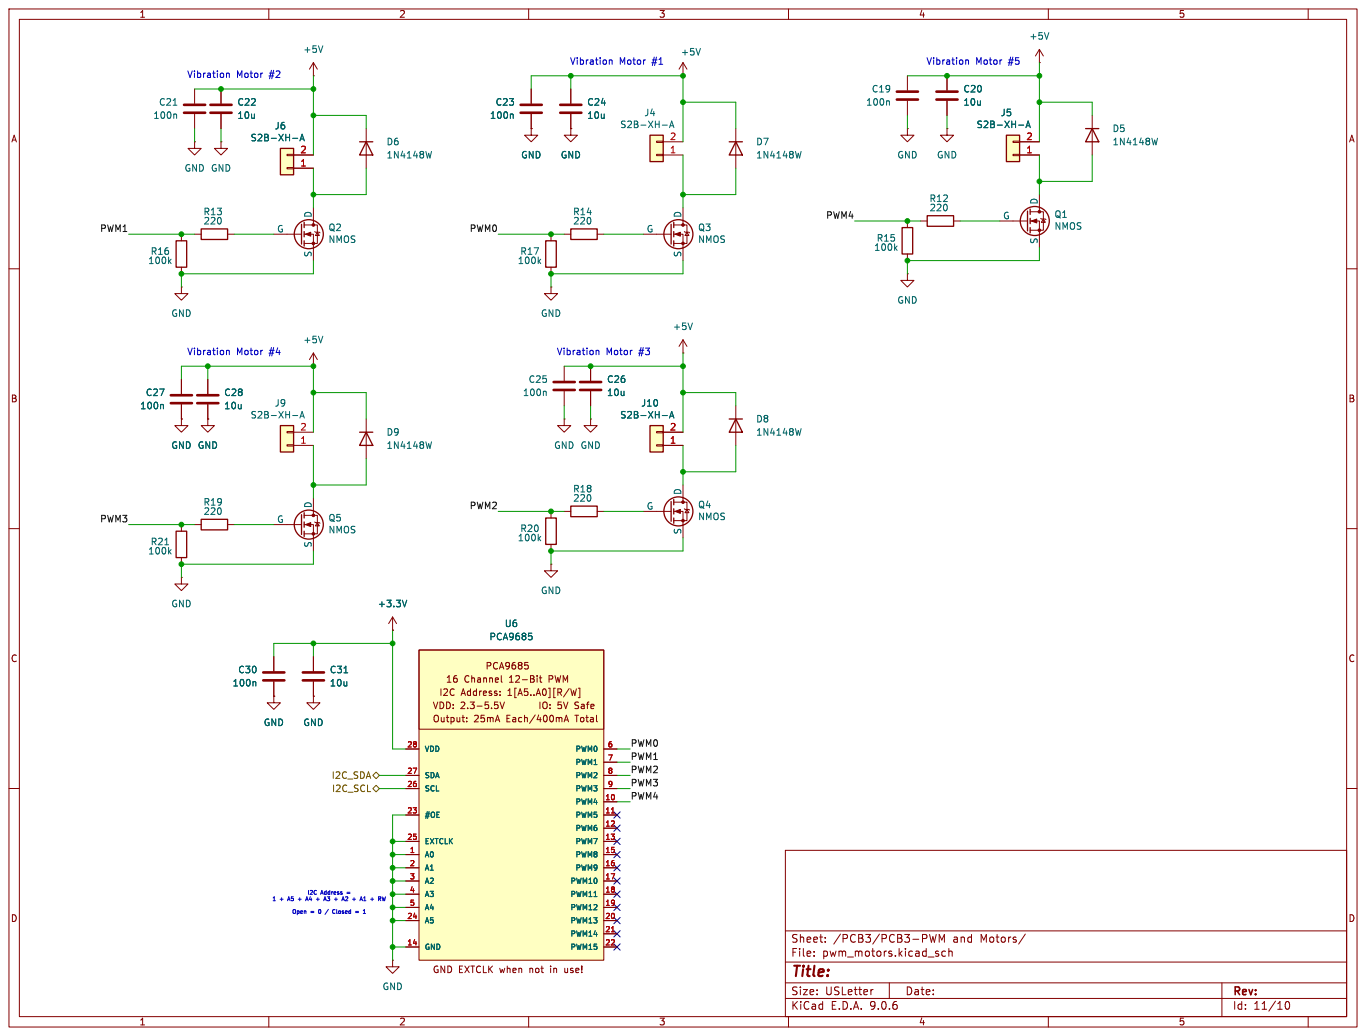
[picture p77: page 10]
