heyitsarthur/COEN490/490_0/490_0.kicad_pcb

## KiCad design 490_0/490_0.kicad_pcb (2026-04-03)

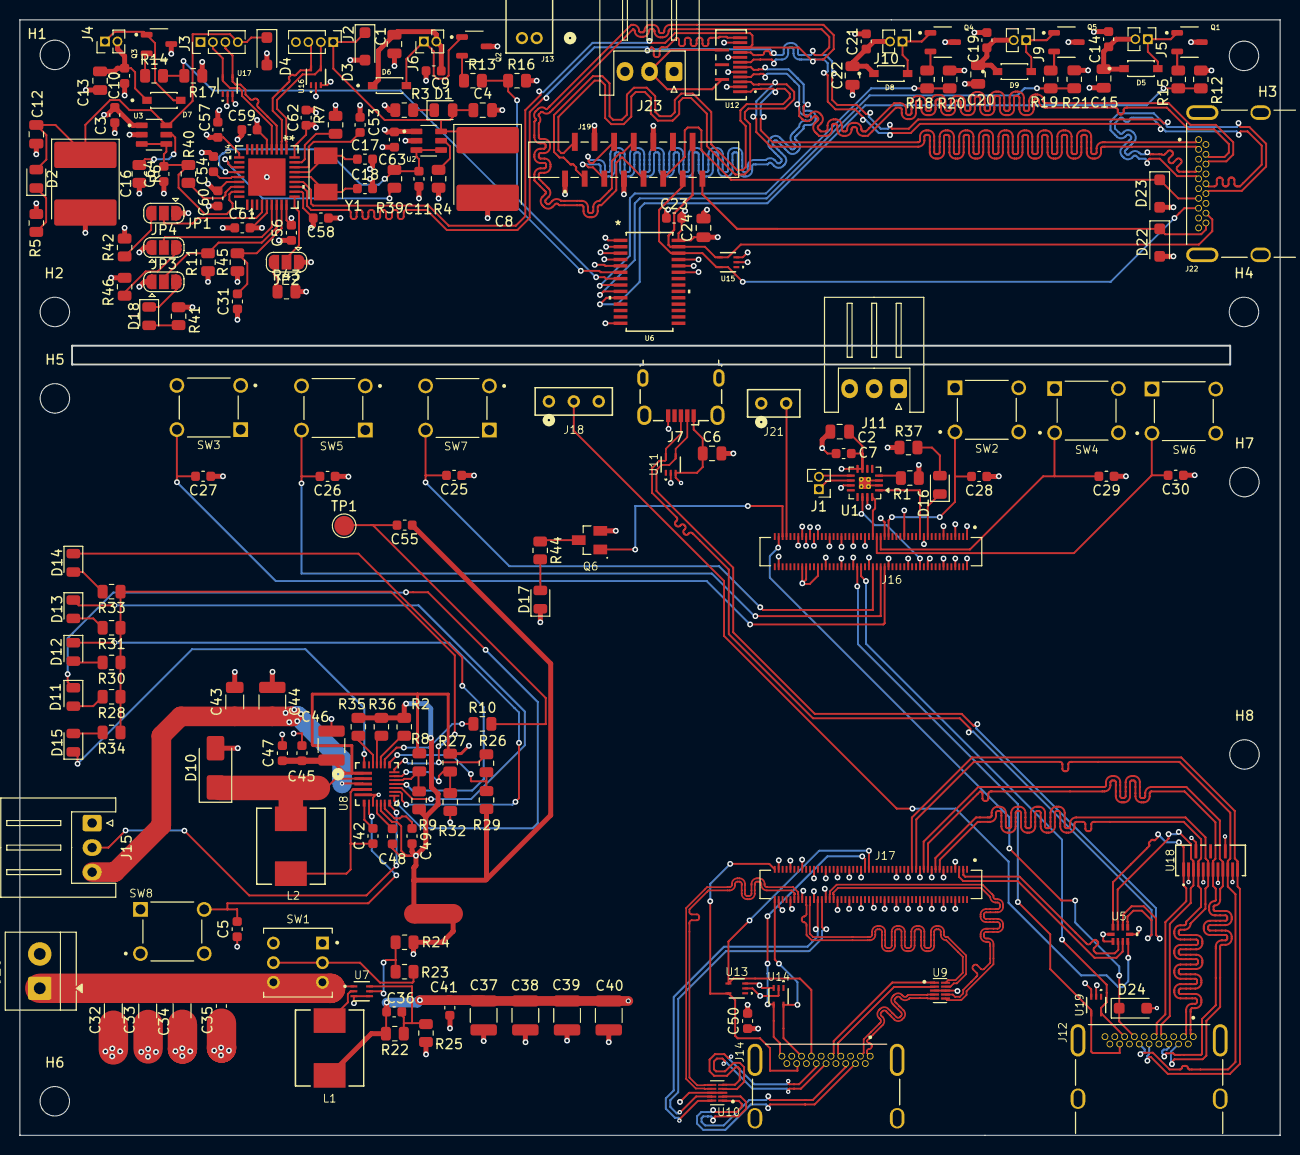
[picture p85: board 490_0.kicad_pcb from above]

Board: 4 copper layers, 128.5 x 113.7 mm, 200 parts (0 on the bottom side), 147 nets.

Parts:
C1, C2, C4, C6, C12, C13, C15, C20, C22, C24: 10u; C_0805_2012Metric
C3, C5, C7, C9, C10, C11, C14, C19, C21, C23, C25, C26, C27, C28, C29, C30, C31, C35, C41, C42, C49, C53, C54, C55, C56, C57, C58, C59, C60, C61, C63, C64: 100n; C_0603_1608Metric
C8, C16: 120u; CP_EIA-7260-38_AVX-R_HandSolder
C17, C18, C36: 33pF; C_0603_1608Metric
C32, C33, C34: 10u; C_1206_3216Metric
C37, C38, C39, C40, C44, C46: 22u; C_1210_3225Metric
C43: 1u; C_1206_3216Metric
C45, C47, C50: 4.7u; C_0603_1608Metric
C48, C62: 1u; C_0603_1608Metric
D1, D2: LTST-C170TBKT; LED_0805_2012Metric
D3, D4: SMF5.0A; D_SOD-123F
D5, D6, D7, D8, D9: 1N4148W; SODFL3816X120N
D10: B330B-13-F; D_SMA
D11, D12, D13, D14, D16, D18: LTST-C170GKT; LED_0805_2012Metric
D15: LTST-C170YKT; LED_0805_2012Metric
D17: LTST-C170KRKT; LED_0805_2012Metric
D22, D23, D24: GSMF3.3A; D_SOD-123F
H1, H2, H3, H4, H5, H6, H7, H8: MountingHole; MountingHole_3mm
J1, J4, J5, J6, J9, J10: PAD; PinHeader_1x02_P1.27mm_Vertical
J2, J3: PAD; PinHeader_1x04_P1.27mm_Vertical
J7: 629105150521; USB_Micro-B_Wuerth_629105150521
J11, J15, J23: S3B-XH-A; JST_XH_S3B-XH-A_1x03_P2.50mm_Horizontal
J12, J14, J22: 2000-1-1-20-00-BK; CNCTECH_2000-1-1-20-00-BK
J13: S2B-ZR; CONN_S2B-ZR_JST
J16, J17: DF40HC(3.0)-100DS-0.4V(58); HIROSE_DF40C-100DS-0.4V_51_
J18: TS-103-G-A; CON3_1X3_TU_HTS_SAI - 3POS Connector
J19: SFW15S-2STE1LF
J20: YO0201500000G; TerminalBlock_4Ucon_1x02_P3.50mm_Horizontal
J21: TS-102-G-A; CON2_1X2_TU_HTS_SAI
JP1, JP2, JP3, JP4: SolderJumper-3_P1.3mm_Open_RoundedPad1.0x1.5mm
L1, L2: 2.2u; IND_SRP6540-2R2M_BRN
NT2: NetTie_2; NetTie-2_SMD_Pad2.0mm
Q1, Q2, Q3, Q4, Q5: AO3400A; SOT95P280X125-3N
Q6: BSS84; SOT95P240X120-3N
R1, R15, R16, R17, R20, R21, R23, R39, R40: 100k; R_0805_2012Metric
R2, R36: 215k; R_0805_2012Metric
R3, R5: 1k; R_0805_2012Metric
R4, R6: 20k; R_0805_2012Metric
R7: 12k; R_0805_2012Metric
R8: 76.8k; R_0805_2012Metric
R9: 24.3k; R_0805_2012Metric
R10, R26, R32, R42, R43, R45, R46: 10k; R_0805_2012Metric
R11: 330; R_0805_2012Metric
R12, R13, R14, R18, R19: 220; R_0805_2012Metric
R22: 220k; R_0805_2012Metric
R24: 30.1k; R_0805_2012Metric
R25: 30k; R_0805_2012Metric
R27: 27.4k; R_0805_2012Metric
R28, R30, R31, R33, R34, R41: 1.5k; R_0805_2012Metric
R29: 15k; R_0805_2012Metric
R35: 120k; R_0805_2012Metric
R37, R44: 470; R_0805_2012Metric
SW1: TL2230EEF140; SW_TL2230EEF140
SW2, SW3, SW4, SW5, SW6, SW7, SW8: TL1105LF160Q; SW_TL1105LF160Q
TP1: TestPoint; TestPoint_Pad_D2.0mm
U1: MAX98357A; TQFN-16-1EP_3x3mm_P0.5mm_EP1.23x1.23mm_ThermalVias
U2, U3: TPS2553DBVR; SOT95P280X145-6N_TPS2553DBVR
U4: USB2512B-I/M2; SQFN36_M2_MCH_USB2512B_I_M2
U5: TS3USB221AQRSERQ1; RSE10
U6: PCA9685; TSSOP28_SOT361-1_NXP
U7: TPS566247DRLR; SOT-5X3-6_DRL_TEX
U8: MP2639AGR-Z; IC26_MP2632BGR-Z_MNP
U9, U10: EMI8142MUTAG; SON40P220X135X50-10N_EMI8142MUTAG
U11, U13, U14, U15, U16, U17, U19: SP3003-02XTG; SOT553_LTF_SP3003_02XTG
U12, U18: TPD8S009DSMR
Y1: 24M20P2/XT324-10/10; Crystal_SMD_TXC_7A-2Pin_5x3.2mm

Connections:
+3.3V: J11.2, J12.18 (+5V), J16.78, J16.84, J16.86, J18.1, Q6.2 (S), R37.1, U5.10 (VCC), U18.13 (VCC), U18.15 (VCC), U19.3
+3.3V_GLASSES: C3.2 (-), C23.2 (-), C24.1 (+), C56.2 (-), C57.2 (-), C58.2 (-), C59.2 (-), C60.2 (-), C61.2 (-), C62.2 (-), C63.2 (-), J23.2, R41.1, R42.2, R43.2, R45.1, R46.2, U2.1 (IN), U3.1 (IN), U4.5 (VDDA33), U4.10 (VDDA33), U4.15 (VDD33), U4.23 (VDD33), U4.27 (VBUS_DET), U4.29 (VDDA33), U4.36 (VDDA33), U6.28 (VDD), U12.13 (VCC), U12.15 (VCC), U15.3
+5V: C2.1 (+), C7.2 (-), C36.2 (-), C37.2 (-), C38.2 (-), C39.2 (-), C40.2 (-), C41.2 (-), C50.1 (+), J11.3, J14.18 (+5V), J16.77, J16.79, J16.81, J16.83, J16.85, J16.87, L1.2, R1.1, R22.2, U1.7 (VDD), U1.8 (VDD), U13.3, U14.3
+5V_GLASSES: C1.1 (+), C9.2 (-), C10.2 (-), C13.1 (+), C14.2 (-), C15.1 (+), C19.2 (-), C20.1 (+), C21.2 (-), C22.1 (+), D5.1 (K), D6.1 (C), D7.1 (K), D8.1 (K), D9.1 (K), J4.2, J5.2, J6.2, J9.2, J10.2, J13.2, J23.3, U16.3, U17.3
+VBATT_7V4: C32.2 (-), C33.2 (-), C34.2 (-), C35.2 (-), J20.1, SW1.3 (C), SW1.6 (C), U7.1 (VIN)
/PCB1/PCB1-Board Connector A/CAM1_C_N: J12.12 (CK-), J17.27, U18.10 (D3+)
/PCB1/PCB1-Board Connector A/CAM1_C_P: J12.10 (CK+), J17.29, U18.12 (D3-)
/PCB1/PCB1-Board Connector A/CAM1_D0_N: J12.3 (D2-), J17.15, U18.4 (D1+)
/PCB1/PCB1-Board Connector A/CAM1_D0_P: J12.1 (D2+), J17.17, U18.6 (D1-)
/PCB1/PCB1-Board Connector A/CAM1_D1_N: J12.6 (D1-), J17.21, U18.7 (D2+)
/PCB1/PCB1-Board Connector A/CAM1_D1_P: J12.4 (D1+), J17.23, U18.9 (D2-)
/PCB1/PCB1-Board Connector A/Camera_GPIO: D24.1 (K), J12.13 (CEC), J16.97
/PCB1/PCB1-Board Connector A/HDMI0_CEC: J14.13 (CEC), J17.51, U13.4
/PCB1/PCB1-Board Connector A/HDMI0_CLK_N: J17.90, U10.6 (OUT_2-)
/PCB1/PCB1-Board Connector A/HDMI0_CLK_P: J17.88, U10.7 (OUT_2+)
/PCB1/PCB1-Board Connector A/HDMI0_HOTPLUG: J14.19 (HPD), J17.53, U14.4
/PCB1/PCB1-Board Connector A/HDMI0_SCL: J14.15 (SCL), J17.100, U14.5
/PCB1/PCB1-Board Connector A/HDMI0_SDA: J14.16 (SDA), J17.99, U13.5
/PCB1/PCB1-Board Connector A/HDMI0_TX0_N: J17.84, U9.10 (OUT_1+)
/PCB1/PCB1-Board Connector A/HDMI0_TX0_P: J17.82, U9.9 (OUT_1-)
/PCB1/PCB1-Board Connector A/HDMI0_TX1_N: J17.78, U10.10 (OUT_1+)
/PCB1/PCB1-Board Connector A/HDMI0_TX1_P: J17.76, U10.9 (OUT_1-)
/PCB1/PCB1-Board Connector A/HDMI0_TX2_N: J17.72, U9.6 (OUT_2-)
/PCB1/PCB1-Board Connector A/HDMI0_TX2_P: J17.70, U9.7 (OUT_2+)
/PCB1/PCB1-Board Connector A/PCM_CLK: J16.49, U1.16 (BCLK)
/PCB1/PCB1-Board Connector A/PCM_DOUT: J16.25, U1.1 (DIN)
/PCB1/PCB1-Board Connector A/PCM_FS: J16.26, U1.14 (LRCLK)
/PCB1/PCB1-Board Connector A/SCL1: J12.15 (SCL), J16.56, U19.5
/PCB1/PCB1-Board Connector A/SDA1: J12.16 (SDA), J16.58, U19.4
/PCB1/PCB1-Board Connector A/USB_N: J17.3, U5.7 (D-)
/PCB1/PCB1-Board Connector A/USB_P: J17.5, U5.8 (D+)
/PCB1/PCB1-Charging and Power Port + USB switch/MICROD+: J7.3 (D+), U5.1 (1D+), U11.5
/PCB1/PCB1-Charging and Power Port + USB switch/MICROD-: J7.2 (D-), U5.2 (1D-), U11.4
/PCB1/PCB1-Charging and Power Port + USB switch/USBhub_N: J12.9 (D0-), U5.4 (2D-), U18.1 (D0+)
/PCB1/PCB1-Charging and Power Port + USB switch/USBhub_P: J12.7 (D0+), U5.3 (2D+), U18.3 (D0-)
/PCB1/PCB1-HDMI/CLK+: J14.10 (CK+), U10.4 (IN_2+)
/PCB1/PCB1-HDMI/CLK-: J14.12 (CK-), U10.5 (IN_2-)
/PCB1/PCB1-HDMI/D0+: J14.7 (D0+), U9.2 (IN_1−)
/PCB1/PCB1-HDMI/D0-: J14.9 (D0-), U9.1 (IN_1+)
/PCB1/PCB1-HDMI/D1+: J14.6 (D1-), U10.2 (IN_1−)
/PCB1/PCB1-HDMI/D1-: J14.4 (D1+), U10.1 (IN_1+)
/PCB1/PCB1-HDMI/D2+: J14.3 (D2-), U9.4 (IN_2+)
/PCB1/PCB1-HDMI/D2-: J14.1 (D2+), U9.5 (IN_2-)
/PCB2/CK+: J19.9, J22.7 (D0+), J22.10 (CK+), U4.31 (USBDP_UP), U12.7 (D2+), U12.10 (D3+)
/PCB2/CK-: J19.8, J22.9 (D0-), J22.12 (CK-), U4.30 (USBDM_UP), U12.9 (D2-), U12.12 (D3-)
/PCB2/D0+: J19.3, J22.1 (D2+), U12.1 (D0+)
/PCB2/D0-: J19.2, J22.3 (D2-), U12.3 (D0-)
/PCB2/D1+: J19.6, J22.4 (D1+), U12.4 (D1+)
/PCB2/D1-: J19.5, J22.6 (D1-), U12.6 (D1-)
/PCB2/PCB2-PWM and Motors/I2C_SCL: J19.13, J22.15 (SCL), U6.26 (SCL), U15.5
/PCB2/PCB2-PWM and Motors/I2C_SDA: J19.14, J22.16 (SDA), U6.27 (SDA), U15.4
/PCB2/PCB2-PWM and Motors/PWM0: R14.2, R17.1, U6.6 (PWM0)
/PCB2/PCB2-PWM and Motors/PWM1: R13.2, R16.1, U6.7 (PWM1)
/PCB2/PCB2-PWM and Motors/PWM2: R18.2, R20.1, U6.8 (PWM2)
/PCB2/PCB2-PWM and Motors/PWM3: R19.2, R21.1, U6.9 (PWM3)
/PCB2/PCB2-PWM and Motors/PWM4: R12.2, R15.1, U6.10 (PWM4)
/PCB2/PCB2-USB 2.0 Bridge/D1+: J2.3, U4.2 (USBDP_DN1/PRT_DIS_P1), U16.5
/PCB2/PCB2-USB 2.0 Bridge/D1-: J2.2, U4.1 (USBDM_DN1/PRT_DIS_M1), U16.4
/PCB2/PCB2-USB 2.0 Bridge/D2+: J3.2, U4.4 (USBDP_DN2/PRT_DIS_P2), U17.5
/PCB2/PCB2-USB 2.0 Bridge/D2-: J3.3, U4.3 (USBDM_DN2/PRT_DIS_M2), U17.4
/PCB2/PCB2-USB 2.0 Bridge/EN1: R39.2, U4.12 (PRTPWR1/BC_EN1)
/PCB2/PCB2-USB 2.0 Bridge/EN2: R40.2, U4.16 (PRTPWR2/BC_EN2)
/PCB2/PCB2-USB 2.0 Bridge/nOCS1: C11.2 (-), R39.1, U2.3 (EN), U2.4 (~FAULT), U4.13 (OCS_N1)
/PCB2/PCB2-USB 2.0 Bridge/nOCS2: C64.2 (-), R40.1, U3.3 (EN), U3.4 (~FAULT), U4.17 (OCS_N2)
GND: C2.2 (-), C5.1 (+), C6.2 (-), C7.1 (+), C25.1 (+), C26.1 (+), C27.1 (+), C28.1 (+), C29.1 (+), C30.1 (+), C32.1 (+), C33.1 (+), C34.1 (+), C35.1 (+), C37.1 (+), C38.1 (+), C39.1 (+), C40.1 (+), C41.1 (+), C43.2 (-), C44.1 (+), C45.2 (-), C46.2 (-), C47.2 (-), C48.2 (-), C49.2 (-), C50.2 (-), C55.1 (+), D10.2 (A), D17.1 (K), D24.2 (A), J7.5 (GND), J7.6 (Shield), J11.1, J12.2 (D2S), J12.5 (D1S), J12.8 (D0S), J12.11 (CKS), J12.17 (GND), J12.SH1, J12.SH2, J12.SH3, J12.SH4, J14.2 (D2S), J14.5 (D1S), J14.8 (D0S), J14.11 (CKS), J14.17 (GND), J14.SH1, J14.SH2, J14.SH3, J14.SH4, J15.1, J16.1, J16.2, J16.7, J16.8, J16.13, J16.14, J16.22, J16.23, J16.32, J16.33, J16.42, J16.43, J16.52, J16.53, J16.59, J16.60, J16.65, J16.66, J16.71, J16.74, J16.98, J17.7, J17.8, J17.13, J17.14, J17.19, J17.20, J17.25, J17.26, J17.31, J17.32, J17.37, J17.38, J17.44, J17.50, J17.55, J17.56, J17.61, J17.62, J17.67, J17.68, J17.73, J17.74, J17.79, J17.80, J17.85, J17.86, J17.91, J17.92, J17.97, J17.98, J18.3, J20.2, J21.1, NT2.1, NT2.2, R2.1, R9.1, R24.1, R25.1, R29.1, R32.2, R35.1, R36.1, SW2.3, SW3.2, SW4.3, SW5.2, SW6.3, SW7.2, SW8.1, U1.2 (GAIN_SLOT), U1.3 (GND), U1.11 (GND), U1.15 (GND), U1.17 (PAD), U5.5 (GND), U5.6 (*OE), U7.3 (GND), U7.4 (AGND), U8.5 (PGND), U8.8 (MODE), U8.10 (AGND), U9.3 (VN), U9.8 (VN__1), U10.3 (VN), U10.8 (VN__1), U11.2, U13.2, U14.2, U18.2 (GND), U18.5 (GND), U18.8 (GND), U18.11 (GND), U19.2
GND_GLASSES: C1.2 (-), C3.1 (+), C4.2 (-), C8.2, C9.1 (+), C10.1 (+), C11.1 (+), C12.2 (-), C13.2 (-), C14.1 (+), C15.2 (-), C16.2, C17.2 (-), C18.2 (-), C19.1 (+), C20.2 (-), C21.1 (+), C22.2 (-), C23.1 (+), C24.2 (-), C31.1 (+), C53.1 (+), C54.1 (+), C56.1 (+), C57.1 (+), C58.1 (+), C59.1 (+), C60.1 (+), C61.1 (+), C62.1 (+), C63.1 (+), C64.1 (+), D3.2 (A), D4.2 (A), D22.2 (A), D23.2 (A), J2.4, J3.1, J13.1, J19.1, J19.4, J19.7, J19.10, J22.2 (D2S), J22.5 (D1S), J22.8 (D0S), J22.11 (CKS), J22.17 (GND), J22.SH1, J22.SH2, J22.SH3, J22.SH4, J23.1, JP1.1 (A), JP2.1 (A), JP3.1 (A), JP4.1 (A), Q1.3 (S), Q2.3 (S), Q3.3 (S), Q4.3 (S), Q5.3 (S), R3.1, R4.2, R5.1, R6.2, R7.2, R11.1, R15.2, R16.2, R17.2, R20.2, R21.2, U2.2 (GND), U3.2 (GND), U4.37 (VSS), U6.1 (A0), U6.2 (A1), U6.3 (A2), U6.4 (A3), U6.5 (A4), U6.14 (GND), U6.23 (#OE), U6.24 (A5), U6.25 (EXTCLK), U12.2 (GND), U12.5 (GND), U12.8 (GND), U12.11 (GND), U15.2, U16.2, U17.2
unnamed: C5.2 (-), SW8.3, U8.7 (PB)
unnamed: C17.1 (+), U4.33 (XTALIN/CLKIN), Y1.1
unnamed: C18.1 (+), U4.32 (XTALOUT), Y1.2
unnamed: C25.2 (-), J16.50, SW7.3
unnamed: C26.2 (-), J16.46, SW5.3
unnamed: C27.2 (-), J16.44, SW3.3
unnamed: C28.2 (-), J16.41, SW2.2
unnamed: C29.2 (-), J16.45, SW4.2
unnamed: C30.2 (-), J16.47, SW6.2
unnamed: C31.2 (-), R45.2, U4.26 (RESET_N)
unnamed: C36.1 (+), R22.1, R25.2, U7.6 (FB)
unnamed: C42.1 (+), U8.6 (BST)
unnamed: C42.2 (-), L2.1, U8.4 (SW)
unnamed: C43.1 (+), C44.2 (-), J15.3, U8.3 (VH)
unnamed: C48.1 (+), U8.9 (VCC)
unnamed: C49.1 (+), U8.11 (TMR)
unnamed: C53.2 (-), U4.34 (PLLFILT)
unnamed: C54.2 (-), U4.14 (CRFILT)
unnamed: C55.2 (-), R10.2, TP1.1
unnamed: D1.1 (K), R3.2
unnamed: D2.1 (K), R5.2
unnamed: D5.2 (A), J5.1, Q1.1 (D)
unnamed: D6.2 (A), J6.1, Q2.1 (D)
unnamed: D7.2 (A), J4.1, Q3.1 (D)
unnamed: D8.2 (A), J10.1, Q4.1 (D)
unnamed: D9.2 (A), J9.1, Q5.1 (D)
unnamed: D10.1 (K), L2.2, U8.2 (LX)
unnamed: D11.2 (A), R28.2
unnamed: D11.1 (K), U8.13 (LED1)
unnamed: D12.2 (A), R30.2
unnamed: D12.1 (K), U8.14 (LED2)
unnamed: D13.2 (A), R31.2
unnamed: D13.1 (K), U8.15 (LED3)
unnamed: D14.2 (A), R33.2
unnamed: D14.1 (K), U8.16 (LED4)
unnamed: D15.2 (A), R34.2
unnamed: D15.1 (K), U8.26 (CHG)
unnamed: D16.2 (A), R37.2
unnamed: D16.1 (K), J16.21
unnamed: D17.2 (A), R44.2
unnamed: D18.2 (A), R41.2
unnamed: D18.1 (K), JP3.3 (B)
unnamed: D22.1 (K), J19.15, J22.18 (+5V)
unnamed: D23.1 (K), J19.11, J22.13 (CEC)
unnamed: J1.1, U1.10 (OUTN)
unnamed: J1.2, U1.9 (OUTP)
unnamed: J15.2, U8.12 (MID)
unnamed: J18.2, U5.9 (S)
unnamed: J16.93, J21.2
unnamed: JP1.3 (B), R42.1
unnamed: JP1.2 (C), U4.22 (SDA/SMBDATA/NON_REM1)
unnamed: JP2.3 (B), R43.1
unnamed: JP2.2 (C), U4.28 (SUSP_IN/LOCAL_PWR/NON_REM0)
unnamed: JP3.2 (C), R11.2, U4.25 (HS_IND/CFG_SEL1)
unnamed: JP4.3 (B), R46.1
unnamed: JP4.2 (C), U4.24 (SCL/SMBCLK/CFG_SEL0)
unnamed: Q1.2 (G), R12.1
unnamed: Q2.2 (G), R13.1
unnamed: Q3.2 (G), R14.1
unnamed: Q4.2 (G), R18.1
unnamed: Q5.2 (G), R19.1
unnamed: Q6.3 (D), R44.1
unnamed: J16.95, Q6.1 (G)
unnamed: R23.2, SW1.2 (B), SW1.5 (B)
unnamed: R1.2, U1.4 (~SD_MODE)
unnamed: R4.1, U2.5 (ILIM)
unnamed: R6.1, U3.5 (ILIM)
unnamed: R7.1, U4.35 (RBIAS)
unnamed: R23.1, R24.2, U7.5 (EN)
unnamed: L1.1, U7.2 (SW)
unnamed: R8.1, R9.2, U8.17 (FB)
unnamed: R10.1, U8.21 (IB)
unnamed: R35.2, U8.24 (ILIM)
unnamed: R36.2, U8.23 (ISET)
unnamed: R26.1, R29.2, U8.20 (NTC)
unnamed: R2.2, U8.22 (OLIM)
unnamed: R27.2, R32.1, U8.18 (VLIM)
unnamed: R26.2, R28.1, R30.1, R31.1, R33.1, R34.1, U8.19 (VNTC)
VBUS1: C4.1 (+), C8.1, D1.2 (A), D3.1 (K), J2.1, U2.6 (OUT)
VBUS2: C12.1 (+), C16.1, D2.2 (A), D4.1 (K), J3.4, U3.6 (OUT)
VBUS_5V: C6.1 (+), C45.1 (+), C46.1 (+), C47.1 (+), J7.1 (VBUS), R8.2, R27.1, U8.1 (VL), U11.3
