heyitsarthur/COEN490/(commit log)

2025-11-20 USB and POWER
    [490_0.kicad_sch]
2025-11-20 Startted power
    [490_0.kicad_sch]
2025-11-22 Added USB hub
    [490_0.kicad_sch]
2025-11-22 Added speakers, motors and started HDMI
    [490_0.kicad_sch]
2025-11-22 Power Supply
    [490_0.kicad_sch]
2025-11-23 Phase 2
    [490_0.kicad_sch]
2025-11-27 Small update
    [490_0.kicad_sch]
2025-11-27 Changed charging circuit
    [490_0.kicad_sch]
2025-11-27 Finished USB C charger (3.3 and 5V)
    Added buck converter after the charging IC for 3.3 and 5V outputs.
2025-11-30 Arranged schematic
    Added sheets (as in the phase 2 presentation)
    [490_0.kicad_sch, board_connector_a.kicad_sch, cameras.kicad_sch, charging_power.kicad_sch, hdmi.kicad_sch, micro_sd.kicad_sch, pci_bridge.kicad_sch, power_ic.kicad_sch]
2025-11-30 US letter format
    [board_connector_a.kicad_sch, cameras.kicad_sch, charging_power.kicad_sch, hdmi.kicad_sch, micro_sd.kicad_sch, pci_bridge.kicad_sch, power_ic.kicad_sch, pushbuttons.kicad_sch]
2025-12-01 Changed some local labels to the right format
    [board_connector_a.kicad_sch, charging_power.kicad_sch, hdmi.kicad_sch, micro_sd.kicad_sch, power_ic.kicad_sch]
2025-12-01 Fixed buttons
    [power_ic.kicad_sch, pushbuttons.kicad_sch]
2025-12-01 changed local labels
    Do not use global labels if its only used in a single sheet
    [micro_sd.kicad_sch, power_ic.kicad_sch, pwm_motors.kicad_sch]
2025-12-01 Added debouncing to the buttons
    [charging_power.kicad_sch, pushbuttons.kicad_sch]
2025-12-12 Minor fixes
    [board_connector_a.kicad_sch, charging_power.kicad_sch, micro_sd.kicad_sch, pushbuttons.kicad_sch]
2025-12-12 LEDs for charger
2025-12-12 Charging circuit updates
    NTC thermal resistor
    Changed some TBD values for resistors and capacitors
    [charging_power.kicad_sch]
2025-12-13 Changed the camera connectors
    - Added 2 and 4 lane MIPI 22 lane connectors
    - Added digikey link to a good type
    [board_connector_a.kicad_sch, cameras.kicad_sch]
2026-01-15 Minor updates + USB 2.0
    [cameras.kicad_sch, pwm_motors.kicad_sch]
2026-01-15 Minor updates
    [490_0.kicad_sch, board_connector_a.kicad_sch, cameras.kicad_sch, charging_power.kicad_sch, hdmi.kicad_sch, micro_sd.kicad_sch, pci_bridge.kicad_sch, power_ic.kicad_sch]
2026-01-19 USB2.0
    Added USB2.0 circuit
    [board_connector_a.kicad_sch, speakers.kicad_sch, untitled.kicad_sch]
2026-01-19 Updated box diagram
    [490_0.kicad_sch, pushbuttons.kicad_sch, speakers.kicad_sch, untitled.kicad_sch]
2026-01-22 BOM + ESD replacement for HDMI
    Started BOM and changed ESD chips that were obsolete. Also added 2 pin connectors
    [490_0.kicad_sch, board_connector_a.kicad_sch, cameras.kicad_sch, charging_power.kicad_sch, hdmi.kicad_sch, micro_sd.kicad_sch, pushbuttons.kicad_sch, pwm_motors.kicad_sch]
2026-01-22 small commit
    [untitled.kicad_sch]
2026-01-23 Added another button + address fix
    [490_0.kicad_sch, board_connector_a.kicad_sch, charging_power.kicad_sch, pushbuttons.kicad_sch, pwm_motors.kicad_sch, speakers.kicad_sch, untitled.kicad_sch]
2026-01-27 Updated block diagram
    [490_0.kicad_sch, cameras.kicad_sch]
2026-01-27 changed PCB block diagram
    [490_0.kicad_sch, board_connector_a.kicad_sch, cameras.kicad_sch, charging_power.kicad_sch, pushbuttons.kicad_sch, untitled.kicad_sch]
2026-01-28 Changed PCB block dagram and layout
    [ButtonConnector.kicad_sch, CSIbridge.kicad_sch, CamAndSpeakConnector.kicad_sch, PCBfront.kicad_sch, TOFconnecotr.kicad_sch, board_connector_a.kicad_sch, charging_power.kicad_sch, hdmi.kicad_sch]
2026-01-29 Schematic layout update
    - applied hierarchical labels
    - cleaned up the schematic
    - finalized CM4 connections
    - checked cm4 connections
    [490_0.kicad_sch, CSIbridge.kicad_sch, CamAndSpeakConnector.kicad_sch, PCB1.kicad_sch, PCB3.kicad_sch, board_connector_a.kicad_sch, charging_power.kicad_sch, hdmi.kicad_sch]
2026-01-30 Cleaned up global labels
    TO DO: power chip change
    [490_0.kicad_sch, PCB1.kicad_sch, PCB3.kicad_sch, board_connector_a.kicad_sch, charging_power.kicad_sch]
2026-02-02 Updated power circuit
    We now have a 2 cell battery
    Chip provides 4A/5V source
    [charging_power.kicad_sch]
2026-02-03 Finished power circuit
    [charging_power.kicad_sch]
2026-02-05 Power + BOM update
    [PCB1.kicad_sch, PCB3.kicad_sch, board_connector_a.kicad_sch, charging_power.kicad_sch, hdmi.kicad_sch, powerport.kicad_sch, pushbuttons.kicad_sch, pwm_motors.kicad_sch]
2026-02-05 finished BOM
    [PCB1.kicad_sch, PCB3.kicad_sch, board_connector_a.kicad_sch, charging_power.kicad_sch, hdmi.kicad_sch, powerport.kicad_sch, pushbuttons.kicad_sch, pwm_motors.kicad_sch]
2026-02-06 Changed buck converter chip
    [PCB1.kicad_sch, board_connector_a.kicad_sch, charging_power.kicad_sch, pwm_motors.kicad_sch]
2026-02-06 Updated the schematic
    [PCB1.kicad_sch, charging_power.kicad_sch, pushbuttons.kicad_sch, speakers.kicad_sch]
2026-02-09 Implemented Dmitry comments
    [PCB1.kicad_sch, PCB3.kicad_sch, board_connector_a.kicad_sch, charging_power.kicad_sch, hdmi.kicad_sch, powerport.kicad_sch, pushbuttons.kicad_sch, pwm_motors.kicad_sch]
2026-02-11 Final Fixes
    [PCB1.kicad_sch, PCB3.kicad_sch, board_connector_a.kicad_sch, charging_power.kicad_sch, hdmi.kicad_sch, powerport.kicad_sch, pwm_motors.kicad_sch, speakers.kicad_sch]
2026-02-11 USB hub fix
    [untitled.kicad_sch]
2026-02-17 Implemented Dmitry recommendations
    [board_connector_a.kicad_sch, charging_power.kicad_sch, pwm_motors.kicad_sch, speakers.kicad_sch, untitled.kicad_sch]
2026-02-20 Added datasheets and footprints to repo
2026-02-25 Implemented suggestions
    notes on schematics:
    Overall: Schematics needs to be improved, more compact and cleaner
    =========================
    I) on root page (page 1):
    overall: needs a bit of clean up of the diagram
    1. the diagram shows pcb3 and pcb1, but no pcb2, it is probably outdated and therefore might have errors in it, fix it to the latest version and rename things to reflect what it actually is. Also try to clean it up a bit
    2. The PCB-3 seem to have the cameras directly connected to the usb hub, how will this be connected? with connectors? if so add them to the diagram, if it's with wires soldered directly to the pcb, try to make note of it for clarity
    4. for some reason your TOF is ab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
    [PCB3.kicad_sch, USBCurrentLimiter.kicad_sch, board_connector_a.kicad_sch, charging_power.kicad_sch, hdmi.kicad_sch, powerport.kicad_sch, speakers.kicad_sch, untitled.kicad_sch]
2026-02-26 FFC to HDMI change
    [PCB1.kicad_sch, PCB3.kicad_sch, TOF_HDMI_CONNECTOR_PCB1.kicad_sch, USBCurrentLimiter.kicad_sch, charging_power.kicad_sch, powerport.kicad_sch, pwm_motors.kicad_sch, speakers.kicad_sch]
2026-02-27 Footprints
    Required library of custom footprints for the PCB design
2026-02-27 Reviewed BOM
    - changed some capacitors to a more fitting voltage rating
    [TOF_HDMI_CONNECTOR_PCB1.kicad_sch, USBCurrentLimiter.kicad_sch, charging_power.kicad_sch, pwm_motors.kicad_sch, speakers.kicad_sch, untitled.kicad_sch]
2026-02-27 Footprint Update
    1st half of footprints updated
    [PCB1.kicad_sch, PCB3.kicad_sch, TOF_HDMI_CONNECTOR_PCB1.kicad_sch, USBCurrentLimiter.kicad_sch, board_connector_a.kicad_sch, charging_power.kicad_sch, hdmi.kicad_sch, powerport.kicad_sch]
2026-02-27 Footprint Update #2
    All footprints except for the capacitors have been attributed
    [USBCurrentLimiter.kicad_sch, board_connector_a.kicad_sch, charging_power.kicad_sch, hdmi.kicad_sch, powerport.kicad_sch, pwm_motors.kicad_sch, speakers.kicad_sch, untitled.kicad_sch]
2026-03-03 ToF power routing
    [PCB1.kicad_sch, PCB3.kicad_sch, TOF_HDMI_CONNECTOR_PCB1.kicad_sch, USBCurrentLimiter.kicad_sch]
2026-03-03 Changed 8conn and BOM update
    [490-24_Bill_of_Materials - External Components.xls, 490-24_Bill_of_Materials - PCB1.xls, 490-24_Bill_of_Materials - PCB2.xls, PCB1.kicad_sch, PCB3.kicad_sch, USBCurrentLimiter.kicad_sch, charging_power.kicad_sch, hdmi.kicad_sch]
2026-03-03 PCB Trial Update
    [490_0.kicad_pcb]
2026-03-03 LED names + 5V routing through ESD + renamed ESD chips to "U"
    [PCB3.kicad_sch, TOF_HDMI_CONNECTOR_PCB1.kicad_sch, USBCurrentLimiter.kicad_sch, board_connector_a.kicad_sch, charging_power.kicad_sch, hdmi.kicad_sch, powerport.kicad_sch, pwm_motors.kicad_sch]
2026-03-03 Renamed crystal + BOM update
    [490-24_Bill_of_Materials - PCB1.xls, 490-24_Bill_of_Materials - PCB2.xls, untitled.kicad_sch]
2026-03-03 Updated schematic PDF
2026-03-03 Changed ESD chip for HDMI
    [PCB3.kicad_sch, TOF_HDMI_CONNECTOR_PCB1.kicad_sch]
2026-03-03 Fixed capacitor symbols
    [pwm_motors.kicad_sch, speakers.kicad_sch]
2026-03-04 PCB Jumpstart
    [490_0.kicad_pcb, PCB3.kicad_sch, TOF_HDMI_CONNECTOR_PCB1.kicad_sch, charging_power.kicad_sch, hdmi.kicad_sch, powerport.kicad_sch, pwm_motors.kicad_sch, speakers.kicad_sch]
2026-03-04 Post-Dmitry Changes
    [490_0.kicad_pcb, pwm_motors.kicad_sch, untitled.kicad_sch]
2026-03-04 Added seperate ground for PWM motors
    [490-24_Bill_of_Materials - External Components.xls, PCB1.kicad_sch, PCB3.kicad_sch, pwm_motors.kicad_sch, untitled.kicad_sch]
2026-03-04 Updated to 10 pin connector
2026-03-04 Added 10 pin connector footprint
    [PCB1.kicad_sch, PCB3.kicad_sch]
2026-03-04 Changed footprints for pad connectors (for soldered components)
    [pwm_motors.kicad_sch, speakers.kicad_sch, untitled.kicad_sch]
2026-03-04 Changed footprint for R4 and R6 to SMD
    [USBCurrentLimiter.kicad_sch]
2026-03-04 Changed capacitor sizes
    🟢 Group 1: 100% Safe to Shrink to 0603These capacitors handle logic-level decoupling or high-frequency filtering on your 3.3V and 5V lines. Because the capacitance values are low (1µF or less), an 0603 package can easily handle the DC bias without losing performance.All 0.1µF (100nF) Capacitors: You have 25 of these scattered across the board (e.g., C35, C41, C42, C49, C53-C61). Change every single one of these to 0603.The 1µF Logic Capacitors (C48, C62): C48 sits on the VCC pin of your battery charger. C62 is on the 3.3V rail for the USB hub. Change these to 0603.The 4.7µF Capacitors (C45, C47, C50): C45 and C47 sit on the 5V VL pin. C50 filters the 5V HDMI li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
    [USBCurrentLimiter.kicad_sch, charging_power.kicad_sch, hdmi.kicad_sch, powerport.kicad_sch, pwm_motors.kicad_sch, speakers.kicad_sch, untitled.kicad_sch]
2026-03-04 Assigned capacitor footprints
    [USBCurrentLimiter.kicad_sch, charging_power.kicad_sch, hdmi.kicad_sch, powerport.kicad_sch, pwm_motors.kicad_sch, speakers.kicad_sch, untitled.kicad_sch]
2026-03-04 Changed all the resistors to 0805 size
    [USBCurrentLimiter.kicad_sch, board_connector_a.kicad_sch, charging_power.kicad_sch, pwm_motors.kicad_sch, speakers.kicad_sch, untitled.kicad_sch]
2026-03-05 PCB_2 Design Initialization
    [490_0.kicad_pcb]
2026-03-05 Added button debouncing
    [board_connector_a.kicad_sch]
2026-03-05 changed power and ground symbols for glasses
    [PCB3.kicad_sch, USBCurrentLimiter.kicad_sch, pwm_motors.kicad_sch, untitled.kicad_sch]
2026-03-05 Generated BOM
    [490-24_Bill_of_Materials - External Components.xls, 490-24_Bill_of_Materials - PCB1.xls, 490-24_Bill_of_Materials - PCB2.xls, charging_power.kicad_sch, pwm_motors.kicad_sch, untitled.kicad_sch]
2026-03-05 Changed audio chip to 5V
    It might pull to omuch if we ue the raspberry's 3.3V rail
    [speakers.kicad_sch]
2026-03-05 ERC check fix
    [PCB3.kicad_sch, USBCurrentLimiter.kicad_sch, pwm_motors.kicad_sch]
2026-03-05 Added side B for SW1
    [PCB1.kicad_sch, PCB3.kicad_sch, TOF_HDMI_CONNECTOR_PCB1.kicad_sch, USBCurrentLimiter.kicad_sch, board_connector_a.kicad_sch, charging_power.kicad_sch, hdmi.kicad_sch, powerport.kicad_sch]
2026-03-05 switch fix
    [charging_power.kicad_sch]
2026-03-05 Rerouted + external coponents update
    [490-24_Bill_of_Materials - External Components.xls, PCB1.kicad_sch, PCB3.kicad_sch, TOF_HDMI_CONNECTOR_PCB1.kicad_sch, board_connector_a.kicad_sch, charging_power.kicad_sch, powerport.kicad_sch, untitled.kicad_sch]
2026-03-05 March 3rd
    [490_0.kicad_pcb, PCB1.kicad_sch, PCB3.kicad_sch, TOF_HDMI_CONNECTOR_PCB1.kicad_sch, USBCurrentLimiter.kicad_sch, board_connector_a.kicad_sch, charging_power.kicad_sch, hdmi.kicad_sch]
2026-03-06 PCB_Glasses Implementation
    [490_0.kicad_pcb, PCB3.kicad_sch, board_connector_a.kicad_sch, charging_power.kicad_sch, pwm_motors.kicad_sch]
2026-03-06 15 pin connector mirrored
    [PCB3.kicad_sch, charging_power.kicad_sch]
2026-03-06 Changed connector 15 pin
    [PCB3.kicad_sch, charging_power.kicad_sch]
2026-03-07 Fixed button debouncing
    [board_connector_a.kicad_sch]
2026-03-09 Git PCB Fix
    [490_0.kicad_pcb]
2026-03-09 Some changes
    [490_0.kicad_pcb]
2026-03-09 Placed 100 pin connectors
    [490_0.kicad_pcb, board_connector_a.kicad_sch]
2026-03-09 Button debouncing fix
    [board_connector_a.kicad_sch]
2026-03-10 started routing up to HDMI ESD impedance matching
    [490_0.kicad_pcb, TOF_HDMI_CONNECTOR_PCB1.kicad_sch, charging_power.kicad_sch, hdmi.kicad_sch]
2026-03-10 HDMI to ESD diff pairs routed
    [490_0.kicad_pcb]
2026-03-10 Finished ESD diff pairs routing
    [490_0.kicad_pcb]
2026-03-10 Changed microHDMI to normal HDMI because of the footprint
    [490_0.kicad_pcb, hdmi.kicad_sch]
2026-03-10 Routing ESD to 100 pin connector
    [490_0.kicad_pcb, hdmi.kicad_sch]
2026-03-10 Final push
    [490_0.kicad_pcb]
2026-03-10 PCB merged, now schematic
    [490_0.kicad_pcb]
2026-03-10 All merged up! 03-10
    [490_0.kicad_pcb, PCB3.kicad_sch, untitled.kicad_sch]
2026-03-10 Wired up screen HDMI to 100pin
    [490_0.kicad_pcb]
2026-03-10 Still need to wire diff pairs from FFC HDMI
    [490_0.kicad_pcb]
2026-03-11 Speaker circuit
    [490_0.kicad_pcb]
2026-03-11 small push
    [490_0.kicad_pcb]
2026-03-11 Routed the FFC HDMI to 100conn
    [490_0.kicad_pcb]
2026-03-11 added a few grounds around signal vias
    [490_0.kicad_pcb]
2026-03-11 Place CM4 footprint, starting to reroute everything
    [490_0.kicad_pcb, powerport.kicad_sch]
2026-03-11 Removed ports from below the CM4
    [490_0.kicad_pcb]
2026-03-11 Eliminated some acidtraps
    [490_0.kicad_pcb]
2026-03-11 Connected microUSB port
    [490_0.kicad_pcb]
2026-03-12 Routed j18
    [490_0.kicad_pcb]
2026-03-12 Changed pin assignment for the buttons on PCB1 in the schematic
    [490_0.kicad_pcb, board_connector_a.kicad_sch]
2026-03-12 Routed buttons
    [490_0.kicad_pcb]
2026-03-12 Routed LED for the 100con
    [490_0.kicad_pcb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]
2026-03-12 Routed other LED
    [490_0.kicad_pcb]
2026-03-12 almost finished charging
    [490_0.kicad_pcb, board_connector_a.kicad_sch, charging_power.kicad_sch]
2026-03-12 Routed the 7.4V line in a weird way
    [490_0.kicad_pcb]
2026-03-12 Charging circuit finished
    [490_0.kicad_pcb]
2026-03-12 Routing done, nned to fit into PCB
    [490_0.kicad_pcb]
2026-03-12 merged with Ardi (PCB glasses)
    [490_0.kicad_pcb]
2026-03-12 Merged schematic
    [490_0.kicad_pcb, PCB3.kicad_sch, PCB3_ARDI.kicad_sch]
2026-03-12 Thicker copper pour
    [490_0.kicad_pcb]
2026-03-12 added terdrop for 5Vbus
    [490_0.kicad_pcb]
2026-03-12 Fixing vias and acidtraps
    [490_0.kicad_pcb]
2026-03-13 set the PCB size to match glasses
    [490_0.kicad_pcb]
2026-03-13 Finished PCB1 routing
    [490_0.kicad_pcb, TOF_HDMI_CONNECTOR_PCB1.kicad_sch]
2026-03-13 Ground shields
    [490_0.kicad_pcb]
2026-03-13 Diif pair fix
    [490_0.kicad_pcb]
2026-03-13 Merged with Ardi
    [490_0.kicad_pcb]
2026-03-13 Changed the HDMI connections on glasses
    [PCB3.kicad_sch]
2026-03-13 Friday, March 13th: PCB Planes Addition
    [490_0.kicad_pcb]
2026-03-20 Friday, March 20th: PCB Final for BOM
    [2000-1-1-20-00-BK.igs, 490_0.kicad_pcb, PCB1.kicad_sch, PCB3.kicad_sch, TOF_HDMI_CONNECTOR_PCB1.kicad_sch, USBCurrentLimiter.kicad_sch, board_connector_a.kicad_sch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]
2026-03-22 Updated BOM
    [490-24_Bill_of_Materials - External Components.xls, 490-24_Bill_of_Materials - PCB1.xls, 490-24_Bill_of_Materials - PCB2.xls, PCB3.kicad_sch]
2026-04-03 Final commit
    [490_0.kicad_pcb]
